pkppkqsmall/MSPM0G3507-NUEDC-H-Ball-Car/Firmware/KnowledgeBase/car_parameters.md

# 小车参数记录

> 当前运行入口是 `App/MapRun/map_run.c`。本文只记录当前连续巡线地图程序
> 仍在使用的参数，完整操作见 [`../README_MAP_RUN.md`](../README_MAP_RUN.md)。

## 硬件方向

| 项目 | 当前约定 |
| --- | --- |
| 左轮 PWM 正值 | 小车前进方向 |
| 右轮 PWM 正值 | 硬件方向相反，由底层符号统一为小车前进 |
| 速度目标正值 | 小车前进 |
| yaw 正方向 | 串级控制假设左转为正，首次测试必须手动旋转确认 |

右轮方向统一在电机驱动内部完成：

```c
#define RIGHT_WHEEL_DIRECTION_SIGN (-1.0f)
```

应用层始终使用“左右轮正 RPM 都表示小车前进”的语义。

## 当前底盘

当前使用 WHEELTEC R3X 加大版三轮差速底盘。

| 项目 | 当前值 |
| --- | ---: |
| 底板外形 | `320 x 240 x 5 mm` |
| 左右驱动轮中心距 | 模型标注约 `214.2 mm` |
| 驱动轮轴至万向轮轴距 | 模型标注约 `204.7 mm` |
| 轮胎直径 | `65 mm` |

模型尺寸只用于建立初始参数，左右轮中心距和传感器前伸距离应在装车后实测。

## 电机和编码器

| 参数 | 当前值 |
| --- | --- |
| 编码器线数 | `13 PPR` |
| 当前等效计数倍频 | `2` |
| 减速比 | `1:28` |
| 电机轴每圈计数 | `13 * 2 = 26` |
| 车轮输出轴每圈计数 | `26 * 28 = 728`，现场实测约 `728` |
| 测速采样周期 | `20 ms` |

按 `65 mm` 轮径估算：

```text
每圈周长约 204.2 mm
每厘米约 35.65 count
```

## 电机驱动和速度环

| 参数 | 当前值 | 说明 |
| --- | ---: | --- |
| 电机死区补偿 | `56%` | 电机约在该占空比开始稳定转动 |
| 固定小底座 | `1%` | 高于死区的额外补偿 |
| 起步脉冲时间 | `0 ms` | 当前不启用额外起步脉冲 |
| 低速开环范围 | `0~30 RPM` | 直接按目标 RPM 映射 PWM |
| 速度环 Kp | `0.1` | 左右轮相同 |
| 速度环 Ki | `0.2` | 左右轮相同 |
| 速度环 Kd | `0` | 当前未使用 D |

速度测试目标可通过 `TARGET` 修改，PI 可通过 `PID` 修改。

## 灰度传感器

当前使用感为 8 路灰度模块的串行输出，黑线为 `1`、白底为 `0`。

| 项目 | 当前约定 |
| --- | --- |
| `INPUT1` / bit0 | 车头最左侧，单独命中显示 `00000001` |
| `INPUT8` / bit7 | 车头最右侧，单独命中显示 `10000000` |
| 探头权重 | `{-16.0, -8.0, -4.0, -2.0, 2.0, 4.0, 8.0, 16.0}` |
| 黑线偏左 | 误差为负 |
| 黑线偏右 | 误差为正 |
| 运行中丢线 | 保持最后有效灰度修正和左右轮目标，不自动停机 |

程序保留每次读取的原始位图，直接计算所有黑色探头的平均权重。
不使用位图多数表决或灰度误差低通。中心探头只给小目标角速度，
向外逐级增强；BNO085 失效时才使用 `Kp=2.5` 的灰度 P 回退。

## 当前地图巡线参数

参数分别位于 `App/MapRun/map_run.c` 和 `map_line_controller.c`。

| 参数 | 当前值 | 作用 |
| --- | ---: | --- |
| `MAP_RUN_Q2_BASE_SPEED_RPM` | `120.0` | M1 / 第 2 问基础速度 |
| `MAP_RUN_Q2_BRAKE_HOLD_MS` | `100` | M1 横线确认后的主动刹车时间 |
| Q3 正程预测切换 | `Peak=X+0.85*clamp(V,0,80)`，预测 `>=+39 mm` | `0.60 s` 预测实测正峰值仍约 `+69 mm`，延长预测窗以覆盖摄像头采样和步进换向滞后 |
| Q3 固定折返驱动 | `+3.0° -> RawX<=+20 mm 且 V<=-100 mm/s` | `+34 mm` 制动只到 `-28 mm`，`0 mm` 制动冲到 `-84 mm`，取插值折中 |
| Q3 终点目标位置 | `-50 mm` | M2 / 第 3 问最后稳定点 |
| Q3 终点最高速度 / 位置比例 | `35 mm/s / 1.2/s` | 终点自适应阶段随剩余距离主动减速 |
| Q3 终点包络渐变区 | `6~15 mm` | 近端位置反馈与远端速度反馈线性切换 |
| Q3 速度能量制动 | `|V|+40 mm/s / 70 mm / 增益3.0 / -1.5~-3.0° / 75%单帧速度` | 左移阶段只增强负制动角，先消耗返程动能 |
| Q3 负端预捕获 | `RawX<=-35 mm / 融合|V|<=70 mm/s / +2.2° / >=100 ms` | 上轮在真实回弹后才触发，放宽动量门槛以提前约一帧补偿步进换向延迟 |
| Q3 终点自适应交接下限 | `RawX<-30 mm` | `-35 mm` 静止时直接交给终点自适应；只有停在 `-30 mm` 之前才重新固定送球 |
| Q3 捕获位置-速度 PD | `Vref=clamp(-1.5*(RawX+50), ±60 mm/s)`；`Angle=1.8+clamp(0.040*(V-Vref), ±2.4°)` | 首轮 `5.13 s` 完成但出现一次 `-15~-67 mm` 摆动；降低位置速度并提高阻尼，不使用积分 |
| Q3 终点捕获 | 即时速度与聚合速度同时 `|V|<=12 mm/s`，连续 `75 ms` | 首次回弹继续由能量制动吸收；若双速度低速时仍在 `-40 mm` 前，则恢复固定 `+3.0°` 继续送球，进入负端后才允许冻结或进入终点自适应 |
| Q3 静摩擦位置补偿 | `8 mm / 6 mm/s / 0.5 mm / ±4.5°` | 低速且连续帧几乎不动时直接下发破静摩擦目标角，不再逐帧爬坡；检测到位移后恢复滤波和 `±3.5°` 普通限位 |
| Q3 高速越界制动 | `15 mm/s / ±4.5° / 5 s` | 进入终点闭环保留当前制动角的受限部分；仅在越过目标且继续远离时绕过一次角度斜率 |
| Q3 低动确认 / 终点验稳 | `100 ms / 250 ms` | 连续低动后冻结当前实际角度；冻结窗口摆幅 `<=2 mm` 且末端球速 `<=4 mm/s` 才完成，完成后仅离开 `-60~-40 mm` 才恢复自适应 |
| Q3 终点初始平衡偏置 | 制动角限制到 `±2.0°` 后接管 | 以 `+1.8°` 为负端坡度初估，再由积分学习当前管段的不水平、弯曲和静摩擦 |
| `MAP_RUN_Q4_BASE_SPEED_RPM` | `88.0` | M3 / 第 4 问 A→B 巡航速度 |
| `MAP_RUN_Q4_START_SPEED_RPM` | `30.0` | M3 最低可用起步速度 |
| `MAP_RUN_Q4_START_HOLD_MS` | `200` | 起步前先让滚球闭环稳定 |
| `MAP_RUN_Q4_START_RAMP_MS` | `1400` | M3 从 30 通过 S 曲线升到 88 RPM |
| `MAP_RUN_Q4_START_FF_PEAK_DEG` | `-1.30°` | 起步加速度前馈；仅在 `X>=-2 mm` 后按回中速度退出，`10 mm/s` 时完全退出 |
| Q4 起步预置角 / 渐入 / 渐出 | `-0.85° / 180 ms / 600 ms` | 提前让步进到位，并覆盖底盘由 0 升到最低可用 30 RPM 后的早期扰动 |
| `MAP_RUN_Q4_BRAKE_FF_PEAK_DEG` | `+0.70°` | 更长距离减速阶段的前馈峰值 |
| `MAP_RUN_Q4_FINAL_STOP_RAMP_MS` | `900 ms` | 越过 B 点后把当前左右轮 PWM 按 S 曲线缓慢降到 0 |
| `MAP_RUN_Q4_FINAL_STOP_FF_PEAK_DEG` | `+0.45°` | 适配较缓停车斜坡的钟形制动项 |
| `MAP_RUN_Q4_STOP_FF_DEG` | `+0.80°` | PWM 归零后仅在球位于正侧且继续向正侧滚动时保留；反向回中或 `X<-8 mm` 时禁用 |
| `MAP_RUN_Q4_STOP_FF_HOLD_MS` | `300 ms` | 接球角最长保持时间 |
| `MAP_RUN_Q4_STOP_FF_FADE_MS` | `500 ms` | 接球角无反向回中时的平滑退出时间 |
| Q4 中心保护死区 | `2 mm` | 小偏差仍交给原 PID，超过后更早加强纠偏 |
| Q4 中心保护增益 / 上限 | `0.055°/mm / 0.75°` | 仅在静止、远离中心或回中偏慢时介入 |
| Q4 短窗估速 / 阻尼 | `35~140 ms / 0.018°/(mm/s) / 0.90°` | 换向时优先采用新方向，抑制低摩擦时反复穿过中心 |
| Q4 行驶回中最高速度 / 位置比例 | `15 mm/s / 0.50/s` | 以 `0 mm` 为终点，更早对回中速度制动 |
| Q4 停车保持最高速度 / 位置比例 | `15 mm/s / 0.5/s` | `±10 mm` 内柔和保持；超界且球速不高于 `6 mm/s` 时附加 `0.10°/mm`、最大 `1.0°` 回中保护 |
| Q4 中心误差缩放 | `0.5` | 仅在误差绝对值不超过 `2.1` 时生效 |
| Q4 小球目标位置 | `0 mm` | 按键起跑后自动开启中心保持 |
| Q4 起跑位置范围 | `±10 mm` | 超出范围拒绝起跑，避免一开始即失分 |
| Q4 摄像头失联阈值 | `300 ms` | 超时后停用旧位置反馈，只保留底盘加减速前馈；底盘继续循迹 |
| 短时丢球预测 | `40 ms 后启动 / 100 ms 衰减 / ±12 mm` | 用最后有效位置和衰减球速跨过少量无效帧或断帧 |
| `MAP_RUN_BALL_BASE_SPEED_RPM` | `85.0` | M4/M5 共用稳态基础速度 |
| `MAP_RUN_BALL_START_SPEED_RPM` | `30.0` | M4/M5 静止预置后的最低可用起步速度 |
| `MAP_RUN_BALL_START_HOLD_MS` | `200` | 底盘保持静止，让摆杆预置角先到位 |
| `MAP_RUN_BALL_START_RAMP_MS` | `1400` | 带球模式从 30 通过 S 曲线升到 85 RPM |
| M4/M5 起步预置 / 前馈 | `-1.05° / 180 ms / 600 ms`，峰值 `-1.55°`，起步合成限幅 `2.2°` | 避免共用 `1.5°` 限幅截断预置角与起步前馈 |
| M4/M5 短窗估速 / 阻尼 | `35~140 ms / 0.018°/(mm/s) / 0.90°` | 换向时优先采用新方向，提前撤销回拉角 |
| M4/M5 终点缓停 / 前馈 | `500 ms`，峰值 `+0.80°` | 捕获左右轮 PWM 后同比例平滑降到 0 |
| M4/M5 行驶回目标包络 | `20 mm/s / 0.75/s` | Q5 回中心，Q6 回本轮指定位置 |
| M4/M5 停车保持包络 | `15 mm/s / 0.5/s` | 通过 A 后继续保持；漂出 `±10 mm` 且近似静止时启用温和位置保护 |
| M4/M5 起跑误差 / 运行允许误差 | `10 mm / 10 mm` | 起跑超差拒绝启动，运行超差记为 OVER |
| M4/M5 视觉失联阈值 | `300 ms` | 超时不停车，摆杆回标定水平，恢复后接管 |
| M4/M5 完成时间 | `30 s` | 与最大误差共同决定 PASS/LATE/OVER |
| M4/M5 精简蓝牙周期 | `250 ms` | 自动输出 `Q5BALL/Q6BALL`，完成后延续 5 s；完整 BALLLOG 开启时暂停 |
| 带球中心误差缩放 | `0.25` | 误差绝对值不超过 `2.1` 时生效，降低直线左右摆动 |
| 带球转向比例 | `当前基础速度 / 80` | 稳态 85 RPM 时约为 `1.063` |
| 带球内轮最低目标 | `25 RPM` | M3/M4/M5 边缘探头触发时不再直接降为 0 |
| 带球外轮最高目标 | `95 RPM` | 满纠偏时比稳态基础速度最多增加 10 RPM |
| 带球单轮目标上升 | `3 RPM/10 ms` | 限制突然加速，减速不延迟 |
| 带球外侧误差增益 | `1.5` | 只放大误差绝对值超过 `2` 的部分 |
| 带球中心速度恢复 | `1 RPM/10 ms` | 降低带球模式出弯加速度 |
| 右弯保持最低角速度 | `30 deg/s` | 灰度回中后仍维持半圆所需曲率 |
| 右弯提前触发 | 右三探头连续 2 次 | 仅在靠近 B/D 的编码器区域生效 |
| 弯尾最低角速度 | `170~175°` 内由 `30` 降至 `10 deg/s` | 减少进入直道时的残余旋转 |
| 右弯正常退出 | `175° + 中线 3 次` | BNO085 跨界累计角与灰度共同判断 |
| 右弯强制释放 | `190°` | 中线漏检时避免持续右转 |
| 出弯灰度渐入 | `50 ms` 消旋 + `200 ms` 渐入 | 避免灰度控制由 0 瞬间恢复造成摆动 |
| 出弯对正阈值 | `5 deg/s，连续 3 次`，最长 `400 ms` | 稳定后提前结束，超时则恢复普通巡线 |
| `MAP_RUN_LOW_TARGET_STOP_RPM` | `30.0` | 内轮目标不高于该值时直接停驱动 |
| 灰度到目标角速度 | `-5.0 * line_error` | 黑线偏右时生成负角速度 |
| 目标角速度上限 | M1/Q2 无；其它模式 `±60 deg/s` | 第二问使用完整灰度误差 |
| yaw 角速度低通 | `alpha=0.35` | 抑制相邻 yaw 求导噪声 |
| 角速度前馈 | `0.55 RPM/(deg/s)` | 根据底盘几何估算差速 |
| 角速度 P | `0.15 RPM/(deg/s)` | 修正目标与实测角速度差 |
| 差速上限 | M1/Q2 无；其它模式 `±40 RPM` | 带球模式继续保留保护 |
| 中心速度恢复 | M1/Q2 无；M3 `2 RPM/10 ms`；M4/M5 `1 RPM/10 ms` | M1 外轮固定基础速度 |
| BNO085 回退 | `150 ms` | 数据超时后使用灰度 `Kp=2.5` |
| 地图单轮目标上限 | 无 | 最终 PWM 仍由底层限制在 `100%` |
| `MAP_RUN_CONTROL_PERIOD_MS` | `10` | 灰度外环周期 |
| `MAP_RUN_SPEED_PERIOD_MS` | `20` | 编码器测速和速度 PI 周期 |
| `MAP_RUN_TELEMETRY_PERIOD_MS` | `50` | VOFA 输出周期 |

M1 起跑后使用 `120 RPM`；M3 巡航使用 `88 RPM`；M4/M5 静止预置
`200 ms` 后从 `30 RPM` 在 `1400 ms` 内升到 `85 RPM`。M3 在中心 4/5 号探头区域把误差与
回退修正减半；M4/M5 复用相同中心整形，不再低通误差，并按当前
基础速度相对 `80 RPM` 的比例缩放转向需求。
运行中全白时，M4/M5 保持最后灰度误差并继续角速度环，其他模式保持
最后左右轮目标；重新找到黑线后继续使用实时灰度误差。
M1/Q2 转弯时外轮固定 `120 RPM`，只降低内轮，不再使用中心速度缓慢
恢复。M4/M5 将内轮最低目标保持在 `25 RPM`，
外轮按转向强度提高并限制在 `90 RPM`，单轮目标增加量限制为每周期
`3 RPM`；减速不延迟。M3 出弯中心速度每周期恢复 `2 RPM`，M4/M5
每周期恢复 `1 RPM`。M4/M5
保持 `85 RPM` 基础速度，但将绝对值超过 `2` 的误差增量放大 `1.5`
倍，让弯道转向更早建立。B/D 附近最外两路可在宽窗口内触发，右侧
第三路在更靠近弯道的位置连续确认 2 次也可提前触发。保持期间 BNO085
累计右转角；`170~175°` 逐步减小最低右转量，随后通过灰度渐入进入直道。

左右轮目标为：

```text
target_yaw_rate = clamp(-5.0 * line_error, -60, +60)
turn_rpm = clamp(0.55 * target_yaw_rate
                 + 0.15 * (target_yaw_rate - measured_yaw_rate),
                 -40, +40)
center_rpm = selected_base_rpm - abs(turn_rpm)
left_target  = center_rpm - turn_rpm
right_target = center_rpm + turn_rpm
```

串级失效时回退到灰度 P：普通模式外轮保持基础速度，M4/M5 外轮按
转向强度提高至最高 `95 RPM`；内轮仍按 P 修正降低。普通模式任一路
目标不高于 `30 RPM` 时
直接设为 `0 RPM`；M3/M4/M5 则最低保持 `25 RPM`，避免边缘触发产生
`0↔85 RPM` 跳变。

编码器不直接生成弯道差速，但 M4/M5 使用宽距离窗口限制右弯保持的
触发路段；M1/M4/M5 还用于测速、反馈故障保护和一圈终点解锁，
M3 额外用于 A→B 停车。

## 一圈停车参数

| 参数 | 当前值 | 作用 |
| --- | ---: | --- |
| `MAP_RUN_START_LINE_LEAVE_COUNTS` | `120` | 防止起点横线立即被当作终点 |
| `MAP_RUN_LAP_ARM_COUNTS` | `21300` | 达到该路程后允许 3 路黑线触发终点 |
| `MAP_RUN_BALL_FIXED_STOP_COUNTS` | `25590` | Q5/Q6 平均编码器写死停车距离，比上一实测点缩短约 0.5 m |
| `MAP_RUN_BALL_FIXED_STOP_MAX_COUNTS` | `28220` | IMU 异常时强制停车，防止 Q5/Q6 无限绕圈 |
| `MAP_RUN_BALL_FIXED_STOP_TURN_DEG` | `360` | Q5/Q6 正常同时要求的累计实际转动量；IMU 无新数据、超时或近似 0° 时由编码器终点接管 |
| `MAP_RUN_FINISH_HEADING_ARM_COUNTS` | `21000` | M1 最后一段启用起跑航向外环 |
| `MAP_RUN_FINISH_HEADING_KP_RATE_PER_DEG` | `2.0` | 航向误差到目标角速度的比例 |
| `MAP_RUN_FINISH_HEADING_RATE_LIMIT_DEG_S` | `40` | 航向修正最大角速度，单位 deg/s |
| `MAP_RUN_FINISH_LINE_ACTIVE_MIN` | `3` | 5 cm 横线至少同时命中的黑色探头数 |
| `MAP_RUN_START_LINE_LEAVE_CONFIRM` | `3` | 离开起点连续确认次数 |
| `MAP_RUN_FINISH_LINE_CONFIRM` | `3` | 终点横线连续确认次数 |

M1 的编码器距离只负责解锁终点识别，真正停车条件仍是再次检测到 A 点横线，
即 `21300 count` 后至少 3 路黑线连续 3 帧。M4/M5 不再使用横线，平均
编码器达到 `25590 count` 且 BNO085 累计实际转动达到 `360°` 后直接缓停；若 IMU 无新数据、已超时或全程转角近似 `0°`，则由该编码器终点直接触发。
M1 在相同距离后将起跑 yaw 作为目标航向，并把航向误差转换成目标角速度
叠加到灰度外环，再由 BNO085 角速度内环和轮速 PI 完成出弯对正。
M1 横线确认后让 AT8236 保持 `IN1=IN2=1` 主动刹车 `100 ms`，随后
恢复四路低电平；M4/M5 不使用该急刹策略，关闭底盘后继续运行滚球
位置跟踪并切换到较慢停车保持包络。

## 第 4 问 A→B 停车参数

| 参数 | 当前值 | 作用 |
| --- | ---: | --- |
| `MAP_RUN_Q4_SENSOR_ARM_COUNTS` | `4500` | 该距离后才允许右二探头锁存 B 点特征 |
| `MAP_RUN_Q4_RIGHT_SECOND_MASK` | `0x40` | 右边第二个探头，即 bit6 |
| `MAP_RUN_Q4_BRAKE_START_COUNTS` | `4950` | B 点前开始平滑减速 |
| `MAP_RUN_Q4_TARGET_STOP_COUNTS` | `5700` | 已锁存右二黑时，越过 B 点约 9.8 cm 后触发缓停 |
| `MAP_RUN_Q4_MAX_STOP_COUNTS` | `5950` | 传感器未锁存时的缓停兜底触发距离 |
| `MAP_RUN_Q4_APPROACH_SPEED_RPM` | `35.0` | 到正常停车距离时的中心速度 |

第四问前馈在底盘速度轨迹存在加速度时叠加到滚球控制角，普通巡航阶段为
`0°`。距离减速前半段升到 `+0.70°` 后保持，直至最终停车连续接管。
达到终点条件后，程序捕获左右轮实际占空比并在 `900 ms` 内按
S 曲线降到 0；同期从 `+0.70°` 连续接管并叠加峰值 `+0.45°` 的钟形项。
停车后只有小球仍位于正侧并继续向正侧滚动时才保留接球角；若已经越过
中心或已经反向，则不重新施加固定正角，避免停车后二次推向负侧。
`BALL?` 和 `MAP?` 的
`FF` 字段可用于确认实际方向和幅值。`MAP?` 的 `Guard/Damp` 字段显示第四问
中心保护输出；球处于 X 正侧时为正，处于 X 负侧时为负。球已经按规划
速度向中心运动时 `Guard` 会降为 0，`Damp` 则始终与小球速度同号以提供阻尼。

`5700/5950 count` 只负责触发最后缓停，完成时间还会增加最多 `0.9 s`，
预计多前进约 `2~3 cm`。纯计时不参与停车，OLED 只显示实测总用时。

## 按键

| 按键 | 引脚 | 当前作用 |
| --- | --- | --- |
| B21 / PIN_Button | `PB21` | 短按启动或立即停车；M5/Q6 短按先采集当前球位目标；停止时长按进入灰度校准 |
| SW1 / PIN_Button_SW1 | `PA29` | 停止时选择上一个题目模式 |
| SW2 / PIN_Button_SW2 | `PA30` | 停止时选择下一个题目模式 |

题目模式为 `M1=第2问`、`M2=第3问`、`M3=第4问`、`M4=第5问`、
`M5=第6问`。上电默认 M1；M1 已接入第 2 问整圈运行，M2 已接入
静止滚球 `0 -> +5 cm -> -5 cm`，M3 已接入 A→B 底盘运行，M4/M5
已接入共用的 85 RPM 带球循迹、自动滚球闭环、30 s/最大误差统计；
M4 固定中心目标，M5 使用赛前保存的任意指定目标。

## 蓝牙串口

| 项目 | 当前值 |
| --- | --- |
| UART | `UART0` |
| RX | `PA11` |
| TX | `PA10` |
| 波特率 | `115200` |

常用命令：

```text
STOP
TARGET,50
TARGET,50,48
TARGET?
PID,0.1,0.2,0
PID?
START
CAR?
LINE?
MAP?
MODE?
MAP
HELP
```

`TARGET` 会选择速度测试模式，`MAP` 会选择地图巡线模式；随后发送
`START` 启动当前所选模式。`MODE?` 查询按键选中的题目模式。M1 地图
模式使用灰度位置、yaw 角速度和轮速 PI 串级，不计算编码器路段前馈。

## 调参顺序

1. 确认左右电机与编码器方向一致。
2. 停机时用 `LINE?` 确认左右灰度符号没有反。
3. 手动向左旋转车身，使用 `MAP?` 确认实测 yaw 角速度为正。
4. 使用 `MAP?` 核对灰度误差、目标/实测角速度、串级状态和左右轮目标。
5. 左右摆动先调整灰度到角速度增益或角速度 P，不要先改速度 PI。
6. 圆弧半径不对先调整角速度前馈，再考虑统一基础速度。
7. 运行中丢线不会自动停机，实车测试时必须保留人工停机手段。
