pkppkqsmall/MSPM0G3507-NUEDC-H-Ball-Car/Firmware/KnowledgeBase/tuning_log.md

# 调参记录

## 文档用途

每次改参数后，把场地、现象、处理和实际结果写在这里。当前基准以
`App/MapRun/map_run.c` 的椭圆地图连续巡线为准。

## 记录模板

```text
日期：
场地/赛道：
电池电压：
基础速度：
巡线参数：
速度环参数：
现象：
处理：
结论：
下一步：
```

## 当前基准参数

| 分类 | 参数 | 当前值 |
| --- | --- | ---: |
| 基础速度 | 题目模式 | M1 `120`、M3 `30→88 RPM/1400 ms`；M4/M5 `200 ms` 预置后 `30→85 RPM/1400 ms` |
| 目标速度渐变 | 地图巡线 | M1 外轮固定基础速度；M3 出弯恢复 2 RPM/10 ms，M4/M5 为 1 RPM/10 ms |
| 灰度到目标角速度 | 外环 | `-5.0`；M1/Q2 不限幅，其它模式限制 `±60 deg/s` |
| yaw 角速度低通 | 内环反馈 | `alpha=0.35` |
| 角速度前馈 / P | 差速输出 | `0.55 / 0.15` |
| 差速上限 | `turn_rpm` | M1/Q2 无；其它模式 `±40 RPM` |
| 灰度 P 回退 | BNO085 超时 | `Kp=2.5`，`150 ms` 后启用 |
| 内轮低速处理 | `MAP_RUN_LOW_TARGET_STOP_RPM` | `<=30 RPM` 时停驱动 |
| 灰度外环周期 | `MAP_RUN_CONTROL_PERIOD_MS` | `10 ms` |
| 速度内环周期 | `MAP_RUN_SPEED_PERIOD_MS` | `20 ms` |
| VOFA 周期 | `MAP_RUN_TELEMETRY_PERIOD_MS` | `50 ms` |
| 速度环 Kp | 左右轮 | `0.1f` |
| 速度环 Ki | 左右轮 | `0.2f` |
| 运行中丢线 | 地图巡线 | 保持最后有效修正和左右轮目标，不自动停机 |

## 已知结论

| 主题 | 结论 |
| --- | --- |
| 巡线外环 | 灰度权重平均生成目标 yaw 角速度，不使用灰度 I/D 或路段前馈。 |
| 角速度内环 | 相邻 yaw 求导并低通，前馈加 P 反馈生成左右差速。 |
| 速度内环 | 高于 30 RPM 使用 `PI + 死区补偿`。 |
| 目标变化 | M4/M5 平滑起步，其余模式直接给基础速度；转向立即生效；出弯中心速度缓恢复；丢线保持原目标。 |
| 左右摆动 | 优先调整灰度到角速度增益或角速度 P，不先修改速度 PI。 |
| 圆弧跟随 | 先核对目标/实测角速度符号，再调整角速度前馈或基础速度。 |
| 丢线 | 保留最后灰度 P 方向、基础速度和左右轮目标，不自动停机。 |
| 编码器 | A 相双边沿、B 相判向，车轮实测约 728 count/圈。 |
| 一圈停车 | 编码器负责终点解锁，A 点横线负责最终停车确认。 |

## 2026-05-05

| 项目 | 内容 |
| --- | --- |
| 场地/赛道 | 旧小车循迹赛道 |
| 电池电压 | 未记录 |
| 默认速度 | `50 RPM` |
| 现象 | 巡线有突然加速感。 |
| 处理 | 在巡线外环加入修正变化限速，并在起停和模式切换时清零修正状态。 |
| 结论 | 已提交 Git：`45d5cb5 Smooth line-follow correction transitions`。 |
| 后续价值 | 这是旧状态机的历史方案；当前 MapRun 已暂停所有巡线目标斜率。 |

## 2026-07-10

| 项目 | 内容 |
| --- | --- |
| 场地/赛道 | 旧小车循迹赛道 |
| 电池电压 | 未记录 |
| 默认速度 | `50 RPM` |
| 现象 | 左右摇晃偏大，巡线修正和目标速度变化偏激进。 |
| 处理 | 降低旧巡线增益、最大修正量和目标变化速度，并减小中间探头权重。 |
| 结论 | 经验保留；当前 R3X 底盘需要重新实测，不能直接照搬旧参数。 |

## 2026-07-29 R3X 地图基准

| 项目 | 内容 |
| --- | --- |
| 场地/赛道 | H 题椭圆地图，R3X 320 x 240 mm 底盘 |
| 电池电压 | 待记录 |
| 基础速度 | `60 RPM`，从 `32 RPM` 平滑起步 |
| 巡线参数 | 增益 `1.80`，补偿不独立限幅，修正斜率 `0.15 RPM/ms` |
| 安全保护 | 起跑全白拒绝启动；持续约 150 ms 丢线停机；无编码器反馈停机 |
| 现象 | 新底盘直接冲出线，旧丢线逻辑会在全白后继续直行。 |
| 处理 | 改为保持最后找线方向、短时降速和持续丢线强制停车；增加 `LINE?` 静态诊断。 |
| 结论 | 源码和构建验证通过，60 RPM 的圆弧稳定性仍需实车验证。 |
| 下一步 | 记录电池电压、直线摆幅、圆弧最大误差和一圈用时。 |

## 2026-07-29 100 RPM 比赛配置

| 项目 | 内容 |
| --- | --- |
| 场地/赛道 | H 题 1.5 m 直线加半径 0.5 m 双半圆 |
| 速度规划 | 直线 `100 RPM`，右弯 `95 RPM`，终点降到 `60 RPM` |
| 前探距离 | 灰度至驱动轮轴线约 `13 cm`，对应 `463 count` |
| 弯道前馈 | 几何值 `20.3 RPM`；实车转向不足后改为 `1.5` 倍，即约 `30.5 RPM`，左/右基础目标约 `125.5/64.5 RPM` |
| 灰度控制 | 非线性权重加浮点位置低通，`Kp=5.0, Kd=0.05`，不再逐位多数表决 |
| 周期 | 灰度 `10 ms`，速度 PI `20 ms`，VOFA `50 ms` |
| 理论用时 | 约 `18.5 s`，尚未完成实车验收 |
| 风险 | 电机在 115 RPM 附近的负载跟随能力尚未验证 |

## 2026-07-30 简化为灰度 P

| 项目 | 内容 |
| --- | --- |
| 基础速度 | 全程 `100 RPM`，启动后直接给定 |
| 灰度权重 | `{-16, -8, -4, -2, 2, 4, 8, 16}`；中心轻修正、外侧强修正 |
| 灰度控制 | `line_p = 2.5 * line_error` |
| 速度内环 | 左右轮 PI：`Kp=0.1, Ki=0.2`，周期 `20 ms` |
| 已移出控制链 | 编码器 B/C/D 路段规划、弯道前馈、灰度 D、误差低通、修正斜率和基础速度渐变 |
| 出弯调整 | 中间权重减小以抑制反复过冲 |
| 内轮调整 | 外轮不再加速，全部 `2P` 差速改由内轮降速；内轮目标不高于 `30 RPM` 时停驱动 |
| 直线调整 | 单路命中从中心到外侧时，内轮目标约为 `90、80、60、0 RPM`，降低目标突变对小球的影响 |
| 丢线调整 | 运行中全白保持丢线前目标，不再降速或自动停机 |
| 保留功能 | 编码器反馈保护、人工停机和 A 点一圈停车 |

## 2026-07-30 尝试加入 yaw 角速度串级

| 项目 | 内容 |
| --- | --- |
| 回退点 | Git `13cd0df`，保留纯灰度 P 版本 |
| 控制结构 | 灰度位置 -> 目标 yaw 角速度 -> BNO085 角速度前馈/P -> 轮速 PI |
| 目标角速度 | `-5 * line_error`，限制 `±60 deg/s` |
| 角速度估计 | BNO085 `50 Hz` 新样本求导，处理 `±180°` 跨界，低通 `alpha=0.35` |
| 差速参数 | 前馈 `0.55`，P `0.15`，`turn_rpm` 限制 `±40 RPM` |
| 出弯处理 | 转向差速立即更新；普通模式中心速度每 `10 ms` 最多恢复 `2 RPM`，M4/M5 为 `1 RPM` |

## 2026-07-30 题目模式框架

| 项目 | 内容 |
| --- | --- |
| 模式映射 | `M1=第2问`，依次到 `M5=第6问` |
| 上电默认 | `M1/Q2` |
| 模式按键 | 停止时 SW1 上一个、SW2 下一个，M1~M5 循环 |
| 启停按键 | B21 保持短按启停、长按灰度校准 |
| 当前实现 | M1 一圈；M2 静止滚球；M3 A→B 自动中心保持；M4/M5 共用 85 RPM 带球循迹 |
| 安全策略 | M2/M3 检查软件零点、摄像头新帧和中心起始位置；M3 失联停底盘 |

## 2026-07-30 第 4 问 A→B 底盘模式

| 项目 | 内容 |
| --- | --- |
| 模式 | `M3/Q4` |
| 题目距离/限时 | `1.5 m / 8 s` |
| 理论 7 秒速度 | 约 `63 RPM` |
| 程序速度轨迹 | 保持 200 ms，`30→88 RPM / 1400 ms`，4950 count 后降至 35 RPM，终点触发后 `500 ms` PWM S 曲线缓停 |
| 底盘加速度前馈 | 起步前先渐入 `-0.45°`，再叠加峰值 `-1.30°` 且回中速度达到 `10 mm/s` 时退出；距离减速保持 `+1.00°`；最终缓停叠加 `+0.80°`，PWM 缓降期间和归零后均在反向回中时提前退出 |
| M3 行驶中心保护 | 第四问专用保护使用 `2 mm` 死区、`0.055°/mm`、最大 `0.75°` |
| M3 自动诊断 | 第四问每次起跑自动开启 `100 ms` `BALLLOG`，重新输出表头和首条样本 |
| M3 位置-速度回中 | 第四问行驶速度包络为 `15 mm/s / 0.50/s`，短窗速度阻尼为 `0.018°/(mm/s)`、最大 `0.90°`；停车保持为 `15 mm/s / 0.5/s` |
| M3 振荡日志复查 | 实测停车前 `X=+36 mm、V=+38.5 mm/s`，停车后位置保护仍保持 `±0.90°`，会抵消速度反馈的反向制动；静摩擦 kick 与积分在该段均未激活 |
| M3 位置速度解耦修正 | 行驶包络降为 `25 mm/s / 1.0/s`，中心保护在回中速度达到规划值后退出；停车保持改为 `15 mm/s / 0.5/s` 并关闭额外位置保护 |
| M3 二次日志复查 | 首段峰值改善到约 `-16/+24 mm`，左右停车 PWM 恢复为 `57.4/57.8%`；但视觉连续失联约 `2.1 s` 并覆盖 B 点减速区，恢复后钢球前滚到 `+35 mm` |
| M3 丢球与外移加强 | 远离中心保护调整为 `0.080°/mm`、最大 `1.00°`；持续失联时禁用旧位置反馈，但保留底盘加减速前馈，并在告警中输出帧数、接收字节数和溢出数 |
| M3 停车前冲 | 实测 `35 RPM` 直接断 PWM 时钢球沿 `+X` 冲出约 `20 mm`；改为捕获当前左右轮占空比并在 `400 ms` 内物理缓降，避免低速开环死区让“目标 RPM 缓降”失效 |
| 视觉短时丢球 | 单帧 `valid=0` 原先会立即失联；现兼容无效帧和超过 `40 ms` 的断帧，最多做 `100 ms` 速度衰减外推，预测位移限制 `±12 mm`，恢复帧低通接回 |
| M3 视觉长期失联策略 | 比赛中停车无分，因此超过 `150 ms` 后只让摆杆回软件水平，底盘继续完成 A→B；视觉恢复后自动接管并输出一次恢复提示 |
| M3 最新实测复查 | 摄像头接收排空后全程未进入失联，但起步仍到 `-33 mm`，随后多次穿过中心，最终 `7.82 s / 32 mm OVER`；起步前馈改为 `-0.90°`，行驶包络降为 `20 mm/s / 0.75/s`，并从 `4950 count` 以 `+0.65°` 前馈提前减速。 |
| M3 第二轮复查 | 起步负峰改善为约 `-22 mm`、首次正峰约 `+10 mm`，但摄像头曾连续约 `1.7 s` 无完整数据；停车捕获 PWM 为 `59.5/0.0%`，证明 Q4 内轮低速被错误截成 0。Q4 起步前馈提高到 `-1.10°`，断帧阈值放宽到 `300 ms`，内轮非零目标最低保持 `25 RPM`。 |
| M3 第三轮复查 | 起步最低约 `-7 mm`、巡航大多在 `-7~+8 mm`，停车双轮 PWM 为 `59.1/57.0%`，但最终停车仍从约 `+7 mm` 冲到 `+22 mm`。距离减速前馈提高到 `+1.00°`，最终 PWM 缓降延长到 `500 ms`，按本轮 `7.74 s` 估算总时间约 `7.84 s`。 |
| M3 第四轮复查 | 新配置完成时间 `7.70 s`、双轮停车 PWM `59.9/57.0%`，起步最低约 `-10 mm`；但距离减速前馈在最终停车前回到 0，小球已从约 `-1.7 mm` 加速到 `+11 mm`，停车后峰值约 `+20 mm`。改为减速峰值保持，并从 `+1.00°` 连续接入最终制动。 |
| M3 第五轮复查 | 连续前馈交接后完成时间 `7.23 s`、停车 PWM `59.8/57.0%`；停车阶段小球保持约 `+4~5 mm`，随后回到约 `+1 mm`，证明停车前冲已解决。本轮 `MaxBallErr=16 mm` 全部来自起步负峰 `-16 mm`，后续若继续优化应只处理起步阶段。 |
| M3 低摩擦复测 | 最新日志 `7.34 s`、无持续失联，球在巡航中达到 `-15~+23 mm`，控制角在约 `-2.3~+2.6°` 间反复换向，步进最大滞后约 `281 pulse`；停车完成后又前滚到约 `+21 mm`。因此收慢回中包络、加入 Q4 专用速度阻尼，并让起步/停车前馈按实测回中速度提前退出。 |
| M3 第六轮复查 | 最新日志完成 `8.20 s`，巡航振幅由约 `-14/+6 mm` 逐步放大到 `-16/+21 mm`；三帧球速在换向后约一拍仍保留旧符号，位置保护与阻尼短时继续加能量。新增 `35~140 ms` Q4 短窗估速与反号立即接管，将保护降为 `0.055°/mm、0.75°`、阻尼改为 `0.018°/(mm/s)、0.90°`；停车正前馈在 PWM 缓降期间也按回中速度退出。巡航提至 `88 RPM` 以回收约 `0.20 s`，等待实车验证。 |
| 右二探头 | `bit6 / 0x40`，4500 count 后允许锁存 |
| 正常缓停触发 | 已锁存右二黑且达到 `5350 count` |
| 兜底缓停触发 | 达到 `5600 count` |
| 理论时间 | 原触发时间基础上增加最多 `0.5 s`，仍小于 8 秒 |
| 滚球目标 | `0 mm`，保留赛前 PID/trim，起跑时清空旧积分并自动开启步进跟踪 |
| 起跑检查 | 软件零点有效、摄像头帧新鲜、`abs(X)<=10 mm` |
| 误差记录 | 使用原始摄像头位置记录全程最大绝对误差，`MAP?` 输出 `Max/Limit` |
| 到 B 后 | 只停底盘，滚球中心闭环继续保持 |
| 球控失效 | 摄像头超过 `150 ms` 未更新或闭环被关闭时，立即停止底盘和步进 |
| 失效处理 | 连续 `150 ms` 无有效角速度时回退到原灰度 P |
| 源码验证 | CCS 21 全量编译和链接通过，实车方向与增益待验证 |

## 2026-07-30 第 5、6 问基础循迹

| 项目 | 内容 |
| --- | --- |
| 模式 | `M4/Q5`、`M5/Q6` |
| 题目距离/限时 | 一圈约 `6.142 m / 30 s` |
| 基础速度 | `200 ms` 预置后 `30→85 RPM / 1400 ms` |
| 理论一圈时间 | 以实车测试为准 |
| 完成判断 | 21000 count 后解锁，至少 3 路黑线连续 3 帧 |
| M4/M5 起步 | `200 ms` 静止预置，随后 `30→85 RPM / 1400 ms` S 曲线 |
| M4/M5 灰度处理 | 复用 M3 中心误差乘 `0.5`，取消额外低通 |
| M4/M5 速度比例 | 转向误差乘当前基础速度/80；85 RPM 时约 `1.063` |
| M4/M5 边缘缓冲 | 内轮最低 `25 RPM`、外轮最高 `95 RPM`；单轮目标每 10 ms 最多增加 `3 RPM` |
| M4/M5 提前转向 | 误差绝对值超过 2 后，将超出部分放大 `1.5` 倍 |
| M4/M5 短暂丢线 | 保留最后灰度误差并继续更新 BNO085 角速度内环 |
| M4/M5 出弯恢复 | `1 RPM / 10 ms` |
| M4/M5 半圆保持 | 最外两路宽窗口触发，或右三探头在靠近 B/D 后连续 2 次提前触发；最低 `30 deg/s` 右转 |
| M4/M5 出弯对正 | `170~175°` 将最低右转降至 `10 deg/s`；退出后 `50 ms` 消旋并用 `200 ms` 渐入灰度，最长 `400 ms` |
| 异常释放 | 累计右转 `190°` 后取消最低右转约束，避免中线漏检导致绕圈 |
| M4 球控基线 | 按键起跑自动锁定 `0 mm`，复用 Q4 的 `20 mm/s、0.75/s` 行驶包络和位置保护 |
| M5 球控基线 | B21 短按时采集最新摄像头位置并锁定为本轮目标，不依赖蓝牙 |

## 2026-07-30 第 2 问终点主动刹车

| 项目 | 内容 |
| --- | --- |
| 原问题 | 实测整圈约 `19.9 s`，不能使用长距离预减速；横线后直接断 PWM 又会滑行 |
| 处理 | M1 基础速度升到 `115 RPM`，横线确认后主动刹车 `100 ms` |
| 最终停车 | 仍由至少 3 路黑线连续 3 帧确认，不改为纯编码器停车 |
| 刹车模式 | AT8236 两输入同时置高，低侧慢衰减；结束后恢复四路低电平 |
| 适用范围 | 仅 M1/Q2；M4/M5 有小球，不使用该急刹策略 |

## 2026-07-31 滚球位置 PID 初始实机基准

| 项目 | 内容 |
| --- | --- |
| 实机参数 | `Kp=0.0075`、`Ki=0.005`、`Kd=0.03` |
| 使用命令 | `BALL,PID,0.0075,0.005,0.03` |
| 当时结论 | 静止滚球测试表现较好，后续日志发现积分和执行速度仍不足 |
| 安全限制 | 摆杆目标角限制 `±4°`，积分输出限制 `±1.5°` |
| 后续验证 | 第 4~6 问带车运动时仍需重新检查滚球误差和振荡 |

## 2026-07-31 第 3 问静止滚球时序

| 项目 | 内容 |
| --- | --- |
| 模式 | `M2/Q3`，底盘电机全程关闭 |
| 题目路径 | `0 cm -> +5 cm -> -5 cm并稳定` |
| 时间要求 | `<=5 s` |
| 起动检查 | 步进已置零、摄像头新鲜、起始位置 `abs(X)<=15 mm` |
| +5 cm 判定 | 新摄像头帧中原始位置 `RawX>=+40 mm`，先短制动再折返 |
| -5 cm 判定 | `X=-60~-40 mm` 且 `250 ms` 内位移 `<=2 mm`；`RawX<=-40 mm` 只启动终点软制动 |
| 完成行为 | 停稳后冻结总时间并继续保持 `-50 mm`，显示 `PASS/LATE` |
| 实机 PID | 初版为 `0.0075,0.005,0.03`，后续积分调整见下一节 |

## 2026-07-31 摄像头延迟与超限回中补偿

| 项目 | 内容 |
| --- | --- |
| 已知延迟 | MaixCAM 图像与传输约 `100 ms` |
| 初始预测 | 默认外推 `60 ms`，可用 `BALL,DELAY,0~200` 调整 |
| 预测保护 | `speed × delay` 限制在 `±20 mm` |
| 近目标 | `abs(error)<=20 mm` 保留已验证 PID |
| 渐变区 | `20~60 mm` 在 PID 与速度包络之间线性混合 |
| 远端期望速度 | 最高 `80 mm/s`，并受 `1×距离` 与制动曲线限制 |
| 制动参数 | 按 `120 mm/s²` 保守减速度提前降低目标速度 |
| 积分策略 | 仅 `abs(error)<=20 mm` 且 `abs(speed)<=80 mm/s` 时积分 |

## 2026-07-31 滚球第二轮日志：执行器滞后与静差

| 项目 | 内容 |
| --- | --- |
| 日志长度 | `20.61 s`、207 个诊断样本 |
| 振荡表现 | 穿越中点 8 次，最大位置 `71.4 mm`、最大速度 `177.4 mm/s` |
| 执行器滞后 | 最大 `609 pulse`，2 kHz 下正负限位反向时间过长 |
| 最终静差 | 最后 30 帧均值 `-13.92 mm`，积分仍在负向增加 |
| STEP 调整 | `2000 Hz -> 4000 Hz`，高电平保持约 `10 us` |
| 角度限制 | `±4° -> ±3°`，减少过强加速并缩短两端反向距离 |
| 积分调整 | `Ki 0.005 -> 0.015`，加快克服静摩擦和固定零偏 |
| 当前状态 | 代码和 SysConfig 已编译通过，等待下一轮实机日志验证 |

## 2026-07-31 滚球第三轮日志：中心稳定

| 项目 | 内容 |
| --- | --- |
| 当前实机参数 | `Kp=0.0075`、`Ki=0.015`、`Kd=0.03` |
| 使用命令 | `BALL,PID,0.0075,0.015,0.03` |
| 执行器设置 | STEP `4000 Hz`，摆杆目标角限制 `±3°` |
| 稳定结果 | 小球稳定在 `X=+1.0 mm`，估算速度约 `0 mm/s` |
| 稳态补偿 | 积分输出约 `+0.47°`，用于克服机构静摩擦和水平零偏 |
| 跟踪结果 | 步进 `Pos=Tgt=81 pulse`，执行器滞后为 `0` |
| 当前结论 | 回中控制已经稳定，可以进入第 3 问 `0 -> +5 cm -> -5 cm` 往返测试 |

## 2026-07-31 摄像头升级为 40 FPS 直连

| 项目 | 内容 |
| --- | --- |
| 新链路 | 摄像头位置数据约 `40 FPS`，实测无明显传输延迟 |
| 默认预测 | `60 ms -> 0 ms`，避免第三题折返点提前反向 |
| 测速时间窗 | 仍保留至少 `30 ms` 聚合，抑制毫米坐标量化对 D 项的放大 |
| 调试接口 | `BALL,DELAY,0~200` 继续保留，后续发现固定延迟时可重新启用 |

## 2026-07-31 管道固定坡度补偿

| 项目 | 内容 |
| --- | --- |
| 测试条件 | 目标 `0 mm`，软件零点采用当前近似水平姿态 |
| 稳定现象 | 小球从 `+53 mm` 到 `+46 mm` 后静止，球速趋近 `0` |
| 执行器状态 | 步进无滞后，稳定命令角约 `+1.02°` |
| 判断 | 相对软件零点，管道重力水平角约为 `+1.0°` |
| 处理 | 新增独立 `level trim`，默认 `+1.0°`，动态 PID 和速度包络在其上叠加 |
| 调试命令 | `BALL,TRIM,-2~2`，仅允许在滚球闭环关闭时修改 |

## 2026-07-31 滚球静摩擦脱困补偿

| 项目 | 内容 |
| --- | --- |
| 双侧静止现象 | 小球曾分别停在 `+33 mm` 和 `-19 mm`，球速为 `0`，步进 `lag=0` |
| 判断 | 不属于步进滞后或 `±3°` 饱和，而是导轨静摩擦形成双向死区 |
| 进入条件 | `abs(error)>8 mm`、`abs(speed)<3 mm/s` 连续 `200 ms` |
| 补偿输出 | `0.35°` 起步，持续静止时按 `0.5°/s` 增加，最高 `0.90°`，仍受最终 `±3°` 限制 |
| 退出条件 | `abs(error)<=5 mm`、`abs(speed)>=10 mm/s` 或误差方向改变 |
| 诊断字段 | `BALL?` 显示 `Kick/Active/Wait`；`BALLLOG` 增加 `kick/kickms/kicka` |
| 负向复测 | `X=-53 mm` 时固定 `kick=-0.35°` 仍无法启动，因此改为有上限的自适应递增，避免同时放大已经正常的正向动作 |
| 最大补偿复测 | `kick=-0.90°`、最终角度约 `-1.28°` 时仍停在 `-52~-53 mm` |
| 抖振复测 | `±0.30°、8 Hz` 周期抖振只让机构持续振动，小球位置没有变化 |
| 当前处理 | 删除周期抖振，保留有方向的渐增脱困补偿；下一步先标定静态起滚角和检查机构卡滞 |
| 静态起滚复测 | 固定 `-2.00°` 时小球由约 `-53 mm` 滚到 `+85 mm`，步进 `Pos=Tgt`，证明执行器和导轨可以运动 |
| 定向补偿调整 | 正方向上限保持 `0.90°`，负方向先提高到 `1.20°`；起滚后由速度阈值立即撤销，避免直接采用危险的固定 `-2°` |
| `0 -> +50 mm` 复测 | 小球停在 `X=+6 mm`，负向补偿达到 `-1.20°`、最终角度 `-1.12°`，且步进 `Pos=Tgt`，说明该位置仍未达到起滚坡度 |
| 二次定向调整 | 保持 `0.5°/s` 增长速度，负方向仅在 `1.20°` 仍静止时继续到 `1.50°`；原本能起滚的过程不会用到新增余量 |
| 接近目标复测 | 小球停在 `X=+17 mm`，`kick=-1.50°` 已到顶，但速度包络随误差缩小后最终角度只有约 `-0.99°`，证明继续增加相加式 Kick 不能稳定保证坡度 |
| 起滚角下限 | 负方向静止达到 `400 ms` 后，保证相对水平至少倾斜 `2.6°`；球开始运动后立即释放 |
| 重新归零复测 | 机械水平后执行 `BALL,ZERO`、`trim=0`，目标 `+50 mm` 时稳定在约 `+52 mm`，速度衰减到 `0`，无持续振荡 |
| 一致性修正 | 当前默认 `trim` 改为 `0°`；静止进入速度门限由 `3` 放宽到 `6 mm/s`，避免摄像头毫米量化速度反复清空脱困计时 |

## 2026-07-31 第三问快速起滚与动态角度上限

| 项目 | 内容 |
| --- | --- |
| 目标 | `0 -> +50 mm -> -50 mm` 全流程不超过 `5 s`，减少等待静摩擦补偿的时间 |
| 起滚等待 | `200 ms -> 50 ms`，约等待两帧 40 FPS 有效数据后开始补偿 |
| 初始补偿 | 固定 `0.35°` 改为按误差直接给 `0.7~1.5°` |
| 增长速度 | `0.5°/s -> 2.0°/s`，仍静止时更快跨过起滚阈值 |
| 补偿上限 | 正向 `2.5°`、负向 `2.8°`，球速达到 `10 mm/s` 后立即释放 |
| 角度限制 | 固定 `±3°` 改为动态 `1.5~5°`，误差或球速越大允许角度越大 |
| 安全边界 | 最终硬限位 `±5°`；摄像头超过 `150 ms` 无有效帧仍立即退出闭环并回软件水平 |
| 诊断 | `BALL?` 新增 `Limit`；`BALLLOG` 在 `angle` 后新增 `limit` 字段 |
| 构建结果 | CCS 21 全量编译和链接通过，等待实机第三问计时验证 |
| 远端卡滞复测 | 强制最小驱动角会覆盖速度环的反向制动，造成往返晃动后仍可能卡住，因此已撤销 |
| 串级重构 | `15 mm` 外完全使用位置-速度串级，`6~15 mm` 平滑切回位置 PID；接近目标时由速度误差自然产生反向制动角 |
| 测速抗量化 | 测速窗口 `30 -> 75 ms`，加入 `1 mm` 静止带，速度低通 `0.30 -> 0.45`，断帧重置窗口 `200 -> 250 ms` |
| 串级首轮过冲 | 最大速度 `80 -> 60 mm/s`、位置速度比例 `1.5 -> 1.2`、硬角度 `5 -> 4°`；Kick 等待增至 `100 ms`，幅度和增长速度同步下调 |
| 中途停滞与二次过冲 | Kick 在球相对测速基准移动 `1.5 mm` 后立即撤销，球速退出阈值恢复为 `10 mm/s`；若仍未到目标又停住，则重新等待并再次起滚 |
| 第三问超时优化 | 比赛移动阶段独立使用 `75 mm/s、1.8/s` 快速包络；到 `-45 mm` 立即冻结计时并锁定捕获点，恢复保守包络，由 D 项一次反向制动后靠静摩擦停住，不使用持续震动 |
| 双端捕获与回程驱动力 | 改用 `+65/-65 mm` 虚拟驱动目标；到 `+45 mm` 锁定并制动 `60~160 ms` 后回程，到 `-45 mm` 最终捕获，避免回程在 `-2~-3 cm` 因目标速度下降而提前停住 |
| 左右不对称复测 | 正向仍过冲而负向仍到不了 `-4 cm`，说明不能共用一套强度；正程改为 `+60 mm / 60 mm/s / 1.4/s` 并在 `+40 mm` 提前制动，回程改为 `-100 mm / 85 mm/s / 2.2/s`，在 `-40 mm` 捕获 |
| 终点捕获复测 | 保持 `-40 mm` 会回到 `-3~-1 cm`，回水平滑停又会到正侧约 `+3 cm`；直接 `-50 mm` 捕获仍因 D 与测速延迟反弹到 `-1.6 cm`。现改为 `D=0.015、Set=-60 mm` 软制动，近零速后恢复原 PID 保持 `-50 mm`；反弹越过 `-40 mm` 自动强回拉，完成判定改为 `250 ms` 位移窗口。 |
| 过零测速制动重构 | 上述终点软制动仍开始过晚，现改为 `RawX>=+40 mm` 后固定 `+3.5°` 向左送球，在 O 点用本段峰值左向速度和 `v^2=2as` 计算 `-1.0~-4.0°` 制动角，从 O 点提前制动；到 `-40 mm`、近零速或 `700 ms` 后恢复原 PID 保持 `-50 mm`。 |
| 诊断与安全 | `MAP?` 增加峰值速度、手动倾角和计算制动角；固定倾角阶段摄像头超时 `150 ms` 会回到水平补偿角。CCS 21 全量编译和链接通过，等待实机验证制动模型增益。 |
| 实测日志结论 | O 点才下发制动时球速已约 `-132 mm/s`，步进换向滞后约 `220 ms`；程序又在 `RawX<=-40 mm`、球速约 `-153 mm/s` 时交给原 PID，导致角度正反饱和、最远冲到约 `-96 mm` 并反弹。 |
| 提前制动与软捕获 | 制动触发提前到 `+20 mm`，按峰值速度加 `40 mm/s` 余量、`70 mm` 制动距离计算 `-1.5~-3.0°`；取消 `-40 mm` 无条件接管，待左向速度降至 `30 mm/s` 以下后使用 `0.0075/0/0.010` 柔和 PID 捕获。M2/Q3 自动开启 `100 ms` BALLLOG。 |
| 提前制动实测 | 左端最远位置由约 `-96 mm` 降到 `-63 mm`，证明提前制动有效；但 `Kd=0.010` 在球以 `+29 mm/s` 穿过 `-50 mm` 时仅给约 `+0.29°`，球继续反弹到 `+35 mm`。捕获阶段保持 `Ki=0`，将 `Kd` 提高到 `0.030`，利用速度项在目标附近及时反拉。 |
| 捕获 D 增强实测 | `Kd=0.030` 把右向反弹峰值从约 `+35 mm` 压到 `0 mm`，但仍在 `X=-57.9 mm、V=-20.6 mm/s` 时接管，之后因反向动量过大而长期振荡在 `-1~-3 cm`。接管速度阈值由 `30 mm/s` 收紧到 `8 mm/s`，先由固定制动把球降至近零速，再让 PID 完成最后定位。 |
| 近零速接管复测 | 新门槛成功在 `X=-62.5 mm、V=-0.8 mm/s` 接管，但球仍因执行器换向滞后反弹到约 `+2 mm`，最终卡在 `-12 mm`；当时正向脱困已到 `1.6°`、总角约 `2.28°` 仍未起滚。制动触发由 `+20 mm` 提前到 `+30 mm`，正向脱困上限提高到 `2.4°`、爬升提高到 `1.8°/s`，移动 `1.5 mm` 立即撤销的保护保持不变。 |
| 5 秒全程复测 | 约 `1.08 s` 到 `+4 cm`，约 `2.79 s` 已在 `-5.6 cm` 附近反向，但速度低通滞后导致约 `2.99 s` 才启用 PID；PID 随后把球拉回正侧并持续振荡，错过 5 秒。正常终点改为两次原始位置反向：第一次在允许区回弹 `1 mm` 即固定 `+3.0°` 反拉，第二次在允许区回退 `1 mm` 即回水平，稳定 `250 ms` 冻结成绩；PID 仅作滑出允许区的兜底。 |
| 双制动首轮实测 | 程序在 `4.10 s`、`X=-47.4 mm` 报 PASS，但软件 `0°` 下球从短暂停顿继续向右滚到约 `+25 mm`；由零位阶段约 `+60 mm/s^2` 的右向加速度估算固定坡度约 `0.5°`。取消“区内静止 150 ms”替代第二次反向，完成后保持 `+0.55°` 抗右漂；验稳改为 `350 ms` 内全窗口摆幅 `<=2 mm` 且 `|V|<=8 mm/s`。 |
| 固定保持角复测 | `+0.55°` 只能让球短暂停在约 `-5.8 cm`，随后仍沿局部坡度向右滚；5 秒后切回通用 PID 又持续振荡在约 `-1~-3 cm`。说明整根管道的安装坡度、局部弯曲和静摩擦不能由一个固定角覆盖。 |
| 终点局部平衡自适应 | 删除固定 `+0.55°` 与通用 PID 兜底；第二次反向后改用终点专用 `P=0.060、I=0.030、D=0.050`。I 项只在 `|E|<=15 mm、|V|<=10 mm/s` 时学习当地平衡偏置，偏置限 `±1.2°`、总角限 `±2.5°`；完成后继续保持。BALLLOG 新增 `q3angle/q3bias`。 |
| 自适应首轮实测 | 第二次反向约在 `X=-25 mm、3.8 s` 已发生，但旧条件等到 `X=-40 mm、V=-43.5 mm/s` 才接管，导致 `q3angle` 长时间在 `±2.5°` 饱和并大幅振荡；最终停在约 `-33 mm` 时误差 `17 mm` 又超出 `15 mm` 积分门控，`q3bias` 卡在 `+0.29°`。改为第二次反向确认后立即接管，并将 I 调为 `0.050`、门控扩至 `25 mm`。 |
| 自适应二轮实测 | 最终可在约 `8.20 s`、`X=-41 mm` 稳定，说明局部平衡自适应有效；但最终制动从 `-1.5°` 切到 `+3.0°` 时积压 `780` 个 STEP 脉冲，`4000 Hz` 下约需 `195 ms`，球由 `-58 mm` 反弹到 `-18 mm`。STEP 提高到 `8000 Hz`，高电平仍保持约 `10 us`，先将两次换向执行延迟减半，再复测 5 秒全程。 |
| 8000 Hz 首轮复测 | 反向制动更早生效，最左位置只到 `-36 mm`；旧状态转换仍要求最左到过 `-40 mm` 且回弹时位于 `-60~-40 mm`，因此状态永久停在 `-1.5°`，球被推回到 `+101 mm`。制动触发由 `+30 mm` 延后到 `+15 mm`；首次反向改为最左到过 `-35 mm` 且回弹 `1 mm` 即进入终点反拉，删除会卡死的当前区间限制。 |
| 8000 Hz 二轮复测 | 三个阶段均正常切换，约 `3.50 s` 已在 `X=-41.5 mm` 进入终点保持；但偏置从 `0°` 学起，小球从约 `-47 mm` 重新滚到 `-26 mm`，随后 `q3angle=+2.5°`、`q3bias=+1.2°` 均到顶仍卡在 `-28 mm`。终点偏置改为从实测 `+1.0°` 起步，偏置上限提高到 `±2.0°`，总角上限提高到 `±3.5°`，用于提前保持和自动克服局部静摩擦。 |
| 8000 Hz 三轮复测 | 双制动和末端保持均成功，最终在 `6.70 s`、`X=-45 mm`、`V=-0.7 mm/s` 稳定，局部偏置收敛到 `+1.54°`。超时主要来自 `+3.0°` 终点反拉让球从约 `-95 mm` 滑到 `-38 mm` 才第二次反向，约 `4.18 s` 才进入保持。终点反拉提高到 `+3.5°`，保持初值改为实测 `+1.5°`；不缩短 `350 ms` 验稳窗口。 |
| 8000 Hz 四轮复测 | 约 `3.58 s` 已进入终点保持，说明双制动速度满足 5 秒要求；但 `D=0.050` 时小球在 `-35~-57 mm` 间连续往返，直到 `7.20 s` 才在 `X=-46.4 mm` 停稳。保持环 `D` 提高到 `0.080`，用于更早反刹双向速度；送球、两次固定制动和 `350 ms` 验稳条件保持不变。 |
| 8000 Hz 五轮复测 | `D=0.080` 使延迟速度反馈过强，终点角持续在 `±3.5°` 饱和，小球长期往返而不能停稳，因此否决该改动并恢复 `D=0.050`。新增低速锁定：首次在 `-60~-40 mm` 且 `|V|<=8 mm/s` 时冻结已学习偏置、停止 P/D，再开始 `350 ms` 验稳；失稳时自动解锁继续学习。BALLLOG 新增 `q3lock`。 |
| 8000 Hz 六轮复测 | 低速锁定最终成功，小球在 `8.20 s`、`X=-51.0 mm`、`V=0.5 mm/s` 停稳，局部偏置为 `+1.51°`；但第一段制动后 RawX 最远约 `-84 mm`，实车明显越过 `-7 cm`，随后经历多次往返才满足验稳。说明锁定保持方向正确，下一步应把重点移到提前制动和减少终点往返，而不是继续增大保持环 D。 |
| 六轮后优化配置 | 第一段制动触发由 `+15 mm` 提前到 `+25 mm`；终点 D 从 `0.050` 降到 `0.030`。新增速度方向滞后保护，并要求单帧位移 `<=1 mm` 才允许锁定，避免日志中三次“速度接近零但位置仍快速移动”的误锁。BALLLOG 新增 `q3dx`。 |
| 8000 Hz 七轮复测 | 提前制动有效，RawX 最左由约 `-84 mm` 收到 `-60 mm`，最终在 `7.60 s`、`X=-47.0 mm`、`V=0.5 mm/s` 停稳，偏置为 `+1.45°`。但约 `3.51 s` 切入终点保持后仍先到 `-67 mm`、再回到 `-36 mm`，经历一次完整往返才锁定；下一步可基于重复出现的 `+1.45°` 平衡角测试后段固定时序。 |
| 七轮后固定后段试验 | 最终 `+3.5°` 反拉至少 `300 ms` 后，若 RawX 在 `-45~-38 mm` 连续两帧变化 `<=1 mm`，立即固定 `+1.45°` 并验稳 `350 ms`；若单帧移动 `>1 mm`、滑出 `-60~-40 mm`，或没有捕获平台而先出现第二次反向，则回退原终点自适应控制。该配置等待实机验证。 |
| 固定后段首轮复测 | `RawX=-40 mm` 时聚合球速仍约 `+45 mm/s`，两帧小位移是 1 mm 坐标量化造成的假平台；固定分支立即失稳回退，并产生一次无效的角度往返。删除假平台判定，终点反拉由 `+3.5°` 提高到 `+4.0°`；仅在最右点后真实回退 `1 mm` 且已到 `-60~-38 mm` 时固定 `+1.60°`，500 ms 未稳则自适应兜底。自适应锁定的单帧门槛由 `1 mm` 收紧到 `0.5 mm`，避免日志中的三次误锁。 |
| 固定后段二轮复测 | 第二次反向约在 `3.39 s、X=-38.4 mm` 发生，球仍有明显动量，`+1.60°` 固定角下一帧即失稳，说明动态制动不能由静态平衡角代替。自适应最终在约 `X=-53 mm、bias=+1.39°` 附近停住，但 `0.5 mm/帧` 门槛小于摄像头 1 mm 量化后的滤波跳变，导致锁定反复开关。删除固定保持分支；明显移动时按 40 FPS 单帧速度以 75% 权重提前制动，停稳改为 `100 ms` 低动预确认加 `250 ms` 偏置验稳。BALLLOG 新增 `q3pre`。 |
| 自适应三阶段首轮复测 | 新逻辑最终在 `6.14 s、X=-49 mm、V=-0.2 mm/s` 完成，随后稳定保持在约 `-48 mm`，局部偏置为 `+1.66°`，说明终点保持已经可靠；超时来自 `3.39 s` 接管后仍由 `-43 mm` 冲到 `-65 mm` 的一次往返，以及一次 `Age=183 ms` 触发的误失联复位。终点 D 由 `0.030` 提高到 `0.045`；普通模式仍保留 `150 ms` 保护，第三问单独放宽到 `250 ms`。放弃高频震动保持。 |
| D=0.045 与 250 ms 复测 | 全程没有再误触发 `Stale`，证明第三问 `250 ms` 阈值有效；但约 `3.41 s` 进入自适应后仍发生两次往返，约 `7.3 s` 才锁定。日志还在 `q3dx=+0.81 mm/帧`、实际约 `32 mm/s` 时因聚合速度接近零而假锁定，并漂移约 `0.7 s`。终点 D 恢复为 `0.030`；第二次反向后新增一次 `-1.5°、220 ms` 换向制动；停稳候选改用融合即时速度，BALLLOG 新增 `q3vfb`。高频震动继续停用。 |
| 单次换向制动首轮复测 | 假锁定已消除，总时间由约 `7.3 s` 降到 `5.40 s`，最终稳定在 `X=-55 mm、Bias=+1.53°`；但 `-1.5°、220 ms` 使球从约 `-45 mm` 继续到 `-59 mm`，随后仍需一次温和回程。保留必要的 `+4°` 终点反拉，删除额外负角，改为 `+1.5°、220 ms` 局部平衡滑停，再由自适应收尾。 |
| 局部平衡滑停首轮复测 | 本轮左向计划速度升至 `124 mm/s`，提前制动仍被最小角夹在 `-1.5°`，最左达到约 `-83 mm`；末段目标角多次大幅换向，最终 `7.80 s、X=-57 mm` 才停稳。将速度平方制动模型增益由 `1.15` 校准到 `3.0`，使高速时角度可提高到约 `-2.7°`；末端改为 `+1.0°、120 ms`，自适应目标角增加 `0.5` 低通和 `0.45°/帧` 变化限制，等待实机复测。 |
| 高速制动与角度平滑复测 | 总时间降到 `6.10 s`，最左约 `-55 mm`、最终 `X=-48 mm`，证明速度平方制动有效；但等真实回弹后才下发 `+4°`，步进换向期间球又回到约 `-32 mm`，形成一次额外往返。改为 `RawX<=-50 mm` 且聚合左向速度衰减到 `80 mm/s` 以下时提前反拉，并将单帧速度启用阈值由 `0.75 mm` 降到 `0.5 mm`，等待实机复测。 |
| 位置与速度双门槛复测 | 本轮 `6.73 s` 完成；球到 `RawX=-60 mm` 时聚合速度仍为 `-113 mm/s`，直到 `RawX=-69 mm、V=-72.8 mm/s` 才满足双门槛并切换 `+4°`，因此出现“已经到 6 cm 仍保持负角”。删除终点速度门槛，改为当前 `RawX<=-50 mm` 立即反拉；球速只用于日志和后续自适应控制。 |
| 纯位置提前反拉复测 | 新门槛在 `RawX=-51 mm、V=-99.3 mm/s` 时立即切换 `+4°`，但此时球尚未完成第一次反向；`FINAL_BRAKE` 又把后续继续向左移动误当成第二次反向，过早进入 `+1°` 和自适应阶段。最左达到 `-78 mm`，最终 `7.01 s` 才稳定。删除纯位置提前切换，恢复两次真实反向的阶段顺序；负角制动改为按运行中的最新左向峰值动态增强到最多 `-3.0°`，第一次反向要求最左到过 `-40 mm` 且 RawX 回升 `1 mm`。 |
| 动态负角制动首轮复测 | 制动角按峰值成功增强到 `-3.0°`，第一次反向落在约 `-50 mm`，阶段顺序恢复正确；但终点自适应在约 `4.1 s、X=-56 mm` 首次进入低动区后，仍因 `100 ms` 预确认继续运行 P/D，被重新拉到约 `-48 mm`。约 `4.89 s` 锁定后又因 `250 ms` 窗口重置拖到 `5.83 s`。改为首次低动合格立即冻结 P/D，只保持学习偏置并单阶段验稳 `200 ms`。 |
| 直接锁定首轮复测 | P/D 冻结生效且最终能稳定，但锁定时仍有约 `12~16 mm/s` 向右残余速度；只保持 `+1.60°` 平衡偏置时，小球从约 `-56 mm` 缓慢滑到 `-42 mm`，物理停稳仍到 `5.45 s`。新增方向制动：首次低动后按末帧方向在偏置上叠加 `0.8°、160 ms`，随后回到偏置并验稳 `150 ms`，目标是在约 `4.7 s` 内真实停稳，而不是仅提前 PASS 输出。 |
| M1 第二问基础速度微调 | 从第三问完成版 `aac0754` 恢复后，仅将 M1/Q2 基础速度由 `115 RPM` 提高到 `120 RPM`；第三问滚球、巡线增益、弯道逻辑和停车条件不变，等待实车计时。 |
| M1 第二问取消转向限幅 | M1/Q2 不再限制 `±60 deg/s` 目标角速度和 `±40 RPM` 差速；其它模式仍保留原限幅，底层 PWM、低目标停轮和编码器保护不变。 |
| M1 第二问保持外轮速度 | 强纠偏后 `turn_rpm` 下降过快，而中心速度只能每周期恢复 `2 RPM`，会让右弯外轮左轮从 `120 RPM` 突然降到七八十。M1 改为外轮始终保持 `120 RPM`、只降低内轮，M3/M4/M5 保持原分配。 |
| M1 终点两路判定否决 | `21400 count + 2 路` 在最后半圆仍可能把普通巡线误判成横线并提前停车，因此删除宽松分支，恢复 `21000 count` 后至少 3 路黑线连续 3 帧。 |
| M1 终点 IMU 航向串级 | 为改善最后半圆出弯后无法正对 A 点横线，记录起跑 yaw；`21000 count` 后按 `2.0 (deg/s)/deg` 生成最大 `±40 deg/s` 航向修正，叠加灰度目标角速度，再由 BNO085 角速度环和轮速 PI 执行。短暂全白时仅末段允许航向环继续对正。 |
| Q4 包络应用到 Q3 终点 | 仅在第三问进入末端自适应后启用 `20 mm/s、0.75/s` 的位置-速度包络；误差 `6~15 mm` 线性切换，保留原来的局部偏置积分、单帧速度融合、角度低通和停稳锁定。正程、固定送球及两次制动不变，避免牺牲 5 秒任务的前段速度。BALLLOG 新增 `q3vref/q3blend`。 |
| Q3 包络首轮日志修复 | 两份附件内容相同；小球在 `RawX=-36 mm` 已反向，但 `-40 mm` 门槛未满足，状态永久卡在 `-3.0°`，随后滚到右端并失去视觉，因此新包络完全没有执行。门槛恢复为 `-35 mm`；另加从最左点回升 `8 mm` 的位置逃生条件，确保提前反向时也会释放负角。最终完成仍必须在 `-60~-40 mm` 验稳。 |
| Q3 终点速度包络首轮成功 | 本轮正常完成两次真实反向并进入终点自适应；`q3vref` 从 `-20.0` 逐步降到约 `-6.8 mm/s`，`q3blend` 从 `1.00` 降到 `0.34`，融合速度下降后触发方向制动和验稳。最终 `4.71 s` PASS，`X=-40.1 mm、V=-0.7 mm/s、Bias=+1.64°`，随后至少约 `1.4 s` 稳定在 `-40.0 mm`。当前参数保持不变；时间余量约 `0.29 s`，仍需多轮确认重复性。 |
| Q3 三轮重复性复查 | 第一轮最左仅约 `-24 mm`，旧逻辑等待回升 `8 mm` 才释放负制动，切换时已回到约 `-10 mm`，后段又在 `X=+14 mm、V=0` 处以约 `+2.2°` 卡住；第二轮能稳定在约 `-53 mm`，但 `5.01 s` 才完成；第三轮摆杆命令已到约 `-3.5°` 而球始终停在 `1~4 mm`，判为机构/局部静摩擦异常。软件将提前反向恢复改为到过 `-20 mm` 后回升 `1 mm` 即释放，终点速度包络在远端低速卡住时临时补回受限位置项，验稳由 `150 ms` 缩短到 `120 ms`；BALLLOG 新增 `q3push`。 |
| Q3 终点回收提速 | 本轮约 `3.7 s` 已进入终点闭环，但从 `X≈-7 mm` 到首次低动用了约 `2.2 s`，最终 `6.24 s` 才稳定在 `-48.1 mm`；主要瓶颈是远端包络仅 `20 mm/s`，且 `+1.6°` 初始偏置低于本轮最终学到的 `+2.0°`，小球在 `-34 mm` 附近提前反向并重新起滚。Q3 专用终点包络提高到 `35 mm/s / 1.2/s`，初始偏置折中为 `+1.8°`；近端 P/D、`±3.5°` 限位、方向制动和验稳条件不变。 |
| Q3 静摩擦角度脱困 | 新三轮中两轮正程分别停在约 `+30 mm`、`+21 mm`，另一轮终点停在约 `-25 mm`；速度均接近零，普通动态角或 Q3 终点角已饱和，说明瓶颈是管道不同位置的起滚角而非 `35 mm/s` 包络。通用控制仅在 `breakaway_active` 时把动态限位临时抬到既有 `4.0°` 硬上限；Q3 终点仅在 `q3push` 非零时允许 `4.5°`，检测到位移后立即恢复 `3.5°`。正常滑行、折返和停稳参数不变。 |
| Q3 脱困三轮复测 | 一轮在 `4.95 s、X=-49.1 mm、V=0.2 mm/s` PASS，证明折返、终点包络和停稳锁定可用；一轮完整折返后停在 `X≈-61 mm`，因旧 `15 mm` 门槛没有终点静摩擦补偿；另一轮从中心卡住，`limit=4.0°` 但实际 `angle≈-3.6°`，说明限位已放开而负向 kick 幅值仍不足。Q3 终点静摩擦门槛降至 `8 mm`，通用负向 kick 上限由 `1.8°` 提到 `2.4°`，使确认静止时能够真正用满 `-4.0°`；运动阶段参数不变。 |
| Q3 正程三轮卡滞复查 | 两轮在约 `+15~+20 mm` 前反复起滚又停住，未到 `+40 mm`；另一轮从首条日志到 `+40 mm` 约用 `9.4 s`，并累计出现 `28` 个 `100 ms` 的 `angle<=-3.9°、|V|<=6 mm/s` 样本。日志同时显示起滚后速度包络角会降到约 `-0.7~-1.3°`，不足以跨过局部摩擦。Q3 正程临时把速度包络 `Kd` 从用户值提高到 `0.050`；若闭环已到 `-3.9°` 且球速 `<=6 mm/s`，短暂固定 `-4.5°`，确认向右移动 `3 mm` 后恢复闭环。通用控制、Q4 和用户保存 PID 不变。 |
| Q3 正程脱困后三轮复测 | 三轮均可靠到达 `+40 mm`，证明正程临时 `Kd` 与 `-4.5°/3 mm` 辅助有效；但折返开始时仍有约 `57~100 mm/s` 左向速度，`+25 mm` 才制动使最左达到约 `-74~-100 mm`，仅一轮在 `5.23 s` 稳定。另发现远端速度包络仍叠加 `+1.8°` 局部平衡偏置，球越过 `-50 mm` 后可能压过右向回收命令。制动提前到 `+35 mm`；远端包络取消固定偏置，只在误差进入 `15 mm` 内随混合系数逐步恢复局部平衡偏置。 |
| Q3 提前制动后三轮复测 | 一轮在 `4.45 s、X=-51.9 mm、V=-1.8 mm/s` PASS，证明 `+35 mm` 制动和远端取消偏置可以完成任务；另两轮正程辅助分别重复 `2`、`5` 次，到 `+40 mm` 已约 `9.1 s`、`10.9 s`。每次旧辅助在速度仅约 `5~12 mm/s` 时移动 `3 mm` 就撤坡，随后再次卡住。释放条件增加右向速度 `>=18 mm/s`。失败轮进入终点闭环时还出现球在目标左侧继续左移、命令角却从旧 `+1°` 缓慢换向并冲到约 `-105 mm`；新增仅首帧生效的远离目标快速制动种子，后续仍使用原低通和 `0.45°/帧` 限制。 |
| Q3 动量释放与折返点复测 | 两轮正程辅助均只触发一次，分别在移动 `5.5 mm、V=19.2 mm/s` 和 `8.9 mm、V=31.8 mm/s` 后释放，约 `0.8~1.0 s` 到达 `+40 mm`，证明正程卡滞已解决。旧固定 `+35 mm` 制动实际到 `X=31/28 mm` 才换向，第一次左冲仍到约 `-65/-95 mm`。现改为固定 `+3.5°` 至少 `120 ms`，记录右端峰值并在 RawX 真实回落 `2 mm` 时立即制动；`+35 mm` 仅作异常兜底。 |
| Q3 峰值折返后终点复测 | 新峰值触发准确落在 `Peak-X=2~3 mm`，但进入终点闭环时两轮融合速度仍约 `-62 mm/s`，其中一轮 RawX 最左达到约 `-108 mm`。另一轮在 `X≈-52.6 mm` 因单帧量化短暂误判低动，旧逻辑把手动角从约 `+2.11°` 突然切到 `+0.71°` 并执行 `160 ms` 捕获，随后小球继续向左。现将一次性强制动提前到距目标 `15 mm` 且接近速度 `>=30 mm/s`；停稳改为连续低动 `60 ms` 后冻结当前实际角度，删除固定方向推力，再验稳 `120 ms`。 |
| Q3 冻结后再滑与正程回滚复测 | 一轮在 `X=-44.2 mm、V=-3.4 mm/s` 经过仅 `120 ms` 验稳后报 LATE，冻结的 `+2.00°` 随后使球继续向负端滚到约 `-113 mm`；这是速度经过零点形成的短暂停顿，不是真正静止。冻结验稳恢复为 `350 ms`，期间球速重新超过 `8 mm/s`、单帧位移超过 `1 mm` 或窗口摆幅超过 `2 mm` 均立即解锁，最终还要求 `|V|<=4 mm/s`。另一轮正程到约 `+32 mm` 后已经回滚，却退回中心才重新触发脱困；现增加未到 `+40 mm` 且速度 `<=-2 mm/s` 时立即启用现有 `-4.5°` 辅助。 |
| Q3 远端卡滞与正端动量复测 | 两轮均未再误判冻结，但终点分别停在约 `-10 mm` 和 `0 mm`；`q3push=+2.40°`、总角约 `+3.45°`、步进 `lag=0`，说明执行器已到位但破静摩擦角不足。终点卡滞改为按目标方向短暂请求完整 `±4.5°`，一旦出现位移立即恢复 `±3.5°`。正程辅助释放时速度已达 `20.3/38.8 mm/s`，右端峰值扩大到 `+77/+106 mm`；释放门槛改为 `1 mm、4 mm/s`，只负责起滚，若再次停住或回滚再重新介入。终点一次性高速制动待命窗口由 `600 ms` 延长到 `5 s`，覆盖远端卡滞后的迟发起滚。 |
| Q5/Q6 自动滚球基线 | M4 起跑强制 `0 mm`，M5 由 B21 采集当前球位；两者起跑前检查目标 `±10 mm`，自动开启步进跟踪，采用 `20 mm/s、0.75/s` 行驶包络和速度耦合位置保护。持续丢帧 `300 ms` 不停底盘，只回标定水平；A 点后以 `15 mm/s、0.5/s` 继续保持。完成时记录 `30 s` 和最大误差 `10 mm`，输出 `PASS/LATE/OVER`。长 CSV 默认关闭，避免 115200 串口阻塞巡线。 |
| Q5/Q6 入弯与出弯过渡 | 针对“入弯触发偏晚、出弯硬切后摇晃”，增加右三探头近弯连续 2 帧提前触发；`170~175°` 渐减最低右转量，退出后按 `50 ms + 200 ms` 平滑恢复灰度，最长 `400 ms`。`MAP?` 新增 `Mix`，本版本待实车复测。 |
| Q5/Q6 精简蓝牙回传 | 保持完整 `BALLLOG` 默认关闭，新增每 `250 ms` 一条 `Q5BALL/Q6BALL`，回传时间、位置、目标、误差、球速、摆杆角、最大误差和摄像头状态。手动开启完整日志时自动暂停精简回传，减少串口对 10 ms 巡线的影响。 |
| Q3 题意复核与假反向修正 | 本轮正端峰值 `+54 mm`、终点 `-53 mm` 均满足 `±10 mm`，但负角制动让球只到 `-3 mm` 就反向，旧 `8 mm` 逃生条件随后误进终点反拉，导致球回到 `+25 mm`，最终 `6.51 s` 才停稳。峰值回落门槛由 `2 mm` 延后到 `12 mm`；只有最左到过 `-35 mm` 且回升 `1 mm` 才进入终点反拉，提前反向回升 `3 mm` 时改为重新向左送球。 |
| Q3 单制动直接捕获 | 最新日志在右端峰值 `+56 mm` 后回落 `12 mm` 开始制动，第一次只到 `-26 mm`；补送又在 `-3 mm` 提前制动，`4.92 s` 才进入终点闭环，记录结束时约 `12.6 s` 仍在 `-26 mm`。首轮制动改为峰值回落 `30 mm`、`+25 mm` 兜底；最左到过 `-40 mm` 并回升 `1 mm` 后直接进入带速度反刹的终点自适应，删除主路径中的第二次固定反拉。提前反向补送必须到 `-20 mm` 且左向速度达到 `15 mm/s` 后才重新制动。CCS 21 全量编译通过，等待实车复测。 |
| Q3 终点收敛提速 | 本轮约 `0.9 s` 到 `+40 mm`、约 `2.5 s` 已越过 `-50 mm`，但终点首次反刹仍受 `3.5°` 上限，随后在 `-34 mm` 静摩擦区按 `0.45°/帧` 爬到 `4.3°` 才起滚，最终 `10.11 s` 完成。高速远离目标时改用 `4.5°` 动态反刹；`q3push` 激活时直接下发破静摩擦目标角，机械速度仍由 STEP 频率限制。`350 ms` 验稳条件不变，等待实机复测。 |
| Q3 终点误制动修正 | 本轮进入终点闭环时球从约 `-74 mm` 向 `-50 mm` 回升，旧逻辑在尚未越过目标时按滞后负速度直接种入 `-4.5°`，该角在球反向后仍继续把球推到约 `+119 mm`。现进入闭环先撤销上一阶段固定角，并删除“高速接近目标”强制种子；仅在已经越过目标且仍以至少 `15 mm/s` 远离时直接反刹，前段往返和停稳门槛不变。 |
| Q4 起停前馈撤销门槛修正 | 最新日志 `7.64 s` 通过 B 点但全程最大误差约 `21 mm`。起步时小球仍在 `X≈-6 mm`，短窗速度尖峰已超过 `10 mm/s`，旧逻辑提前撤掉负前馈，随后再次后滑到约 `-21 mm`；现要求先回到 `X>=-2 mm` 才允许按速度退出。终点触发时球约在 `-5 mm`，旧 `-2 mm` 位置门槛直接清零停车正前馈，停车后冲到约 `+22 mm`；现仅在 `X<-8 mm` 时直接禁用，Q4 的 `88 RPM`、`1400 ms` 起步和 PID 参数保持不变。 |
| Q3 新日志终点迟刹与假停稳修正 | 本轮约 `0.9 s` 到 `+40 mm`、约 `2.4 s` 已到负端，但从 `-61 mm` 以约 `+59 mm/s` 回到目标时仍受 `0.45°/帧` 斜率限制，穿过 `-50 mm` 后才给 `+4.5°`，随后连续大摆并到 `8.93 s` 才报 LATE。恢复距目标 `15 mm`、接近速度 `30 mm/s` 的提前反刹，但新增单帧位移和融合速度同向校验，避免旧速度误反坡。日志还显示冻结 `+1.65°` 后报完成，球又从 `-43.5 mm` 滑到至少 `-66 mm`；验稳延长到 `600 ms`，完成后再滑会自动解除冻结并恢复自适应保持。 |
| Q3 38 秒终点振荡修正 | 新日志约 `2.8 s` 已进入终点控制，但小球仍在 `-36→-35→-34→-32 mm` 连续移动时，单帧量化恰好出现零位移，旧 `q3push` 将其误判为静摩擦并再次给满 `4.5°`，随后振幅扩大到约 `-84~+1 mm`，最终约 `38 s` 才停。破静摩擦改为累计静止 `150 ms` 且总位移不超过 `1 mm` 后才触发，强角最多 `100 ms`，动作后冷却 `250 ms`；终点高速接近制动窗口由 `15 mm` 提前到 `25 mm`，低动预确认延长到 `100 ms` 并同时检查融合速度与聚合速度。前段往返和 `600 ms` 最终验稳不变，等待实机复测。 |
| Q4 起步与停车二次过冲修正 | 最新日志 `7.63 s` 到达 B 点，但起步最低约 `-23.4 mm`；停车完成时约 `-3.5 mm`，程序重新施加 `+0.8°` 接球角后又从 `+5.3 mm` 冲到约 `-20.9 mm`。起步预置角改为 `-0.85° / 180 ms / 600 ms`，让步进在底盘起动前更早到位；停车后仅在球仍位于正侧且继续正向滚动时保留接球角。停车保持新增超出 `±10 mm` 且球速不高于 `6 mm/s` 才启用的温和回中保护，增益 `0.10°/mm`、最大 `1.0°`。Q4 的 `88 RPM`、停车距离和 PID 不变，等待实车复测。 |
| Q5/Q6 按键目标与启停补偿 | Q5/Q6 复用 Q4 的起步预置思路：底盘静止 `200 ms`，以 `180 ms` 建立 `-0.85°`，再从 `30 RPM` 用 `1400 ms` S 曲线升至 `75 RPM`，起步前馈峰值 `-1.30°`。A 点横线确认后捕获左右轮 PWM，以 `500 ms` S 曲线降到 0，并叠加峰值 `+0.80°` 的钟形制动前馈。M5/Q6 短按 B21 时自动把最新摄像头位置锁为目标并立即起跑，比赛不依赖蓝牙；`Q6,TARGET` 仅保留调试。CCS 21 全量编译通过，等待实车复测。 |
| Q5 首圈超时与越界修正 | 实测 `32.47 s` 完成，最大误差 `16 mm`；起步约 `1.26 s` 时最低 `-15 mm`，中后段还出现 `-13.6/-12.8 mm`，摄像头仅一次约 `232 ms` 短失联并自动恢复。Q5/Q6 稳态基础速度提高到 `85 RPM`，外轮上限配套为 `95 RPM`；起步预置/峰值前馈加强到 `-1.05°/-1.55°`。同时将 Q4 的 `35~140 ms` 短窗估速和换向速度阻尼复用于 Q5/Q6，提前收力以减小回中越界；转向参考改为 `80 RPM`，避免提速后灰度修正同比放大。 |
| Q3 10.83 秒复测修正 | 本轮约 `0.8 s` 到达正端，但最高到 `+65 mm`；第一次负向制动在右端峰值 `+65 mm` 回落到约 `+34 mm` 时启动，随后于 `-36 mm` 提前反向，触发补送后最低又到 `-68 mm`，多余往返使总时间达到 `10.83 s`。正端切换后的固定反拉由 `+3.5°` 提高到 `+4.5°`；首轮制动改为峰值回落 `40 mm` 或 RawX 到 `+15 mm` 才触发，目标是正端不超过 `+60 mm` 且第一次直接落入 `-60~-40 mm`。`600 ms` 最终验稳保持不变。 |
| Q5 29.33 秒起步越界与完成后漂移 | 本轮圈速 `29.33 s`，但起步 `1.50 s` 已到 `-29.6 mm`，说明 `-1.05°` 预置与 `-1.55°` 起步前馈被共用的 `1.5°` 合成限幅截断；运行末报文为 `X=-2.9 mm`，随后实车漂到约 `-20 mm`，说明 Q5 完成后没有启用停车位置保护。现仅在 Q5/Q6 起步阶段将合成前馈限幅放宽到 `2.2°`，巡航保持 `1.5°`；完成后复用 `±10 mm` 停车保护，并延续 `5 s` 精简遥测，等待实机复测。 |
| Q3 15.85 秒负端捕获失效修正 | 本轮约 `0.8 s` 到正端、`2.5 s` 已到 `-81 mm`，但旧逻辑等 RawX 回升后才从 `-3°` 换到 `+4.5°`，步进换向完成时球已回到约 `-55 mm` 并最终冲至 `-20 mm`；此后静摩擦 Kick 和速度包络反复拉扯，直到 `15.85 s` 才在 `-41 mm` 锁定。现于 `X<=-60 mm` 且左向速度降到 `130 mm/s` 以下时提前请求 `+4°`，明确区分第一次回升和第二次折返；终点自适应直接从实测 `+1.8°` 偏置接管，不再先降到 0°。 |
| Q5 直线摆动与提前停车修正 | 用户反馈 Q5 直线左右摆动且会提前停车；本次附件实际为 Q3 日志，未包含 Q5BALL，因此仅修正代码中可确认的两处风险。M4/M5 中心误差缩放由 `0.5` 降到 `0.25`，外侧与弯道增益不变；终点解锁由 `21000` 延后到 `21300 count`，并要求第二个半圆已经退出后才接受至少 3 路黑线，避免 D-A 弯道宽线被误判为 A 点横线。 |
| Q3 7.64 秒假回弹交接修正 | 新日志约 `2.18 s` 在 `X=-60 mm、V=-119.5 mm/s` 启用 `+4°` 捕获，负端首次冲程已收在约 `-66 mm`；但 RawX 的 `-66→-65→-64→-65 mm` 量化抖动被旧 `1 mm` 双折返条件误判，球速仍为 `-11.4 mm/s` 时便降到 `+1°`，随后又滑到约 `-80 mm` 并形成一次完整往返。现取消该位置单条件交接；允许区低速可直接接管，否则必须从真实最左点回升 `2 mm` 且球速已为右向 `>=+5 mm/s`，再直接进入 `+1.8°` 起步的终点自适应。 |
| Q5/Q6 编码器与 IMU 写死停车 | 最新 Q5 精简日志持续到 `36.38 s` 仍没有终点事件，确认横线停车未触发。按实车要求，Q5/Q6 改为平均编码器达到 `27370 count`（理论一圈 `21895` 的约 `1.25` 倍）且 BNO085 累计净顺时针转角达到 `360°` 后触发现有 `500 ms` S 曲线缓停；M1/Q2 的 3 路横线停车保持不变。精简遥测新增 `d_count/turn_deg`。 |
| Q3 高速冲出视野修正 | 本轮约 `0.9 s` 到 `+40 mm`，但固定 `+4.5°` 一直保持到右端峰值从 `+50 mm` 回落到 `+10 mm`；制动换向完成前左向速度超过 `140 mm/s`。程序又在 `X=-89 mm、V≈-121 mm/s` 时切到 `+4°`，小球继续冲至 `-115 mm` 并丢失视觉。制动改为峰值回落 `20 mm` 或 `RawX<=+30 mm` 即下发；删除仍高速向左时的 `+4°` 捕获，负制动保持到真实反向。Q3 制动阶段短时失联不再清零制动角。 |
| Q5 两圈不停车修正 | 实测编码器在约 `35.8 s` 已超过 `27370 count`，但精简日志中的累计转角始终为 `0.0°`，证明停车被 IMU 符号假设卡住。Q5/Q6 和右弯保持现改为累计相邻 yaw 样本的绝对转角，正常仍要求 `27370 count + 360°`；另加 `30000 count` 强制停车兜底，避免 IMU 失效时无限绕圈。 |
| Q4 越过 B 点后慢停 | 第四题只考核 A-B 段，正常缓停由 `5350` 后移到 `5550 count`，即越过 B 点约 `5.6 cm` 后触发；兜底由 `5600` 后移到 `5800 count`。最终 PWM S 曲线由 `500 ms` 拉长到 `900 ms`，距离减速/最终制动前馈峰值由 `+1.00/+0.80°` 降为 `+0.70/+0.45°`，减小停车冲击。 |
| Q3 5.04 秒与负端过冲修正 | 本轮正端峰值 `+49 mm` 合格，但固定反拉到右端峰值回落 `22 mm`、`X=+27 mm` 才发出负制动命令，步进尚有约 `600 pulse` 换向滞后，最终冲到 `-75 mm`；小球随后在 `-57 mm` 已稳定，却因 `600 ms` 验稳到 `5.04 s` 才完成。现将制动提前为峰值回落 `12 mm` 或 `X<=+35 mm`，最大制动角仍为 `-3°`；冻结验稳缩短到 `450 ms`，预计减少过冲并把完成时间压回 5 秒内。 |
| Q4 停车距离二次后移 | 实车反馈上一版仍走得略少；保持 `900 ms` 缓停和现有滚球前馈不变，仅把正常/兜底触发由 `5550/5800` 后移到 `5700/5950 count`，即比上一版再增加约 `4.2 cm`，正常在越过 B 点约 `9.8 cm` 后开始最终缓停。 |
| Q5/Q6 停车距离缩短 0.5 m | 最新 Q5 在 `D=27372` 触发缓停，最终停在 `D=27585`，实车反馈行驶距离偏长。按轮径 `65 mm`、编码器 `728 count/圈` 计算，`0.5 m≈1783 count`；正常停车阈值由 `27370` 改为 `25590`，IMU 异常兜底由 `30000` 同步改为 `28220`。累计转角 `360°` 与 `500 ms` S 曲线缓停保持不变。 |
| Q3 5.51 秒终点回摆修正 | 本轮约 `0.8 s` 到正端、约 `2.3 s` 已进入负端自适应，但小球从 `-43 mm` 回摆到 `-19 mm` 后才再次返回，最终 `5.51 s` 在 `-42.4 mm` 完成。检查发现终点高速逃离反刹逻辑存在但接管标志始终初始化为 `0`，因此从未触发；现进入终点自适应时将一次性反刹置为待命，并把冻结验稳由 `450 ms` 缩短为 `250 ms`，目标是在保持 `±10 mm` 合格区的同时压回 5 秒内。 |
| Q5/Q6 IMU 无数据阻塞新终点修正 | 新日志中 Q5/Q6 的 `turn_deg` 全程为 `0.0°`，两次均未在 `25590 count` 正常停车，而是在 `D=28222/28251` 触发强制兜底，导致缩短 0.5 m 的目标未真正生效。保留 IMU 正常时的 `360°` 交叉确认；若姿态数据无效、不新鲜或跑到终点累计转角仍低于 `30°`，则允许 `25590 count` 单独触发，`28220` 仍作为最终安全兜底。 |
| Q3 强逃离反刹回退与阻尼修正 | 新日志确认 `Terminal escape brake seeded` 直接下发接近 `+4.5°` 后，小球从 `-50 mm` 形成约 `-36~-90 mm` 的持续大振荡，运行超过 10 秒仍无法完成。撤销终点接管时的一次性强反刹，恢复从 `+1.8°` 偏置平滑接管；按位置环 `Kp=0.060` 和摆杆角到小球加速度近似关系估算，原 `Kd=0.030` 偏欠阻尼，现提高到 `0.040`，加强随速度反向制动。`250 ms` 冻结验稳保留。 |
| Q3 正程固定角与折返超前制动 | 最新失败日志中正程在约 `+29 mm` 自行反向并重复触发静摩擦辅助，到达 `+40 mm` 已耗时约 `2.4 s`；右端峰值约 `+45 mm`，回落 `12 mm` 才制动时步进目标与实际位置仍差约 `546 pulse`，随后左向速度达到约 `196 mm/s` 并冲到约 `-111 mm`。正程改为固定 `-4.5°` 直至 `RawX>=+40 mm`；折返仍固定 `+4.5°`，但峰值回落门槛提前到 `3 mm`，`+35 mm` 兜底和 `-1.5~-3.0°` 动态制动保持不变。 |
| 2026-08-01 Q3 写死往返与速度能量制动 | 按最新要求删除主路径中的峰值回落、时间兜底和失败补送：固定 `-4.5°` 到 `+40 mm`，固定 `+2.5°` 到 `-40 mm`。到负端后按相邻帧融合速度、固定 `15 mm` 制动距离和速度平方计算 `±4.5°` 能量吸收角；角度围绕 `+1.8°` 局部坡度初值随速度方向切换。连续低速 `100 ms` 或真实回弹后，从当前制动角的 `±2°` 范围交给终点积分学习，兼容管道不水平、局部弯曲、静摩擦差异和中心奇异点。CCS 21 全量编译、链接通过，等待实机日志验证。 |
| 2026-08-01 Q3 步进换坡提前量 | 首轮写死测试在 `+40 mm` 下发返程后仍冲到 `+111 mm`；在 `-41 mm、V=-236 mm/s` 下发 `-4.5°` 制动时，步进目标与当前位置相差 `1211 pulse`，约需 `150 ms`，到位前球已到 `-85~-111 mm` 并丢失视觉。确认瓶颈是执行器换坡延迟而非终点 PID。正端改为 `RawX>=+10 mm` 提前下发 `+2.5°`，负端改为 `RawX<=-5 mm` 提前下发速度能量制动；目标分别是在实际 `+40~+60 mm` 达到返程效果、在 `-40 mm` 附近达到完整反刹。 |
| 2026-08-01 Q3 二次换坡提前量复测 | `+10 mm` 返程后实际正峰值约 `+66 mm`；`-8 mm、V=-169 mm/s` 才下发负制动时仍冲到约 `-77 mm`，随后终点闭环往返，`6.55 s` 才在 `-42 mm` 判稳。正端改为确认向右起滚后于 `+1 mm` 下发返程；负制动改为返程速度达到 `-70 mm/s` 且位置回到 `+40 mm` 内即下发，使约 `150 ms` 换坡过程在正侧完成。完成后的冻结角不再因单帧速度尖峰解锁，仅在位置离开 `-60~-40 mm` 合格区时恢复自适应。 |
| 2026-08-01 Q3 第三轮提前量复测 | `+1 mm` 触发后实际正峰值仅约 `+18 mm`，未到 `+5±1 cm`；负制动在 `X=+14 mm、V=-74 mm/s` 触发后，第一次负端最低收至约 `-61 mm`，说明正侧速度制动有效。主要超时来自球已在 `-60 mm` 附近低速时仍进入静摩擦补偿，被 `-4.5°` 再次推出后形成往返。正端恢复到 `+10 mm` 触发但返程坡度加强为 `+3.0°`；低速捕获放宽为 `12 mm/s、75 ms`，若已在 `-60~-40 mm` 直接冻结制动角验稳，跳过终点 Kick。 |
| 2026-08-01 Q3 负端假回弹门槛 | 本轮正端峰值约 `+54 mm`，已经满足 `+5±1 cm`。负端在 `X=+38 mm、V=-191.8 mm/s` 进入能量制动，但 RawX 仅到约 `-19 mm` 时，一帧 `-19→-18 mm` 被即时速度误判为回弹，动态制动角提前翻到正角，随后在约 `-18 mm` 低速进入终点控制并形成长时间振荡。现规定 `RawX>-40 mm` 时能量制动角最多回到 `0°`，不得翻成正角；若此前连续低速或出现回弹，则恢复固定 `+3.0°` 向负端送球并重新捕获。只有进入 `-60~-40 mm` 后才允许终点自适应或直接冻结。 |
| 2026-08-01 Q3 首次回弹提前交接修正 | 新版补送正常触发，第二次能量制动把球送到约 `-51 mm`；但此时聚合球速仍约 `-33 mm/s`，单帧 RawX 从 `-51` 回到 `-50 mm` 就触发终点自适应。终点环随后在 `-77~-17 mm` 间持续大摆，超过 `5 s` 仍未停稳。现删除“回升 1 mm 即交接”分支：首次回弹继续由速度能量制动吸收，只有即时速度和聚合速度同时 `|V|<=12 mm/s` 并持续 `75 ms` 才允许进入终点状态；若低速点仍在 `-40 mm` 前则继续固定 `+3.0°` 补送。 |
| 2026-08-01 Q3 动态制动下令点 | 双速度门槛已生效，但第一轮仍在 `X≈+35 mm、V≈-195 mm/s` 制动，只到 `-20 mm` 就回弹；补送后又在 `+27/+14 mm` 过早制动并重复，约 `9 s` 后才越过负端。固定 `+40 mm` 门槛改为 `Xcmd=-50+15+|V|*0.15 mm`，并限制在 `-25~0 mm`，同时补偿约 `150 ms` 换坡距离和 `15 mm` 模型制动距离。RawX 未到 `-40 mm` 时，只有即时与聚合速度都达到 `+5 mm/s` 才允许正角吸收真实回弹，单帧假回弹仍保持非正角。 |
| 2026-08-01 Q3 历史柔和制动恢复 | 动态门槛实测在 `X=-15 mm、V=-169 mm/s` 才触发，步进仍有约 `820 pulse` 换向量，小球继续冲到约 `-88 mm`，随后在 `-85~-14 mm` 间大摆并超过 `5 s`。选择性恢复历史上曾于 `4.45 s、X=-51.9 mm` 完成的制动段：`RawX<=+35 mm、V<=-20 mm/s` 提前触发，按 `|V|+40 mm/s` 和 `70 mm` 距离计算 `-1.5~-3.0°`；左移时只允许增强负角，保留当前双速度真实回弹确认和终点保持。 |
| 2026-08-01 Q3 负端提前预捕获 | 新日志中负角已把球送到 `RawX=-44 mm` 合格区，但程序等即时与聚合速度都转正后才切正角；此时目标脉冲从约 `-519` 跳到 `+448`，机械换向约需 `100 ms`，小球已回弹到 `-30 mm` 并继续接近中心。现于 `RawX<=-40 mm` 且即时速度进入 `-90~0 mm/s` 时提前预置 `+1.8°` 局部平衡角；预捕获后禁止因负速度帧切回负角，真实回弹只允许继续增强正向制动。 |
| 2026-08-01 Q3 正区反复补送修正 | 本轮启动位置已为 `+15 mm`，几乎立即触发返程；第一次仅在 `X=+20 mm、V=-21.2 mm/s` 就进入负制动，球最远只到约 `-9 mm`，随后反复出现 `Catch short of -40`，因此新加的负端预捕获从未触发。后续多轮 `-22~-72 mm/s` 的过早制动同样停在正区。负制动最低左移速度由 `-20` 收紧到 `-100 mm/s`，固定 `+3°` 先建立足够返程动量，再进入柔和制动和 `-40 mm` 预捕获。 |
| 2026-08-01 Q3 预捕获速度滞后修正 | 最新一轮第一次负制动已到 `RawX=-36 mm`，但因未越过 `-40 mm` 又完整回到正区；第二次越过门槛后，瞬时速度条件直到 `RawX=-62 mm` 才成立，步进换向后仍冲到约 `-93 mm`。负端预捕获提前为 `RawX<=-35 mm` 且仍向左即下发 `+1.8°`，删除 `-90 mm/s` 速度门槛，使第一趟即可覆盖约 `100 ms` 换坡延迟。 |
| 2026-08-01 Q3 纯位置预捕获否决 | 纯位置版本在 `RawX=-41 mm` 已预置 `+1.8°`，但当时即时速度约 `-180 mm/s`、融合速度约 `-122 mm/s`，局部平衡角无法消耗高速动量，小球持续左移并冲到约 `-119 mm`，随后终点环大幅往返。保留 `RawX<=-35 mm` 前置条件，但增加融合 `|V|<=45 mm/s` 动量门槛；高速阶段继续保持 `-3°` 反刹，避免受单帧测速跳变影响。 |
| 2026-08-01 Q3 上抬波回零 | 新动量门槛在 `RawX=-40 mm、融合 V=-41.4 mm/s` 正确触发，原 `-3°` 已把负向运动压住；但程序确认回弹后把正角持续增强并保持在约 `+2.85°`，小球短暂停在约 `-28 mm` 后又被推到 `-116 mm`。改为只保留一次正向上抬波：确认回弹后再次左移到 `RawX<=-42 mm` 即回 `0°`，若随后在 `-60~-40 mm` 低速则直接冻结零度。 |
| 2026-08-01 Q3 短上抬波与首趟制动 | 最新日志第一次在 `X=+34 mm` 下发反刹后只到 `-28 mm`，完整补送使运行必然超过 `5 s`；第二趟预捕获后又等到 `X=-47 mm、即时速度=-158 mm/s` 才回零，撤坡后冲到 `-101 mm`。返程反刹位置由 `+35 mm` 延后到中心 `0 mm`；负端 `+1.8°` 上抬波改为原始帧速度刚转为 `>=+5 mm/s` 就立即回 `0°`，不再等待第二次左移。 |
| 2026-08-01 Q3 脉冲落地与局部保持 | 最新日志正端峰值达到 `+78 mm`，中心反刹又把负端送到 `-84 mm`；预捕获发生时即时速度已经为正，同一轮代码立即回零，步进没有真正执行 `+1.8°` 脉冲。机械零度随后让小球在 `-85~+107 mm` 间自由往返。正端切换提前到 `+5 mm`，反刹位置按两次实测插值取 `+20 mm`；预捕获改为 `+2.2°` 且至少保持 `100 ms`，结束后回到 `+1.8°` 局部平衡角而非机械零度。 |
| 2026-08-01 Q3 捕获位置-速度 PD | 固定 `+1.8°` 只能补偿局部坡度，无法根据动量抑制 `-85~+107 mm` 的自由往返。保留 `+2.2°、100 ms` 换向脉冲，随后由位置误差生成 `Vref=clamp(-2*(RawX+50), ±70 mm/s)`，再以 `0.025*(V-Vref)` 在局部偏置上修正最多 `±2°`。捕获段无积分；低速交接必须等 PD 已接管，防止脉冲期间误判停稳。CCS 21 全量编译和链接通过，等待实机复测。 |
| 2026-08-01 Q3 串级 PD 首轮复测 | 正端峰值只有 `+22 mm`，负端捕获从 `X=-37 mm、V=+71.4 mm/s` 接管，角度达到 `+3.8°` 后在 `-15~-67 mm` 间完成一次受控摆动，最终稳定在 `-56 mm`，总时间 `5.13 s`。正端触发从 `+5` 后移到 `+20 mm`；捕获速度比例 `2.0->1.5/s`、上限 `70->60 mm/s`，速度阻尼 `0.025->0.040`、修正范围 `±2.0->±2.4°`，目标是满足正端位置并在第一次经过负端时制动。 |
| 2026-08-01 Q3 固定切换失效与负端卡死 | 固定 `+20 mm` 切换在本轮较高起滚速度下使正端冲到 `+111 mm`；负端 PD 最终停在 `-35 mm`，旧逻辑因未进 `-60~-40 mm` 合格区而恢复 `+3°`，但静摩擦使球不动，且重新制动要求 `V<=-100 mm/s`，形成永久卡死。正端改为 `X+0.6*clamp(V,0,80)>=40 mm` 的速度预测切换；预捕获门槛 `45->70 mm/s` 以提前换坡；低速位置越过 `-30 mm` 后直接交给终点自适应，不再重新冲刺。 |
| 2026-08-01 Q3 预测切换量化裕量 | 对照同一日志，`X=14 mm、V=43 mm/s` 时预测峰值为 `39.8 mm`，因比 `40 mm` 门槛低 `0.2 mm` 而漏掉本帧，直到下一帧 `X=32 mm` 才换坡。目标峰值仍为 `40 mm`，仅增加 `1 mm` 摄像头量化裕量，使预测达到 `39 mm` 即换坡；负端捕获参数保持不变，便于单独验证这一帧提前量。 |
| 2026-08-01 Q3 正端预测窗延长 | 加入量化裕量后，正端在 `X=21 mm、V=51.6 mm/s` 换坡，实际峰值约 `+69 mm`，比合格上限多约 `9 mm`；上一有效帧为 `X=15 mm、V=28.3 mm/s`。预测窗由 `0.60 s` 延长到 `0.85 s`，使上一帧预测值达到约 `39.1 mm` 并提前换坡。负端本轮在 `4.80 s、X=-57 mm` 正常完成，相关参数保持不变。 |

## 后续记录

```text
日期：
场地/赛道：
电池电压：
基础速度：
巡线参数：
速度环参数：
现象：
处理：
结论：
下一步：
```
