pkppkqsmall/MSPM0G3507-NUEDC-H-Ball-Car/(list of files, drawings)

Other design files:
Hardware/ProDoc_PCB6_2026-08-05.epro
