pkppkqsmall/MSPM0G3507-NUEDC-H-Ball-Car/Firmware/Drivers/OLED_Hardware_I2C/oled_hardware_i2c.c

#include "oled_hardware_i2c.h"
#include "oledfont.h"
#include "clock.h"

#define I2C_TIMEOUT_MS  (10)

static int oled_i2c_has_timed_out(unsigned long start)
{
    unsigned long now;

    mspm0_get_clock_ms(&now);
    return ((now - start) >= I2C_TIMEOUT_MS) ? 1 : 0;
}

//OLED的显存
//存放格式如下.
//[0]0 1 2 3 ... 127	
//[1]0 1 2 3 ... 127	
//[2]0 1 2 3 ... 127	
//[3]0 1 2 3 ... 127	
//[4]0 1 2 3 ... 127	
//[5]0 1 2 3 ... 127	
//[6]0 1 2 3 ... 127	
//[7]0 1 2 3 ... 127

void delay_ms(uint32_t ms)
{
    mspm0_delay_ms(ms);
}

static int mspm0_i2c_disable(void)
{
    DL_I2C_reset(I2C_OLED_INST);
    DL_GPIO_initDigitalOutput(GPIO_I2C_OLED_IOMUX_SCL);
    DL_GPIO_initDigitalInputFeatures(GPIO_I2C_OLED_IOMUX_SDA,
		 DL_GPIO_INVERSION_DISABLE, DL_GPIO_RESISTOR_NONE,
		 DL_GPIO_HYSTERESIS_DISABLE, DL_GPIO_WAKEUP_DISABLE);
    DL_GPIO_clearPins(GPIO_I2C_OLED_SCL_PORT, GPIO_I2C_OLED_SCL_PIN);
    DL_GPIO_enableOutput(GPIO_I2C_OLED_SCL_PORT, GPIO_I2C_OLED_SCL_PIN);
    return 0;
}

static int mspm0_i2c_enable(void)
{
    DL_I2C_reset(I2C_OLED_INST);
    DL_GPIO_initPeripheralInputFunctionFeatures(GPIO_I2C_OLED_IOMUX_SDA,
        GPIO_I2C_OLED_IOMUX_SDA_FUNC, DL_GPIO_INVERSION_DISABLE,
        DL_GPIO_RESISTOR_NONE, DL_GPIO_HYSTERESIS_DISABLE,
        DL_GPIO_WAKEUP_DISABLE);
    DL_GPIO_initPeripheralInputFunctionFeatures(GPIO_I2C_OLED_IOMUX_SCL,
        GPIO_I2C_OLED_IOMUX_SCL_FUNC, DL_GPIO_INVERSION_DISABLE,
        DL_GPIO_RESISTOR_NONE, DL_GPIO_HYSTERESIS_DISABLE,
        DL_GPIO_WAKEUP_DISABLE);
    DL_GPIO_enableHiZ(GPIO_I2C_OLED_IOMUX_SDA);
    DL_GPIO_enableHiZ(GPIO_I2C_OLED_IOMUX_SCL);
    DL_I2C_enablePower(I2C_OLED_INST);
    SYSCFG_DL_I2C_OLED_init();
    return 0;
}

static int oled_i2c_wait_controller_idle(void)
{
    unsigned long start;

    mspm0_get_clock_ms(&start);
    while (!(DL_I2C_getControllerStatus(I2C_OLED_INST) & DL_I2C_CONTROLLER_STATUS_IDLE)) {
        if (oled_i2c_has_timed_out(start) != 0) {
            oled_i2c_sda_unlock();
            return -1;
        }
    }

    return 0;
}

void oled_i2c_sda_unlock(void)
{
    uint8_t cycleCnt = 0;
    mspm0_i2c_disable();
    do
    {
        DL_GPIO_clearPins(GPIO_I2C_OLED_SCL_PORT, GPIO_I2C_OLED_SCL_PIN);
        mspm0_delay_ms(1);
        DL_GPIO_setPins(GPIO_I2C_OLED_SCL_PORT, GPIO_I2C_OLED_SCL_PIN);
        mspm0_delay_ms(1);

        if(DL_GPIO_readPins(GPIO_I2C_OLED_SDA_PORT, GPIO_I2C_OLED_SDA_PIN))
            break;
    }while(++cycleCnt < 100);
    mspm0_i2c_enable();
}

//反显函数
void OLED_ColorTurn(uint8_t i)
{
    if(i==0)
    {
        OLED_WR_Byte(0xA6,OLED_CMD);//正常显示
    }
    if(i==1)
    {
        OLED_WR_Byte(0xA7,OLED_CMD);//反色显示
    }
}

//屏幕旋转180度
void OLED_DisplayTurn(uint8_t i)
{
if(i==0)
    {
        OLED_WR_Byte(0xC8,OLED_CMD);//正常显示
        OLED_WR_Byte(0xA1,OLED_CMD);
    }
    if(i==1)
    {
        OLED_WR_Byte(0xC0,OLED_CMD);//反转显示
        OLED_WR_Byte(0xA0,OLED_CMD);
    }
}

//发送一个字节
//向SSD1306写入一个字节。
//mode:数据/命令标志 0,表示命令;1,表示数据;
void OLED_WR_Byte(uint8_t dat,uint8_t mode)
{
    unsigned char ptr[2];
    unsigned long start;

    if(mode)
    {
        ptr[0] = 0x40;
        ptr[1] = dat;
    }
    else
    {
        ptr[0] = 0x00;
        ptr[1] = dat;
    }

    DL_I2C_fillControllerTXFIFO(I2C_OLED_INST, ptr, 2);
    DL_I2C_clearInterruptStatus(I2C_OLED_INST, DL_I2C_INTERRUPT_CONTROLLER_TX_DONE);
    if (oled_i2c_wait_controller_idle() != 0) {
        return;
    }

    DL_I2C_startControllerTransfer(I2C_OLED_INST, 0x3C, DL_I2C_CONTROLLER_DIRECTION_TX, 2);
    mspm0_get_clock_ms(&start);

    while (!DL_I2C_getRawInterruptStatus(I2C_OLED_INST, DL_I2C_INTERRUPT_CONTROLLER_TX_DONE))
    {
        if(oled_i2c_has_timed_out(start) != 0)
        {
            oled_i2c_sda_unlock();
            break;
        }
    }
}

//坐标设置
void OLED_Set_Pos(uint8_t x, uint8_t y) 
{ 
    OLED_WR_Byte(0xb0+y,OLED_CMD);
    OLED_WR_Byte(((x&0xf0)>>4)|0x10,OLED_CMD);
    OLED_WR_Byte((x&0x0f),OLED_CMD);
}

//开启OLED显示    
void OLED_Display_On(void)
{
    OLED_WR_Byte(0X8D,OLED_CMD);  //SET DCDC命令
    OLED_WR_Byte(0X14,OLED_CMD);  //DCDC ON
    OLED_WR_Byte(0XAF,OLED_CMD);  //DISPLAY ON
}

//关闭OLED显示     
void OLED_Display_Off(void)
{
    OLED_WR_Byte(0X8D,OLED_CMD);  //SET DCDC命令
    OLED_WR_Byte(0X10,OLED_CMD);  //DCDC OFF
    OLED_WR_Byte(0XAE,OLED_CMD);  //DISPLAY OFF
}
	 
//清屏函数,清完屏,整个屏幕是黑色的!和没点亮一样!!!	  
void OLED_Clear(void)  
{  
    uint8_t i,n;		    
    for(i=0;i<8;i++)  
    {  
        OLED_WR_Byte (0xb0+i,OLED_CMD);    //设置页地址（0~7）
        OLED_WR_Byte (0x00,OLED_CMD);      //设置显示位置—列低地址
        OLED_WR_Byte (0x10,OLED_CMD);      //设置显示位置—列高地址   
        for(n=0;n<128;n++)OLED_WR_Byte(0,OLED_DATA); 
    } //更新显示
}

//在指定位置显示一个字符,包括部分字符
//x:0~127
//y:0~63				 
//sizey:选择字体 6x8  8x16
void OLED_ShowChar(uint8_t x,uint8_t y,uint8_t chr,uint8_t sizey)
{      	
    uint8_t c=0,sizex=sizey/2;
    uint16_t i=0,size1;
    if(sizey==8)size1=6;
    else size1=(sizey/8+((sizey%8)?1:0))*(sizey/2);
    c=chr-' ';//得到偏移后的值
    OLED_Set_Pos(x,y);
    for(i=0;i<size1;i++)
    {
        if(i%sizex==0&&sizey!=8) OLED_Set_Pos(x,y++);
        if(sizey==8) OLED_WR_Byte(asc2_0806[c][i],OLED_DATA);//6X8字号
        else if(sizey==16) OLED_WR_Byte(asc2_1608[c][i],OLED_DATA);//8x16字号
        //		else if(sizey==xx) OLED_WR_Byte(asc2_xxxx[c][i],OLED_DATA);//用户添加字号
        else return;
    }
}

//m^n函数
uint32_t oled_pow(uint8_t m,uint8_t n)
{
    uint32_t result=1;	 
    while(n--)result*=m;    
    return result;
}

//显示数字
//x,y :起点坐标
//num:要显示的数字
//len :数字的位数
//sizey:字体大小		  
void OLED_ShowNum(uint8_t x,uint8_t y,uint32_t num,uint8_t len,uint8_t sizey)
{         	
    uint8_t t,temp,m=0;
    uint8_t enshow=0;
    if(sizey==8)m=2;
    for(t=0;t<len;t++)
    {
        temp=(num/oled_pow(10,len-t-1))%10;
        if(enshow==0&&t<(len-1))
        {
            if(temp==0)
            {
                OLED_ShowChar(x+(sizey/2+m)*t,y,' ',sizey);
                continue;
            }else enshow=1;
        }
        OLED_ShowChar(x+(sizey/2+m)*t,y,temp+'0',sizey);
    }
}

//显示一个字符号串
void OLED_ShowString(uint8_t x,uint8_t y,uint8_t *chr,uint8_t sizey)
{
    uint8_t j=0;
    while (chr[j]!='\0')
    {		
        OLED_ShowChar(x,y,chr[j++],sizey);
        if(sizey==8)x+=6;
        else x+=sizey/2;
    }
}

//显示汉字
void OLED_ShowChinese(uint8_t x,uint8_t y,uint8_t no,uint8_t sizey)
{
    uint16_t i,size1=(sizey/8+((sizey%8)?1:0))*sizey;
    for(i=0;i<size1;i++)
    {
        if(i%sizey==0) OLED_Set_Pos(x,y++);
        if(sizey==16) OLED_WR_Byte(Hzk[no][i],OLED_DATA);//16x16字号
        //		else if(sizey==xx) OLED_WR_Byte(xxx[c][i],OLED_DATA);//用户添加字号
        else return;
    }				
}

//显示图片
//x,y显示坐标
//sizex,sizey,图片长宽
//BMP：要显示的图片
void OLED_DrawBMP(uint8_t x,uint8_t y,uint8_t sizex, uint8_t sizey,uint8_t BMP[])
{ 	
    uint16_t j=0;
    uint8_t i,m;
    sizey=sizey/8+((sizey%8)?1:0);
    for(i=0;i<sizey;i++)
    {
        OLED_Set_Pos(x,i+y);
        for(m=0;m<sizex;m++)
        {      
            OLED_WR_Byte(BMP[j++],OLED_DATA);	    	
        }
    }
}

//初始化SSD1306					    
void OLED_Init(void)
{
    if(DL_I2C_getSDAStatus(I2C_OLED_INST) == DL_I2C_CONTROLLER_SDA_LOW)
        oled_i2c_sda_unlock();

    delay_ms(200);

    OLED_WR_Byte(0xAE,OLED_CMD);//--turn off oled panel
    OLED_WR_Byte(0x00,OLED_CMD);//---set low column address
    OLED_WR_Byte(0x10,OLED_CMD);//---set high column address
    OLED_WR_Byte(0x40,OLED_CMD);//--set start line address  Set Mapping RAM Display Start Line (0x00~0x3F)
    OLED_WR_Byte(0x81,OLED_CMD);//--set contrast control register
    OLED_WR_Byte(0xCF,OLED_CMD); // Set SEG Output Current Brightness
    OLED_WR_Byte(0xA1,OLED_CMD);//--Set SEG/Column Mapping     0xa0左右反置 0xa1正常
    OLED_WR_Byte(0xC8,OLED_CMD);//Set COM/Row Scan Direction   0xc0上下反置 0xc8正常
    OLED_WR_Byte(0xA6,OLED_CMD);//--set normal display
    OLED_WR_Byte(0xA8,OLED_CMD);//--set multiplex ratio(1 to 64)
    OLED_WR_Byte(0x3f,OLED_CMD);//--1/64 duty
    OLED_WR_Byte(0xD3,OLED_CMD);//-set display offset	Shift Mapping RAM Counter (0x00~0x3F)
    OLED_WR_Byte(0x00,OLED_CMD);//-not offset
    OLED_WR_Byte(0xd5,OLED_CMD);//--set display clock divide ratio/oscillator frequency
    OLED_WR_Byte(0x80,OLED_CMD);//--set divide ratio, Set Clock as 100 Frames/Sec
    OLED_WR_Byte(0xD9,OLED_CMD);//--set pre-charge period
    OLED_WR_Byte(0xF1,OLED_CMD);//Set Pre-Charge as 15 Clocks & Discharge as 1 Clock
    OLED_WR_Byte(0xDA,OLED_CMD);//--set com pins hardware configuration
    OLED_WR_Byte(0x12,OLED_CMD);
    OLED_WR_Byte(0xDB,OLED_CMD);//--set vcomh
    OLED_WR_Byte(0x40,OLED_CMD);//Set VCOM Deselect Level
    OLED_WR_Byte(0x20,OLED_CMD);//-Set Page Addressing Mode (0x00/0x01/0x02)
    OLED_WR_Byte(0x02,OLED_CMD);//
    OLED_WR_Byte(0x8D,OLED_CMD);//--set Charge Pump enable/disable
    OLED_WR_Byte(0x14,OLED_CMD);//--set(0x10) disable
    OLED_WR_Byte(0xA4,OLED_CMD);// Disable Entire Display On (0xa4/0xa5)
    OLED_WR_Byte(0xA6,OLED_CMD);// Disable Inverse Display On (0xa6/a7) 
    OLED_Clear();
    OLED_WR_Byte(0xAF,OLED_CMD); /*display ON*/ 
}  
