pkppkqsmall/MSPM0G3507-NUEDC-H-Ball-Car/Firmware/App/MapRun/map_run.c

#include "map_run.h"

#include <stdint.h>
#include <stdio.h>
#include <stdlib.h>
#include <string.h>

#include "ball_beam_controller.h"
#include "bno085.h"
#include "camera_link.h"
#include "clock.h"
#include "interrupt.h"
#include "map_curve_hold.h"
#include "map_line_controller.h"
#include "map_yaw_rate_controller.h"
#include "motor_pwm.h"
#include "oled_hardware_i2c.h"
#include "Sensor.h"
#include "stepper_motor.h"
#include "ti_msp_dl_config.h"

/*
 * 题目地图运行参数：灰度位置外环、BNO085 角速度内环，
 * 最内层仍由左右轮速度 PI 跟随目标 RPM。
 */
#define MAP_RUN_Q2_BASE_SPEED_RPM                (120.0f)
#define MAP_RUN_Q2_BRAKE_HOLD_MS                 (100UL)
#define MAP_RUN_Q3_START_CENTER_LIMIT_MM            (15.0f)
#define MAP_RUN_Q3_POSITIVE_TARGET_MIN_MM               (40.0f)
#define MAP_RUN_Q3_POSITIVE_SWITCH_MARGIN_MM              (1.0f)
#define MAP_RUN_Q3_POSITIVE_PREDICTION_S                 (0.85f)
#define MAP_RUN_Q3_POSITIVE_PREDICTION_MAX_SPEED_MM_S   (80.0f)
#define MAP_RUN_Q3_POSITIVE_RETURN_MIN_SPEED_MM_S      (5.0f)
#define MAP_RUN_Q3_NEGATIVE_HOLD_MM                 (-50.0f)
#define MAP_RUN_Q3_POSITIVE_DRIVE_ANGLE_DEG             (-4.50f)
#define MAP_RUN_Q3_LEFT_DRIVE_ANGLE_DEG                (3.0f)
#define MAP_RUN_Q3_NEGATIVE_BRAKE_TRIGGER_MM            (20.0f)
#define MAP_RUN_Q3_NEGATIVE_BRAKE_MIN_SPEED_MM_S      (-100.0f)
#define MAP_RUN_Q3_CATCH_BALANCE_BIAS_DEG               (1.8f)
#define MAP_RUN_Q3_CATCH_FRAME_SPEED_BLEND              (0.75f)
#define MAP_RUN_Q3_CATCH_FRAME_DELTA_MIN_MM              (0.5f)
#define MAP_RUN_Q3_CATCH_MAX_SPEED_MM_S                (250.0f)
#define MAP_RUN_Q3_CATCH_LOW_SPEED_MM_S                 (12.0f)
#define MAP_RUN_Q3_CATCH_REBOUND_CONFIRM_MM_S             (5.0f)
#define MAP_RUN_Q3_CATCH_LOW_SPEED_CONFIRM_MS           (75UL)
#define MAP_RUN_Q3_PRE_CATCH_TRIGGER_MM                  (-35.0f)
#define MAP_RUN_Q3_PRE_CATCH_MAX_SPEED_MM_S               (70.0f)
#define MAP_RUN_Q3_PRE_CATCH_ANGLE_DEG                     (2.2f)
#define MAP_RUN_Q3_CATCH_PULSE_MIN_MS                       (100UL)
#define MAP_RUN_Q3_CAPTURE_MAX_EXPECTED_SPEED_MM_S           (60.0f)
#define MAP_RUN_Q3_CAPTURE_POSITION_RATE_PER_S                (1.5f)
#define MAP_RUN_Q3_CAPTURE_SPEED_KD_DEG_PER_MM_S              (0.040f)
#define MAP_RUN_Q3_CAPTURE_MAX_CORRECTION_DEG                  (2.4f)
#define MAP_RUN_Q3_TERMINAL_HANDOFF_MIN_MM                  (-30.0f)
#define MAP_RUN_Q3_BRAKE_DISTANCE_MM                   (70.0f)
#define MAP_RUN_Q3_BRAKE_SPEED_MARGIN_MM_S             (40.0f)
#define MAP_RUN_Q3_ROLL_ACCEL_M_S2_PER_RAD              (7.007f)
#define MAP_RUN_Q3_RAD_TO_DEG                          (57.29578f)
#define MAP_RUN_Q3_BRAKE_MODEL_GAIN                     (3.00f)
#define MAP_RUN_Q3_BRAKE_MIN_ANGLE_DEG                  (1.5f)
#define MAP_RUN_Q3_BRAKE_MAX_ANGLE_DEG                  (3.0f)
#define MAP_RUN_Q3_HOLD_KP_DEG_PER_MM                     (0.060f)
#define MAP_RUN_Q3_HOLD_KI_DEG_PER_MM_S                   (0.050f)
#define MAP_RUN_Q3_HOLD_KD_DEG_PER_MM_S                   (0.040f)
#define MAP_RUN_Q3_HOLD_PROFILE_MAX_SPEED_MM_S             (35.0f)
#define MAP_RUN_Q3_HOLD_PROFILE_POSITION_RATE_PER_S         (1.20f)
#define MAP_RUN_Q3_HOLD_PROFILE_BLEND_START_MM               (6.0f)
#define MAP_RUN_Q3_HOLD_PROFILE_BLEND_FULL_MM               (15.0f)
#define MAP_RUN_Q3_HOLD_STICTION_ERROR_MIN_MM                (8.0f)
#define MAP_RUN_Q3_HOLD_STICTION_SPEED_MAX_MM_S               (6.0f)
#define MAP_RUN_Q3_HOLD_STICTION_FRAME_DELTA_MAX_MM            (0.5f)
#define MAP_RUN_Q3_HOLD_STICTION_BREAKAWAY_ANGLE_DEG            (4.5f)
#define MAP_RUN_Q3_HOLD_STICTION_CONFIRM_MS                  (150UL)
#define MAP_RUN_Q3_HOLD_STICTION_CONFIRM_TRAVEL_MM             (1.0f)
#define MAP_RUN_Q3_HOLD_STICTION_KICK_MS                     (100UL)
#define MAP_RUN_Q3_HOLD_STICTION_REARM_MS                    (250UL)
#define MAP_RUN_Q3_HOLD_STICTION_RELEASE_SPEED_MM_S             (8.0f)
#define MAP_RUN_Q3_HOLD_INITIAL_BIAS_DEG                  (1.8f)
#define MAP_RUN_Q3_HOLD_MAX_BIAS_DEG                      (2.0f)
#define MAP_RUN_Q3_HOLD_MAX_ANGLE_DEG                     (3.5f)
#define MAP_RUN_Q3_HOLD_STICTION_MAX_ANGLE_DEG            (4.5f)
#define MAP_RUN_Q3_HOLD_I_MAX_ERROR_MM                   (25.0f)
#define MAP_RUN_Q3_HOLD_I_MAX_SPEED_MM_S                 (10.0f)
#define MAP_RUN_Q3_HOLD_POSITION_DEADBAND_MM              (1.0f)
#define MAP_RUN_Q3_HOLD_SPEED_DEADBAND_MM_S               (2.0f)
#define MAP_RUN_Q3_HOLD_DIRECTION_DELTA_MM                 (0.25f)
#define MAP_RUN_Q3_HOLD_FRAME_SPEED_DELTA_MM               (0.50f)
#define MAP_RUN_Q3_HOLD_FRAME_SPEED_BLEND                  (0.75f)
#define MAP_RUN_Q3_HOLD_FRAME_PERIOD_MS                   (25.0f)
#define MAP_RUN_Q3_HOLD_MAX_FRAME_SPEED_MM_S              (80.0f)
#define MAP_RUN_Q3_HOLD_MAX_FRAME_MS                    (100UL)
#define MAP_RUN_Q3_HOLD_ANGLE_FILTER_ALPHA                 (0.50f)
#define MAP_RUN_Q3_HOLD_MAX_ANGLE_STEP_DEG                  (0.45f)
#define MAP_RUN_Q3_HOLD_ENTRY_ESCAPE_SPEED_MM_S            (15.0f)
#define MAP_RUN_Q3_HOLD_ENTRY_APPROACH_SPEED_MM_S          (30.0f)
#define MAP_RUN_Q3_HOLD_ENTRY_BRAKE_DISTANCE_MM            (25.0f)
#define MAP_RUN_Q3_HOLD_ENTRY_BRAKE_WINDOW_MS             (5000UL)
#define MAP_RUN_Q3_HOLD_ENTRY_BRAKE_ANGLE_DEG                (4.5f)
#define MAP_RUN_Q3_HOLD_STALE_BIAS_DEG                    (0.8f)
#define MAP_RUN_Q3_SETTLE_MIN_POSITION_MM             (-60.0f)
#define MAP_RUN_Q3_SETTLE_MAX_POSITION_MM             (-40.0f)
#define MAP_RUN_Q3_SETTLE_CONFIRM_MS                   (100UL)
#define MAP_RUN_Q3_SETTLE_CONFIRM_MAX_DELTA_MM           (1.0f)
#define MAP_RUN_Q3_SETTLE_VERIFY_MS                    (250UL)
#define MAP_RUN_Q3_SETTLE_VERIFY_MAX_DELTA_MM           (2.0f)
#define MAP_RUN_Q3_SETTLE_MAX_SPEED_MM_S                (8.0f)
#define MAP_RUN_Q3_SETTLE_FINISH_MAX_SPEED_MM_S         (4.0f)
#define MAP_RUN_Q3_SETTLE_MAX_FRAME_DELTA_MM             (1.0f)
#define MAP_RUN_Q3_STALE_TIMEOUT_MS                    (250UL)
#define MAP_RUN_Q4_STALE_TIMEOUT_MS                    (300UL)
#define MAP_RUN_BALL_SAFE_MAX_SPEED_MM_S              (60.0f)
#define MAP_RUN_BALL_SAFE_POSITION_RATE_PER_S          (1.2f)
#define MAP_RUN_Q3_TIME_LIMIT_MS                    (5000UL)
#define MAP_RUN_Q4_BASE_SPEED_RPM                 (88.0f)
#define MAP_RUN_Q4_START_SPEED_RPM                (30.0f)
#define MAP_RUN_Q4_START_HOLD_MS                  (200UL)
#define MAP_RUN_Q4_START_RAMP_MS                 (1400UL)
#define MAP_RUN_Q4_START_FF_PEAK_DEG              (1.30f)
#define MAP_RUN_Q4_START_PRELOAD_DEG               (0.85f)
#define MAP_RUN_Q4_START_PRELOAD_RAMP_MS          (180UL)
#define MAP_RUN_Q4_START_PRELOAD_FADE_MS          (600UL)
#define MAP_RUN_Q4_START_FF_RELEASE_SPEED_MM_S    (10.0f)
#define MAP_RUN_Q4_START_FF_RELEASE_MIN_X_MM        (-2.0f)
#define MAP_RUN_Q4_BRAKE_FF_PEAK_DEG              (0.70f)
#define MAP_RUN_Q4_FINAL_STOP_RAMP_MS             (900UL)
#define MAP_RUN_Q4_FINAL_STOP_FF_PEAK_DEG           (0.45f)
#define MAP_RUN_Q4_STOP_FF_DEG                      (0.80f)
#define MAP_RUN_Q4_STOP_FF_HOLD_MS                (300UL)
#define MAP_RUN_Q4_STOP_FF_FADE_MS                (500UL)
#define MAP_RUN_Q4_STOP_FF_RELEASE_SPEED_MM_S      (12.0f)
#define MAP_RUN_Q4_STOP_FF_DISABLE_X_MM             (-8.0f)
#define MAP_RUN_Q4_POSITION_GUARD_DEADBAND_MM       (2.0f)
#define MAP_RUN_Q4_POSITION_GUARD_GAIN_DEG_PER_MM   (0.055f)
#define MAP_RUN_Q4_POSITION_GUARD_MAX_DEG           (0.75f)
#define MAP_RUN_Q4_PARK_GUARD_DEADBAND_MM           (10.0f)
#define MAP_RUN_Q4_PARK_GUARD_GAIN_DEG_PER_MM        (0.10f)
#define MAP_RUN_Q4_PARK_GUARD_MAX_DEG                (1.00f)
#define MAP_RUN_Q4_PARK_GUARD_MAX_SPEED_MM_S         (6.0f)
#define MAP_RUN_Q4_VELOCITY_WINDOW_MIN_MS           (35UL)
#define MAP_RUN_Q4_VELOCITY_WINDOW_MAX_MS          (140UL)
#define MAP_RUN_Q4_VELOCITY_DELTA_DEADBAND_MM        (0.35f)
#define MAP_RUN_Q4_VELOCITY_FILTER_ALPHA             (0.65f)
#define MAP_RUN_Q4_VELOCITY_FAST_BLEND               (0.80f)
#define MAP_RUN_Q4_VELOCITY_REVERSAL_MIN_MM_S         (5.0f)
#define MAP_RUN_Q4_VELOCITY_MAX_MM_S                (120.0f)
#define MAP_RUN_Q4_VELOCITY_DAMPING_GAIN             (0.018f)
#define MAP_RUN_Q4_VELOCITY_DAMPING_MAX_DEG          (0.90f)
#define MAP_RUN_Q4_EXTERNAL_FF_MAX_DEG              (1.50f)
#define MAP_RUN_Q4_RECOVERY_MAX_SPEED_MM_S          (15.0f)
#define MAP_RUN_Q4_RECOVERY_POSITION_RATE_PER_S      (0.50f)
#define MAP_RUN_Q4_PARK_MAX_SPEED_MM_S              (15.0f)
#define MAP_RUN_Q4_PARK_POSITION_RATE_PER_S           (0.5f)
#define MAP_RUN_BALL_BASE_SPEED_RPM               (85.0f)
#define MAP_RUN_BALL_START_SPEED_RPM              (30.0f)
#define MAP_RUN_BALL_START_HOLD_MS                (200UL)
#define MAP_RUN_BALL_START_RAMP_MS               (1400UL)
#define MAP_RUN_BALL_START_FF_PEAK_DEG              (1.55f)
#define MAP_RUN_BALL_START_PRELOAD_DEG               (1.05f)
#define MAP_RUN_BALL_START_PRELOAD_RAMP_MS          (180UL)
#define MAP_RUN_BALL_START_PRELOAD_FADE_MS          (600UL)
#define MAP_RUN_BALL_START_EXTERNAL_FF_MAX_DEG        (2.20f)
#define MAP_RUN_BALL_START_FF_RELEASE_SPEED_MM_S     (10.0f)
#define MAP_RUN_BALL_START_FF_RELEASE_MIN_ERROR_MM    (-2.0f)
#define MAP_RUN_BALL_FINAL_STOP_RAMP_MS              (500UL)
#define MAP_RUN_BALL_FINAL_STOP_FF_PEAK_DEG            (0.80f)
#define MAP_RUN_BALL_TARGET_POSITION_MM_Q5           (0.0f)
#define MAP_RUN_BALL_START_TARGET_LIMIT_MM           (10.0f)
#define MAP_RUN_BALL_ALLOWED_ERROR_MM                 (10.0f)
#define MAP_RUN_BALL_TIME_LIMIT_MS                 (30000UL)
#define MAP_RUN_BALL_STALE_TIMEOUT_MS                (300UL)
#define MAP_RUN_BALL_RECOVERY_MAX_SPEED_MM_S          (20.0f)
#define MAP_RUN_BALL_RECOVERY_POSITION_RATE_PER_S       (0.75f)
#define MAP_RUN_BALL_PARK_MAX_SPEED_MM_S              (15.0f)
#define MAP_RUN_BALL_PARK_POSITION_RATE_PER_S           (0.50f)
#define MAP_RUN_BALL_LINE_REFERENCE_RPM           (80.0f)
#define MAP_RUN_BALL_CENTER_RECOVERY_RPM_PER_STEP  (1.0f)
#define MAP_RUN_BALL_MIN_TARGET_RPM                (25.0f)
#define MAP_RUN_BALL_MAX_OUTER_TARGET_RPM          (95.0f)
#define MAP_RUN_BALL_TARGET_RISE_RPM_PER_STEP       (3.0f)
#define MAP_RUN_BALL_OUTER_ERROR_START              (2.0f)
#define MAP_RUN_BALL_OUTER_ERROR_GAIN               (1.5f)
#define MAP_RUN_SPEED_TEST_DEFAULT_RPM           (50.0f)
#define MAP_RUN_LOW_TARGET_STOP_RPM               (30.0f)
#define MAP_RUN_CENTER_RECOVERY_RPM_PER_STEP       (2.0f)
#define MAP_RUN_STABLE_CENTER_ERROR_LIMIT          (2.1f)
#define MAP_RUN_STABLE_CENTER_ERROR_SCALE          (0.5f)
#define MAP_RUN_BALL_CENTER_ERROR_SCALE            (0.25f)

#define MAP_RUN_CONTROL_PERIOD_MS                (10UL)
#define MAP_RUN_SPEED_PERIOD_MS                  (20UL)
#define MAP_RUN_TELEMETRY_PERIOD_MS              (50UL)
#define MAP_RUN_BALL_LOG_PERIOD_MS               (100UL)
#define MAP_RUN_BALL_LAP_TELEMETRY_PERIOD_MS     (250UL)
#define MAP_RUN_BALL_POST_FINISH_TELEMETRY_MS   (5000UL)
#define MAP_RUN_DISPLAY_PERIOD_MS                (100UL)

/*
 * 调试蓝牙自动刷屏开关。关闭只影响主动推送，不影响摄像头解析、
 * 滚球控制以及 BALL?/CAM?/CAR? 等查询命令。
 */
#define MAP_RUN_AUTO_SPEED_TELEMETRY_ENABLED      (0U)
#define MAP_RUN_AUTO_CAMERA_FORWARD_ENABLED       (0U)

#define MAP_RUN_BUTTON_DEBOUNCE_MS               (30UL)
#define MAP_RUN_BUTTON_LONG_PRESS_MS             (1500UL)
#define MAP_RUN_TELEMETRY_TX_WAIT_LIMIT           (100000UL)
#define MAP_RUN_UART_RX_BUFFER_SIZE               (128U)
#define MAP_RUN_UART_LINE_BUFFER_SIZE             (64U)
#define MAP_RUN_SPEED_TEST_MAX_ABS_RPM             (150.0f)
#define MAP_RUN_ENCODER_FEEDBACK_TIMEOUT_MS        (400UL)

/*
 * 728 count/圈、65 mm 车轮时约为 35.65 count/cm。
 * 题图一圈约 21895 count；21300 count 后才允许 5 cm 启停线触发，
 * 防止普通赛道上的 2~3 路黑线在前半圈造成误停车。
 */
#define MAP_RUN_START_LINE_LEAVE_COUNTS          (120UL)
#define MAP_RUN_LAP_ARM_COUNTS                   (21300UL)
#define MAP_RUN_FINISH_LINE_ACTIVE_MIN           (3U)
#define MAP_RUN_NORMAL_LINE_ACTIVE_MAX           (3U)
#define MAP_RUN_START_LINE_LEAVE_CONFIRM         (3U)
#define MAP_RUN_FINISH_LINE_CONFIRM              (3U)

/*
 * Q5/Q6 不再依赖横线：按实测停车点减去 0.5 m，且累计转动满 360 度后缓停。
 * 若 IMU 未更新或安装方向配置错误，最大距离兜底可避免车辆无限绕圈。
 */
#define MAP_RUN_BALL_FIXED_STOP_COUNTS            (25590UL)
#define MAP_RUN_BALL_FIXED_STOP_MAX_COUNTS        (28220UL)
#define MAP_RUN_BALL_FIXED_STOP_TURN_DEG            (360.0f)
#define MAP_RUN_BALL_IMU_MIN_PLAUSIBLE_TURN_DEG      (30.0f)
#define MAP_RUN_BALL_YAW_MAX_SAMPLE_DELTA_DEG        (45.0f)

/* 最后一段用起跑航向约束出弯姿态，再由原角速度内环消除残余转动。 */
#define MAP_RUN_FINISH_HEADING_ARM_COUNTS        (21000UL)
#define MAP_RUN_FINISH_HEADING_KP_RATE_PER_DEG      (2.0f)
#define MAP_RUN_FINISH_HEADING_RATE_LIMIT_DEG_S    (40.0f)

/*
 * 第 4 问 A->B：65 mm 车轮、728 count/圈时，1.5 m 约为 5348 count。
 * 灰度探头在轮轴前方，先在接近 B 点时锁存右二探头，再等车轴通过 B。
 * 正常越过 B 点约 9.8 cm 后开始最终缓停；若右二探头没有可靠触发，
 * 则 5950 count 作为距离兜底停车条件。
 */
#define MAP_RUN_Q4_RIGHT_SECOND_MASK             (0x40U)
#define MAP_RUN_Q4_SENSOR_ARM_COUNTS             (4500UL)
#define MAP_RUN_Q4_BRAKE_START_COUNTS            (4950UL)
#define MAP_RUN_Q4_TARGET_STOP_COUNTS            (5700UL)
#define MAP_RUN_Q4_MAX_STOP_COUNTS               (5950UL)
#define MAP_RUN_Q4_APPROACH_SPEED_RPM              (35.0f)
#define MAP_RUN_Q4_TARGET_POSITION_MM                (0.0f)
#define MAP_RUN_Q4_START_CENTER_LIMIT_MM             (10.0f)
#define MAP_RUN_Q4_ALLOWED_ERROR_MM                  (10.0f)

#define SENSOR_CALIBRATION_ENTER_HOLD_MS         (4200UL)
#define SENSOR_CALIBRATION_SHORT_HOLD_MS         (150UL)
#define SENSOR_CALIBRATION_SETTLE_MS             (800UL)
#define SENSOR_CALIBRATION_DONE_HOLD_MS          (1200UL)

typedef enum {
    MAP_RUN_STATE_READY = 0,
    MAP_RUN_STATE_RUNNING,
    MAP_RUN_STATE_FINISHED
} MapRunState;

typedef enum {
    MAP_CONTROL_LINE_FOLLOW = 0,
    MAP_CONTROL_SPEED_TEST
} MapControlMode;

typedef enum {
    MAP_QUESTION_MODE_1_Q2 = 1,
    MAP_QUESTION_MODE_2_Q3,
    MAP_QUESTION_MODE_3_Q4,
    MAP_QUESTION_MODE_4_Q5,
    MAP_QUESTION_MODE_5_Q6
} MapQuestionMode;

typedef enum {
    MAP_FINISH_NONE = 0,
    MAP_FINISH_ONE_LAP,
    MAP_FINISH_Q3_COMPLETE,
    MAP_FINISH_Q4_B_PASSED,
    MAP_FINISH_MANUAL,
    MAP_FINISH_ENCODER_FAULT,
    MAP_FINISH_NO_START_LINE
} MapFinishReason;

typedef enum {
    MAP_Q3_STATE_IDLE = 0,
    MAP_Q3_STATE_TO_POSITIVE,
    MAP_Q3_STATE_DRIVE_NEGATIVE,
    MAP_Q3_STATE_BRAKE_NEGATIVE,
    MAP_Q3_STATE_LEVEL_SETTLE,
    MAP_Q3_STATE_HOLD_NEGATIVE
} MapQ3State;

typedef enum {
    SENSOR_CALIBRATION_IDLE = 0,
    SENSOR_CALIBRATION_WAIT_STEPPER,
    SENSOR_CALIBRATION_ENTER_HOLD,
    SENSOR_CALIBRATION_ENTER_SETTLE,
    SENSOR_CALIBRATION_WAIT_BLACK,
    SENSOR_CALIBRATION_BLACK_HOLD,
    SENSOR_CALIBRATION_BLACK_SETTLE,
    SENSOR_CALIBRATION_WAIT_WHITE,
    SENSOR_CALIBRATION_WHITE_HOLD,
    SENSOR_CALIBRATION_DONE
} SensorCalibrationState;

typedef struct {
    unsigned long change_ms;
    unsigned long press_start_ms;
    uint8_t raw_pressed;
    uint8_t stable_pressed;
    uint8_t pressed_event;
    uint8_t short_release_event;
    uint8_t long_release_event;
    uint8_t suppress_release;
} MapRunButton;

static MapRunState g_map_state;
static MapControlMode g_control_mode;
static MapQuestionMode g_question_mode;
static MapFinishReason g_finish_reason;
static MapQ3State g_q3_state;
static SensorCalibrationState g_calibration_state;
static MapRunButton g_b21_button;
static MapRunButton g_sw1_button;
static MapRunButton g_sw2_button;

static unsigned long g_run_start_ms;
static unsigned long g_run_elapsed_ms;
static unsigned long g_last_control_ms;
static unsigned long g_last_speed_ms;
static unsigned long g_last_telemetry_ms;
static unsigned long g_last_ball_log_ms;
static unsigned long g_last_ball_lap_telemetry_ms;
static unsigned long g_last_display_ms;
static unsigned long g_calibration_state_start_ms;
static unsigned long g_motor_brake_start_ms;
static unsigned long g_q4_feedforward_update_ms;
static unsigned long g_q4_stop_feedforward_start_ms;
static unsigned long g_q4_final_stop_start_ms;
static unsigned long g_ball_lap_final_stop_start_ms;

static int32_t g_left_start_count;
static int32_t g_right_start_count;
static int32_t g_watchdog_left_encoder_count;
static int32_t g_watchdog_right_encoder_count;
static unsigned long g_watchdog_left_feedback_ms;
static unsigned long g_watchdog_right_feedback_ms;
static uint32_t g_run_distance_counts;
static uint8_t g_sensor_value;
static uint8_t g_sensor_active_count;
static uint8_t g_start_line_left;
static uint8_t g_lap_finish_armed;
static uint8_t g_start_line_leave_count;
static uint8_t g_finish_line_count;
static uint8_t g_q4_right_second_seen;
static uint8_t g_q4_ball_limit_exceeded;
static uint8_t g_q4_stop_feedforward_active;
static uint8_t g_q4_final_stop_active;
static uint8_t g_q4_park_hold_active;
static uint8_t g_q4_camera_fallback_active;
static uint8_t g_ball_lap_camera_fallback_active;
static uint8_t g_ball_lap_limit_exceeded;
static uint8_t g_ball_lap_completed_within_time;
static uint8_t g_ball_lap_final_stop_active;
static uint8_t g_motor_brake_active;
static uint8_t g_q3_completed_within_time;
static uint8_t g_q3_time_warning_sent;
static uint8_t g_q3_saved_pid_valid;
static uint8_t g_q3_manual_beam_active;
static uint8_t g_q3_hold_entry_seed_pending;
static uint8_t g_q3_hold_stiction_candidate_active;
static uint8_t g_q3_hold_stiction_kick_active;
static uint8_t g_q3_settle_lock_active;
static uint8_t g_q3_settle_capture_active;
static uint8_t g_q3_capture_pd_active;
static uint8_t g_q3_brake_low_speed_active;
static uint32_t g_q3_last_camera_frame_id;
static uint32_t g_q3_phase_start_ms;
static uint32_t g_q3_motion_last_ms;
static uint32_t g_q3_brake_low_speed_start_ms;
static uint32_t g_q3_catch_pulse_start_ms;
static uint32_t g_q3_window_start_ms;
static uint32_t g_q3_hold_last_update_ms;
static uint32_t g_q3_hold_last_camera_frame_id;
static uint32_t g_q3_hold_stiction_candidate_start_ms;
static uint32_t g_q3_hold_stiction_kick_start_ms;
static uint32_t g_q3_hold_stiction_rearm_start_ms;
static float g_q3_window_start_x_mm;
static float g_q3_window_min_x_mm;
static float g_q3_window_max_x_mm;
static float g_q3_hold_bias_deg;
static float g_q3_hold_last_filtered_x_mm;
static float g_q3_hold_frame_delta_mm;
static float g_q3_hold_feedback_speed_mm_s;
static float g_q3_hold_profile_target_speed_mm_s;
static float g_q3_hold_profile_blend;
static float g_q3_hold_stiction_position_deg;
static float g_q3_hold_stiction_candidate_x_mm;
static float g_q3_hold_stiction_kick_deg;
static float g_q3_manual_beam_angle_deg;
static float g_q3_settle_lock_angle_deg;
static float g_q3_brake_planned_speed_mm_s;
static float g_q3_brake_angle_deg;
static float g_q3_motion_last_x_mm;
static float g_q3_fresh_speed_mm_s;
static float g_q3_saved_kp;
static float g_q3_saved_ki;
static float g_q3_saved_kd;
static float g_q4_max_ball_error_mm;
static float g_q4_acceleration_feedforward_deg;
static float g_q4_position_guard_deg;
static float g_q4_velocity_damping_deg;
static float g_q4_fast_ball_speed_mm_s;
static float g_q4_velocity_feedback_mm_s;
static float g_q4_velocity_reference_x_mm;
static uint32_t g_q4_velocity_reference_frame_id;
static uint32_t g_q4_velocity_reference_receive_ms;
static uint8_t g_q4_velocity_observer_valid;
static float g_q4_final_stop_start_rpm;
static float g_q4_final_stop_left_duty_percent;
static float g_q4_final_stop_right_duty_percent;
static float g_ball_lap_final_stop_start_rpm;
static float g_ball_lap_final_stop_left_duty_percent;
static float g_ball_lap_final_stop_right_duty_percent;
static float g_q6_target_position_mm;
static float g_ball_lap_active_target_mm;
static float g_ball_lap_max_error_mm;
static float g_line_error;
static float g_base_speed_rpm;
static float g_correction_rpm;
static MapLineController g_line_controller;
static MapLineResult g_line_result;
static MapYawRateController g_yaw_rate_controller;
static MapCurveHold g_curve_hold;
static BallBeamController g_ball_beam_controller;
static float g_center_speed_rpm;
static float g_target_yaw_rate_deg_s;
static float g_measured_yaw_rate_deg_s;
static float g_yaw_turn_rpm;
static uint8_t g_yaw_cascade_active;
static float g_finish_heading_reference_yaw_deg;
static float g_finish_heading_error_deg;
static float g_finish_heading_rate_offset_deg_s;
static uint8_t g_finish_heading_reference_valid;
static uint8_t g_finish_heading_active;
static float g_ball_lap_previous_yaw_deg;
static float g_ball_lap_right_turn_deg;
static uint8_t g_ball_lap_yaw_valid;
static float g_speed_test_left_target_rpm;
static float g_speed_test_right_target_rpm;
static uint8_t g_display_buffer[32];
static volatile uint8_t g_uart_rx_buffer[MAP_RUN_UART_RX_BUFFER_SIZE];
static volatile uint16_t g_uart_rx_write_index;
static volatile uint16_t g_uart_rx_read_index;
static volatile uint8_t g_uart_rx_overflow;
static char g_uart_line_buffer[MAP_RUN_UART_LINE_BUFFER_SIZE];
static uint16_t g_uart_line_length;
static uint32_t g_camera_forwarded_frame_count;
static uint32_t g_camera_control_frame_count;
static uint8_t g_ball_stepper_zeroed;
static uint8_t g_ball_log_enabled;

static void MapRun_StopMotors(MapFinishReason reason);
static void MapRun_BeginQ4FinalStop(void);
static void MapRun_UpdateQ4FinalStop(void);
static void MapRun_BeginBallLapFinalStop(void);
static void MapRun_UpdateBallLapFinalStop(void);
static void MapRun_StartSpeedTest(void);
static void MapRun_DisableBallBeam(void);
static void MapRun_SendBallLogHeader(void);
static void MapRun_SendBallLogSample(void);
static void MapRun_EnableAutomaticBallLog(const char *question_text);
static void MapRun_ResetQ3StictionAssist(void);
static float MapRun_AbsFloat(float value);
static void MapRun_ResetBallLapTurnTracking(uint8_t seed_current_yaw);

static uint8_t MapRun_IsQ3Mode(void)
{
    return (g_question_mode == MAP_QUESTION_MODE_2_Q3) ? 1U : 0U;
}

static uint8_t MapRun_IsQ4Mode(void)
{
    return (g_question_mode == MAP_QUESTION_MODE_3_Q4) ? 1U : 0U;
}

/* 这里只选择第五、六问专用的带球底盘参数，第四问球控单独接入。 */
static uint8_t MapRun_IsBallMode(void)
{
    return ((g_question_mode == MAP_QUESTION_MODE_4_Q5) ||
            (g_question_mode == MAP_QUESTION_MODE_5_Q6)) ? 1U : 0U;
}

static float MapRun_GetBallBaseSpeedRpm(void)
{
    unsigned long elapsed_ms;
    unsigned long ramp_elapsed_ms;
    float ramp_progress;
    float smooth_progress;

    if (g_map_state != MAP_RUN_STATE_RUNNING) {
        return MAP_RUN_BALL_BASE_SPEED_RPM;
    }

    elapsed_ms = tick_ms - g_run_start_ms;
    if (elapsed_ms < MAP_RUN_BALL_START_HOLD_MS) {
        return 0.0f;
    }

    ramp_elapsed_ms = elapsed_ms - MAP_RUN_BALL_START_HOLD_MS;
    if (ramp_elapsed_ms >= MAP_RUN_BALL_START_RAMP_MS) {
        return MAP_RUN_BALL_BASE_SPEED_RPM;
    }

    ramp_progress =
        (float) ramp_elapsed_ms / (float) MAP_RUN_BALL_START_RAMP_MS;
    smooth_progress =
        ramp_progress * ramp_progress *
        (3.0f - (2.0f * ramp_progress));
    return MAP_RUN_BALL_START_SPEED_RPM +
           (smooth_progress *
            (MAP_RUN_BALL_BASE_SPEED_RPM -
             MAP_RUN_BALL_START_SPEED_RPM));
}

/*
 * 第四问只规划底盘中心速度，不改变灰度和角速度串级的转向输出。
 * 先让滚球闭环稳定，再以当前底盘最低可用速度起步。三次平滑曲线
 * 在起点和终点的斜率均为 0，可减小轮速目标突变对钢球的冲击；
 * B 点前再提前降速，避免从巡航速度直接停车。
 */
static float MapRun_GetQ4BaseSpeedRpm(void)
{
    unsigned long elapsed_ms;
    unsigned long ramp_elapsed_ms;
    float planned_speed_rpm = MAP_RUN_Q4_BASE_SPEED_RPM;
    float ramp_progress;
    float smooth_progress;
    float brake_progress;
    float brake_speed_rpm;

    if (g_q4_final_stop_active != 0U) {
        elapsed_ms = tick_ms - g_q4_final_stop_start_ms;
        if (elapsed_ms >= MAP_RUN_Q4_FINAL_STOP_RAMP_MS) {
            return 0.0f;
        }

        ramp_progress =
            (float) elapsed_ms /
            (float) MAP_RUN_Q4_FINAL_STOP_RAMP_MS;
        smooth_progress =
            ramp_progress * ramp_progress *
            (3.0f - (2.0f * ramp_progress));
        return g_q4_final_stop_start_rpm *
               (1.0f - smooth_progress);
    }

    if (g_map_state != MAP_RUN_STATE_RUNNING) {
        return MAP_RUN_Q4_BASE_SPEED_RPM;
    }

    elapsed_ms = tick_ms - g_run_start_ms;
    if (elapsed_ms < MAP_RUN_Q4_START_HOLD_MS) {
        planned_speed_rpm = 0.0f;
    } else if (elapsed_ms <
               (MAP_RUN_Q4_START_HOLD_MS +
                MAP_RUN_Q4_START_RAMP_MS)) {
        ramp_elapsed_ms = elapsed_ms - MAP_RUN_Q4_START_HOLD_MS;
        ramp_progress =
            (float) ramp_elapsed_ms /
            (float) MAP_RUN_Q4_START_RAMP_MS;
        smooth_progress =
            ramp_progress * ramp_progress *
            (3.0f - (2.0f * ramp_progress));
        planned_speed_rpm =
            MAP_RUN_Q4_START_SPEED_RPM +
            (smooth_progress *
             (MAP_RUN_Q4_BASE_SPEED_RPM -
              MAP_RUN_Q4_START_SPEED_RPM));
    }

    if (g_run_distance_counts >= MAP_RUN_Q4_BRAKE_START_COUNTS) {
        if (g_run_distance_counts >= MAP_RUN_Q4_TARGET_STOP_COUNTS) {
            brake_speed_rpm = MAP_RUN_Q4_APPROACH_SPEED_RPM;
        } else {
            brake_progress =
                (float) (g_run_distance_counts -
                         MAP_RUN_Q4_BRAKE_START_COUNTS) /
                (float) (MAP_RUN_Q4_TARGET_STOP_COUNTS -
                         MAP_RUN_Q4_BRAKE_START_COUNTS);
            smooth_progress =
                brake_progress * brake_progress *
                (3.0f - (2.0f * brake_progress));
            brake_speed_rpm =
                MAP_RUN_Q4_BASE_SPEED_RPM -
                (smooth_progress *
                 (MAP_RUN_Q4_BASE_SPEED_RPM -
                  MAP_RUN_Q4_APPROACH_SPEED_RPM));
        }

        if (brake_speed_rpm < planned_speed_rpm) {
            planned_speed_rpm = brake_speed_rpm;
        }
    }

    return planned_speed_rpm;
}

static void MapRun_ResetQ4VelocityObserver(void)
{
    g_q4_fast_ball_speed_mm_s = 0.0f;
    g_q4_velocity_feedback_mm_s = 0.0f;
    g_q4_velocity_reference_x_mm = 0.0f;
    g_q4_velocity_reference_frame_id = 0UL;
    g_q4_velocity_reference_receive_ms = 0UL;
    g_q4_velocity_observer_valid = 0U;
}

/*
 * 通用滚球速度为抑制毫米量化噪声使用约三帧窗口，换向时会慢约一拍。
 * Q4 至 Q6 另外用 35 ms 短窗估速：忽略串口成组到达的过短间隔，但在
 * 检测到速度反号时立即采用新方向，避免阻尼继续沿旧方向给振荡补充能量。
 */
static void MapRun_UpdateQ4VelocityObserver(void)
{
    uint32_t frame_id;
    uint32_t receive_ms;
    uint32_t period_ms;
    float position_delta_mm;
    float raw_speed_mm_s;
    float slow_speed_mm_s;

    if (((MapRun_IsQ4Mode() == 0U) &&
         (MapRun_IsBallMode() == 0U)) ||
        (BallBeamController_IsEnabled(
             &g_ball_beam_controller) == 0U) ||
        (BallBeamController_IsControlReady(
             &g_ball_beam_controller) == 0U) ||
        (g_ball_beam_controller.dropout_active != 0U)) {
        MapRun_ResetQ4VelocityObserver();
        return;
    }

    frame_id = g_ball_beam_controller.camera_frame_id;
    receive_ms = g_ball_beam_controller.last_valid_receive_ms;
    slow_speed_mm_s = g_ball_beam_controller.ball_speed_mm_s;

    if (g_q4_velocity_observer_valid == 0U) {
        g_q4_velocity_reference_frame_id = frame_id;
        g_q4_velocity_reference_receive_ms = receive_ms;
        g_q4_velocity_reference_x_mm =
            g_ball_beam_controller.filtered_x_mm;
        g_q4_fast_ball_speed_mm_s = slow_speed_mm_s;
        g_q4_velocity_feedback_mm_s = slow_speed_mm_s;
        g_q4_velocity_observer_valid = 1U;
        return;
    }

    if (frame_id != g_q4_velocity_reference_frame_id) {
        period_ms = receive_ms - g_q4_velocity_reference_receive_ms;
        if (period_ms > MAP_RUN_Q4_VELOCITY_WINDOW_MAX_MS) {
            g_q4_velocity_reference_frame_id = frame_id;
            g_q4_velocity_reference_receive_ms = receive_ms;
            g_q4_velocity_reference_x_mm =
                g_ball_beam_controller.filtered_x_mm;
            g_q4_fast_ball_speed_mm_s = slow_speed_mm_s;
        } else if (period_ms >= MAP_RUN_Q4_VELOCITY_WINDOW_MIN_MS) {
            position_delta_mm =
                g_ball_beam_controller.filtered_x_mm -
                g_q4_velocity_reference_x_mm;
            if (MapRun_AbsFloat(position_delta_mm) <=
                MAP_RUN_Q4_VELOCITY_DELTA_DEADBAND_MM) {
                raw_speed_mm_s = 0.0f;
            } else {
                raw_speed_mm_s =
                    position_delta_mm *
                    (1000.0f / (float) period_ms);
            }

            if (raw_speed_mm_s > MAP_RUN_Q4_VELOCITY_MAX_MM_S) {
                raw_speed_mm_s = MAP_RUN_Q4_VELOCITY_MAX_MM_S;
            } else if (raw_speed_mm_s <
                       -MAP_RUN_Q4_VELOCITY_MAX_MM_S) {
                raw_speed_mm_s = -MAP_RUN_Q4_VELOCITY_MAX_MM_S;
            }

            if (((raw_speed_mm_s * g_q4_fast_ball_speed_mm_s) < 0.0f) &&
                (MapRun_AbsFloat(raw_speed_mm_s) >=
                 MAP_RUN_Q4_VELOCITY_REVERSAL_MIN_MM_S)) {
                g_q4_fast_ball_speed_mm_s = raw_speed_mm_s;
            } else {
                g_q4_fast_ball_speed_mm_s +=
                    MAP_RUN_Q4_VELOCITY_FILTER_ALPHA *
                    (raw_speed_mm_s - g_q4_fast_ball_speed_mm_s);
            }

            g_q4_velocity_reference_frame_id = frame_id;
            g_q4_velocity_reference_receive_ms = receive_ms;
            g_q4_velocity_reference_x_mm =
                g_ball_beam_controller.filtered_x_mm;
        }
    }

    if (((g_q4_fast_ball_speed_mm_s * slow_speed_mm_s) < 0.0f) &&
        (MapRun_AbsFloat(g_q4_fast_ball_speed_mm_s) >=
         MAP_RUN_Q4_VELOCITY_REVERSAL_MIN_MM_S)) {
        g_q4_velocity_feedback_mm_s = g_q4_fast_ball_speed_mm_s;
    } else {
        g_q4_velocity_feedback_mm_s =
            MAP_RUN_Q4_VELOCITY_FAST_BLEND *
                g_q4_fast_ball_speed_mm_s +
            (1.0f - MAP_RUN_Q4_VELOCITY_FAST_BLEND) *
                slow_speed_mm_s;
    }
}

/* 球已反向回中后及时撤掉正向停车前馈，负侧过深时也禁止继续向左推。 */
static float MapRun_ApplyQ4StopFeedforwardRelease(float feedforward_deg)
{
    float release_scale;

    if (BallBeamController_IsControlReady(
            &g_ball_beam_controller) == 0U) {
        return feedforward_deg;
    }
    if (g_ball_beam_controller.filtered_x_mm <
        MAP_RUN_Q4_STOP_FF_DISABLE_X_MM) {
        return 0.0f;
    }
    if (g_q4_velocity_feedback_mm_s >= 0.0f) {
        return feedforward_deg;
    }

    release_scale =
        1.0f +
        g_q4_velocity_feedback_mm_s /
            MAP_RUN_Q4_STOP_FF_RELEASE_SPEED_MM_S;
    if (release_scale <= 0.0f) {
        return 0.0f;
    }
    return feedforward_deg * release_scale;
}

/*
 * 实测小车向前加速时钢球向车后移动，并对应 X<0。摆杆负角会给钢球
 * 向 X 正方向的分力，因此起步使用负前馈；减速时方向相反。通过 B
 * 最后 35 RPM 到 0 使用独立 PWM 缓降，并叠加钟形正角；停车后短时保留
 * 接球正角，并在检测到小球反向回中后提前退出。所有前馈均不进入 PID 积分。
 */
static float MapRun_GetQ4AccelerationFeedforwardDeg(void)
{
    unsigned long elapsed_ms;
    unsigned long ramp_elapsed_ms;
    float progress;
    float normalized_acceleration;
    float terminal_preload;
    float feedforward_deg;
    float preload_scale;
    float release_scale;

    if (MapRun_IsQ4Mode() == 0U) {
        return 0.0f;
    }

    if (g_q4_stop_feedforward_active != 0U) {
        elapsed_ms = tick_ms - g_q4_stop_feedforward_start_ms;
        if (elapsed_ms < MAP_RUN_Q4_STOP_FF_HOLD_MS) {
            feedforward_deg = MAP_RUN_Q4_STOP_FF_DEG;
        } else if ((elapsed_ms - MAP_RUN_Q4_STOP_FF_HOLD_MS) <
                   MAP_RUN_Q4_STOP_FF_FADE_MS) {
            elapsed_ms -= MAP_RUN_Q4_STOP_FF_HOLD_MS;
            progress =
                (float) elapsed_ms /
                (float) MAP_RUN_Q4_STOP_FF_FADE_MS;
            normalized_acceleration =
                progress * progress * (3.0f - (2.0f * progress));
            feedforward_deg =
                MAP_RUN_Q4_STOP_FF_DEG *
                (1.0f - normalized_acceleration);
        } else {
            g_q4_stop_feedforward_active = 0U;
            return 0.0f;
        }

        return MapRun_ApplyQ4StopFeedforwardRelease(feedforward_deg);
    }

    /*
     * 停车保持阶段不再重新套用距离减速前馈。该前馈只用于抵消底盘
     * 减速度，车已停稳后继续保持正角会把钢球再次推向负侧。
     */
    if (g_q4_park_hold_active != 0U) {
        return 0.0f;
    }

    if (g_q4_final_stop_active != 0U) {
        elapsed_ms = tick_ms - g_q4_final_stop_start_ms;
        if (elapsed_ms >= MAP_RUN_Q4_FINAL_STOP_RAMP_MS) {
            return MapRun_ApplyQ4StopFeedforwardRelease(
                MAP_RUN_Q4_STOP_FF_DEG);
        }

        progress =
            (float) elapsed_ms /
            (float) MAP_RUN_Q4_FINAL_STOP_RAMP_MS;
        normalized_acceleration =
            4.0f * progress * (1.0f - progress);
        terminal_preload =
            progress * progress * (3.0f - (2.0f * progress));

        /*
         * 从距离减速阶段的 +0.70 度连续接管，再叠加钟形制动项，最终
         * 平滑落到停车保持角，避免终点触发瞬间出现前馈空档。
         */
        feedforward_deg =
            MAP_RUN_Q4_BRAKE_FF_PEAK_DEG *
                (1.0f - terminal_preload) +
            MAP_RUN_Q4_FINAL_STOP_FF_PEAK_DEG *
                normalized_acceleration +
            MAP_RUN_Q4_STOP_FF_DEG * terminal_preload;
        return MapRun_ApplyQ4StopFeedforwardRelease(feedforward_deg);
    }

    if (g_map_state != MAP_RUN_STATE_RUNNING) {
        return 0.0f;
    }

    elapsed_ms = tick_ms - g_run_start_ms;
    if (elapsed_ms < MAP_RUN_Q4_START_HOLD_MS) {
        if (elapsed_ms <=
            (MAP_RUN_Q4_START_HOLD_MS -
             MAP_RUN_Q4_START_PRELOAD_RAMP_MS)) {
            return 0.0f;
        }

        progress =
            (float) (elapsed_ms -
                     (MAP_RUN_Q4_START_HOLD_MS -
                      MAP_RUN_Q4_START_PRELOAD_RAMP_MS)) /
            (float) MAP_RUN_Q4_START_PRELOAD_RAMP_MS;
        normalized_acceleration =
            progress * progress * (3.0f - (2.0f * progress));
        return -MAP_RUN_Q4_START_PRELOAD_DEG *
               normalized_acceleration;
    }

    if ((elapsed_ms >= MAP_RUN_Q4_START_HOLD_MS) &&
        (elapsed_ms <
         (MAP_RUN_Q4_START_HOLD_MS + MAP_RUN_Q4_START_RAMP_MS))) {
        ramp_elapsed_ms = elapsed_ms - MAP_RUN_Q4_START_HOLD_MS;
        progress =
            (float) ramp_elapsed_ms /
            (float) MAP_RUN_Q4_START_RAMP_MS;
        normalized_acceleration =
            4.0f * progress * (1.0f - progress);
        feedforward_deg =
            -MAP_RUN_Q4_START_FF_PEAK_DEG *
            normalized_acceleration;

        preload_scale = 0.0f;
        if (ramp_elapsed_ms < MAP_RUN_Q4_START_PRELOAD_FADE_MS) {
            progress =
                (float) ramp_elapsed_ms /
                (float) MAP_RUN_Q4_START_PRELOAD_FADE_MS;
            normalized_acceleration =
                progress * progress * (3.0f - (2.0f * progress));
            preload_scale = 1.0f - normalized_acceleration;
        }
        feedforward_deg -=
            MAP_RUN_Q4_START_PRELOAD_DEG * preload_scale;

        /*
         * 球已回到中心附近并继续向 +X 运动时，保持负前馈会把它推过
         * 中心。先满足位置门槛，再按回中速度退出，避免仅由一帧速度
         * 尖峰在球仍位于负侧时过早撤掉起步补偿。
         */
        if ((BallBeamController_IsControlReady(
                  &g_ball_beam_controller) != 0U) &&
            (g_ball_beam_controller.filtered_x_mm >=
             MAP_RUN_Q4_START_FF_RELEASE_MIN_X_MM) &&
            (g_q4_velocity_feedback_mm_s > 0.0f)) {
            release_scale =
                1.0f -
                g_q4_velocity_feedback_mm_s /
                    MAP_RUN_Q4_START_FF_RELEASE_SPEED_MM_S;
            if (release_scale <= 0.0f) {
                return 0.0f;
            }
            if (release_scale < 1.0f) {
                feedforward_deg *= release_scale;
            }
        }
        return feedforward_deg;
    }

    if (g_run_distance_counts >= MAP_RUN_Q4_BRAKE_START_COUNTS) {
        if (g_run_distance_counts >= MAP_RUN_Q4_TARGET_STOP_COUNTS) {
            return MAP_RUN_Q4_BRAKE_FF_PEAK_DEG;
        }

        progress =
            (float) (g_run_distance_counts -
                     MAP_RUN_Q4_BRAKE_START_COUNTS) /
            (float) (MAP_RUN_Q4_TARGET_STOP_COUNTS -
                     MAP_RUN_Q4_BRAKE_START_COUNTS);
        normalized_acceleration =
            4.0f * progress * (1.0f - progress);

        /* 前半段沿原钟形曲线上升，达到峰值后保持到最终停车接管。 */
        if (progress >= 0.5f) {
            normalized_acceleration = 1.0f;
        }
        return MAP_RUN_Q4_BRAKE_FF_PEAK_DEG *
               normalized_acceleration;
    }

    return 0.0f;
}

/*
 * 第五、六问复用第四问已验证的启停补偿思路：起步前先建立负角预置，
 * S 曲线加速时叠加负向钟形前馈；终点 PWM 缓降时改用正向钟形前馈。
 * 这里仅补偿底盘纵向加减速，弯道差速仍由灰度和角速度串级负责。
 */
static float MapRun_GetBallLapAccelerationFeedforwardDeg(void)
{
    unsigned long elapsed_ms;
    unsigned long ramp_elapsed_ms;
    float progress;
    float normalized_acceleration;
    float preload_scale;
    float feedforward_deg;
    float release_scale;
    float relative_x_mm;

    if ((MapRun_IsBallMode() == 0U) ||
        (g_map_state != MAP_RUN_STATE_RUNNING)) {
        return 0.0f;
    }

    if (g_ball_lap_final_stop_active != 0U) {
        elapsed_ms = tick_ms - g_ball_lap_final_stop_start_ms;
        if (elapsed_ms >= MAP_RUN_BALL_FINAL_STOP_RAMP_MS) {
            return 0.0f;
        }

        progress =
            (float) elapsed_ms /
            (float) MAP_RUN_BALL_FINAL_STOP_RAMP_MS;
        normalized_acceleration =
            4.0f * progress * (1.0f - progress);
        return MAP_RUN_BALL_FINAL_STOP_FF_PEAK_DEG *
               normalized_acceleration;
    }

    elapsed_ms = tick_ms - g_run_start_ms;
    if (elapsed_ms < MAP_RUN_BALL_START_HOLD_MS) {
        if (elapsed_ms <=
            (MAP_RUN_BALL_START_HOLD_MS -
             MAP_RUN_BALL_START_PRELOAD_RAMP_MS)) {
            return 0.0f;
        }

        progress =
            (float) (elapsed_ms -
                     (MAP_RUN_BALL_START_HOLD_MS -
                      MAP_RUN_BALL_START_PRELOAD_RAMP_MS)) /
            (float) MAP_RUN_BALL_START_PRELOAD_RAMP_MS;
        normalized_acceleration =
            progress * progress * (3.0f - (2.0f * progress));
        return -MAP_RUN_BALL_START_PRELOAD_DEG *
               normalized_acceleration;
    }

    ramp_elapsed_ms = elapsed_ms - MAP_RUN_BALL_START_HOLD_MS;
    if (ramp_elapsed_ms >= MAP_RUN_BALL_START_RAMP_MS) {
        return 0.0f;
    }

    progress =
        (float) ramp_elapsed_ms /
        (float) MAP_RUN_BALL_START_RAMP_MS;
    normalized_acceleration =
        4.0f * progress * (1.0f - progress);
    feedforward_deg =
        -MAP_RUN_BALL_START_FF_PEAK_DEG *
        normalized_acceleration;

    preload_scale = 0.0f;
    if (ramp_elapsed_ms < MAP_RUN_BALL_START_PRELOAD_FADE_MS) {
        progress =
            (float) ramp_elapsed_ms /
            (float) MAP_RUN_BALL_START_PRELOAD_FADE_MS;
        normalized_acceleration =
            progress * progress * (3.0f - (2.0f * progress));
        preload_scale = 1.0f - normalized_acceleration;
    }
    feedforward_deg -=
        MAP_RUN_BALL_START_PRELOAD_DEG * preload_scale;

    /*
     * Q6 的目标可能不是 0，因此退出门槛必须使用相对目标误差。
     * 球已经回到目标附近并向 +X 运动时按速度撤掉负前馈，避免过冲。
     */
    relative_x_mm =
        g_ball_beam_controller.filtered_x_mm -
        g_ball_beam_controller.target_x_mm;
    if ((BallBeamController_IsControlReady(
              &g_ball_beam_controller) != 0U) &&
        (relative_x_mm >=
         MAP_RUN_BALL_START_FF_RELEASE_MIN_ERROR_MM) &&
        (g_ball_beam_controller.ball_speed_mm_s > 0.0f)) {
        release_scale =
            1.0f -
            g_ball_beam_controller.ball_speed_mm_s /
                MAP_RUN_BALL_START_FF_RELEASE_SPEED_MM_S;
        if (release_scale <= 0.0f) {
            return 0.0f;
        }
        if (release_scale < 1.0f) {
            feedforward_deg *= release_scale;
        }
    }

    return feedforward_deg;
}

/*
 * 第四至第六问的位置保护只在球静止、远离目标或回目标速度低于规划
 * 速度时介入；球已经快速回目标时逐步退出，让速度反馈提前反向制动，
 * 避免位置保护与制动项对打形成等幅振荡。
 */
static float MapRun_GetMovingBallPositionGuardDeg(void)
{
    float error_mm;
    float error_abs_mm;
    float ball_speed_mm_s;
    float toward_center_speed_mm_s;
    float planned_toward_speed_mm_s;
    float guard_scale = 1.0f;
    float guard_deg;

    if (((MapRun_IsQ4Mode() == 0U) &&
         (MapRun_IsBallMode() == 0U)) ||
        ((g_map_state != MAP_RUN_STATE_RUNNING) &&
         (g_q4_park_hold_active == 0U)) ||
        (BallBeamController_IsEnabled(
             &g_ball_beam_controller) == 0U) ||
        (BallBeamController_IsControlReady(
             &g_ball_beam_controller) == 0U)) {
        return 0.0f;
    }

    error_mm =
        g_ball_beam_controller.filtered_x_mm -
        g_ball_beam_controller.target_x_mm;
    error_abs_mm = MapRun_AbsFloat(error_mm);
    ball_speed_mm_s = g_q4_velocity_feedback_mm_s;
    if (error_abs_mm <= MAP_RUN_Q4_POSITION_GUARD_DEADBAND_MM) {
        return 0.0f;
    }

    /*
     * 停车后只在球已经超出题目允许的 +/-10 mm、且近似静止时补一段
     * 温和回中角。球一旦重新滚动便退出，避免位置项持续加速造成穿越
     * 中心后的二次过冲。
     */
    if (g_q4_park_hold_active != 0U) {
        if ((error_abs_mm <= MAP_RUN_Q4_PARK_GUARD_DEADBAND_MM) ||
            (MapRun_AbsFloat(ball_speed_mm_s) >
             MAP_RUN_Q4_PARK_GUARD_MAX_SPEED_MM_S)) {
            return 0.0f;
        }

        guard_deg =
            (error_abs_mm - MAP_RUN_Q4_PARK_GUARD_DEADBAND_MM) *
            MAP_RUN_Q4_PARK_GUARD_GAIN_DEG_PER_MM;
        if (guard_deg > MAP_RUN_Q4_PARK_GUARD_MAX_DEG) {
            guard_deg = MAP_RUN_Q4_PARK_GUARD_MAX_DEG;
        }
        return (error_mm < 0.0f) ? -guard_deg : guard_deg;
    }

    toward_center_speed_mm_s =
        (error_mm > 0.0f) ?
            -ball_speed_mm_s : ball_speed_mm_s;
    planned_toward_speed_mm_s = MapRun_AbsFloat(
        g_ball_beam_controller.profile_target_speed_mm_s);

    if (toward_center_speed_mm_s > 0.0f) {
        if ((planned_toward_speed_mm_s < 0.1f) ||
            (toward_center_speed_mm_s >= planned_toward_speed_mm_s)) {
            return 0.0f;
        }

        guard_scale =
            1.0f -
            toward_center_speed_mm_s / planned_toward_speed_mm_s;
    }

    guard_deg =
        (error_abs_mm - MAP_RUN_Q4_POSITION_GUARD_DEADBAND_MM) *
        MAP_RUN_Q4_POSITION_GUARD_GAIN_DEG_PER_MM *
        guard_scale;
    if (guard_deg > MAP_RUN_Q4_POSITION_GUARD_MAX_DEG) {
        guard_deg = MAP_RUN_Q4_POSITION_GUARD_MAX_DEG;
    }

    return (error_mm < 0.0f) ? -guard_deg : guard_deg;
}

/* Q4 至 Q6 使用短窗反馈增加速度阻尼，方向始终与小球速度相反。 */
static float MapRun_GetQ4VelocityDampingDeg(void)
{
    float damping_deg;

    if (((MapRun_IsQ4Mode() == 0U) &&
         (MapRun_IsBallMode() == 0U)) ||
        (BallBeamController_IsEnabled(
             &g_ball_beam_controller) == 0U) ||
        (BallBeamController_IsControlReady(
             &g_ball_beam_controller) == 0U)) {
        return 0.0f;
    }

    damping_deg =
        g_q4_velocity_feedback_mm_s *
        MAP_RUN_Q4_VELOCITY_DAMPING_GAIN;
    if (damping_deg > MAP_RUN_Q4_VELOCITY_DAMPING_MAX_DEG) {
        return MAP_RUN_Q4_VELOCITY_DAMPING_MAX_DEG;
    }
    if (damping_deg < -MAP_RUN_Q4_VELOCITY_DAMPING_MAX_DEG) {
        return -MAP_RUN_Q4_VELOCITY_DAMPING_MAX_DEG;
    }
    return damping_deg;
}

static void MapRun_UpdateMovingBallFeedforward(void)
{
    float external_feedforward_deg;
    float external_feedforward_limit_deg =
        MAP_RUN_Q4_EXTERNAL_FF_MAX_DEG;

    if ((tick_ms - g_q4_feedforward_update_ms) <
        MAP_RUN_CONTROL_PERIOD_MS) {
        return;
    }

    g_q4_feedforward_update_ms = tick_ms;
    MapRun_UpdateQ4VelocityObserver();
    if (MapRun_IsQ4Mode() != 0U) {
        g_q4_acceleration_feedforward_deg =
            MapRun_GetQ4AccelerationFeedforwardDeg();
    } else if (MapRun_IsBallMode() != 0U) {
        g_q4_acceleration_feedforward_deg =
            MapRun_GetBallLapAccelerationFeedforwardDeg();
    } else {
        g_q4_acceleration_feedforward_deg = 0.0f;
    }
    g_q4_position_guard_deg =
        MapRun_GetMovingBallPositionGuardDeg();
    g_q4_velocity_damping_deg =
        MapRun_GetQ4VelocityDampingDeg();
    external_feedforward_deg =
        g_q4_acceleration_feedforward_deg +
        g_q4_position_guard_deg +
        g_q4_velocity_damping_deg;
    /*
     * Q5/Q6 的 85 RPM 起步加速度高于 Q4，原共用的 1.5 度限幅会把
     * 预置角与钟形前馈同时截断。仅在起步阶段放宽限幅，巡航和停车
     * 继续使用 1.5 度，避免位置保护在正常行驶时过强。
     */
    if ((MapRun_IsBallMode() != 0U) &&
        (g_map_state == MAP_RUN_STATE_RUNNING) &&
        (g_ball_lap_final_stop_active == 0U) &&
        ((tick_ms - g_run_start_ms) <
         (MAP_RUN_BALL_START_HOLD_MS +
          MAP_RUN_BALL_START_RAMP_MS))) {
        external_feedforward_limit_deg =
            MAP_RUN_BALL_START_EXTERNAL_FF_MAX_DEG;
    }

    if (external_feedforward_deg > external_feedforward_limit_deg) {
        external_feedforward_deg = external_feedforward_limit_deg;
    } else if (external_feedforward_deg <
               -external_feedforward_limit_deg) {
        external_feedforward_deg = -external_feedforward_limit_deg;
    }
    (void) BallBeamController_SetExternalFeedforwardDeg(
        &g_ball_beam_controller,
        external_feedforward_deg);
}

static const char *MapRun_GetQ4SpeedPhaseText(void)
{
    if (g_q4_final_stop_active != 0U) {
        return "STOPPING";
    }
    if (g_map_state != MAP_RUN_STATE_RUNNING) {
        return "IDLE";
    }
    if ((tick_ms - g_run_start_ms) < MAP_RUN_Q4_START_HOLD_MS) {
        return "HOLD";
    }
    if ((tick_ms - g_run_start_ms) <
        (MAP_RUN_Q4_START_HOLD_MS + MAP_RUN_Q4_START_RAMP_MS)) {
        return "START";
    }
    if (g_run_distance_counts < MAP_RUN_Q4_BRAKE_START_COUNTS) {
        return "CRUISE";
    }
    return "BRAKE";
}

static float MapRun_GetCenterRecoveryRpmPerStep(void)
{
    if (MapRun_IsBallMode() != 0U) {
        return MAP_RUN_BALL_CENTER_RECOVERY_RPM_PER_STEP;
    }

    return MAP_RUN_CENTER_RECOVERY_RPM_PER_STEP;
}

static float MapRun_GetQuestionBaseSpeedRpm(void)
{
    switch (g_question_mode) {
        case MAP_QUESTION_MODE_1_Q2:
            return MAP_RUN_Q2_BASE_SPEED_RPM;

        case MAP_QUESTION_MODE_2_Q3:
            return 0.0f;

        case MAP_QUESTION_MODE_3_Q4:
            return MapRun_GetQ4BaseSpeedRpm();

        case MAP_QUESTION_MODE_4_Q5:
        case MAP_QUESTION_MODE_5_Q6:
            return MapRun_GetBallBaseSpeedRpm();

        default:
            return MAP_RUN_Q2_BASE_SPEED_RPM;
    }
}

static void MapRun_ResetYawCascade(void)
{
    MapYawRateController_Reset(&g_yaw_rate_controller);
    MapCurveHold_Reset(&g_curve_hold);
    g_center_speed_rpm = MapRun_GetQuestionBaseSpeedRpm();
    g_base_speed_rpm = g_center_speed_rpm;
    g_target_yaw_rate_deg_s = 0.0f;
    g_measured_yaw_rate_deg_s = 0.0f;
    g_yaw_turn_rpm = 0.0f;
    g_yaw_cascade_active = 0U;
    g_finish_heading_error_deg = 0.0f;
    g_finish_heading_rate_offset_deg_s = 0.0f;
    g_finish_heading_active = 0U;
}

/*
 * 地图应用内置精简蓝牙测速与速度环测试命令，不接入旧状态机。
 * VOFA FireWater 通道顺序：目标左、目标右、实测左、实测右。
 */
static uint8_t MapRun_SendTelemetryByte(uint8_t data)
{
    uint32_t wait_count = 0UL;

    while (DL_UART_Main_isTXFIFOFull(UART_0_INST)) {
        wait_count++;
        if (wait_count >= MAP_RUN_TELEMETRY_TX_WAIT_LIMIT) {
            return 0U;
        }
    }

    DL_UART_Main_transmitData(UART_0_INST, data);
    return 1U;
}

static void MapRun_SendBluetoothText(const char *text)
{
    if (text == NULL) {
        return;
    }

    while (*text != '\0') {
        if (MapRun_SendTelemetryByte((uint8_t) *text) == 0U) {
            return;
        }
        text++;
    }
}

static uint8_t MapRun_GetQuestionNumber(void)
{
    return (uint8_t) g_question_mode + 1U;
}

static uint8_t MapRun_IsQuestionModeReady(void)
{
    return ((g_question_mode == MAP_QUESTION_MODE_1_Q2) ||
            (g_question_mode == MAP_QUESTION_MODE_2_Q3) ||
            (g_question_mode == MAP_QUESTION_MODE_3_Q4) ||
            (g_question_mode == MAP_QUESTION_MODE_4_Q5) ||
            (g_question_mode == MAP_QUESTION_MODE_5_Q6)) ? 1U : 0U;
}

static void MapRun_SendQuestionModeStatus(void)
{
    char response[64];

    (void) snprintf(
        response,
        sizeof(response),
        "[MODE] M%u Q%u %s\r\n",
        (unsigned int) g_question_mode,
        (unsigned int) MapRun_GetQuestionNumber(),
        (MapRun_IsQuestionModeReady() != 0U) ? "READY" : "NOT READY");
    MapRun_SendBluetoothText(response);

    if (g_question_mode == MAP_QUESTION_MODE_5_Q6) {
        MapRun_SendBluetoothText(
            "[MODE] Q6: B21 captures current X and starts\r\n");
    }
}

static void MapRun_ChangeQuestionMode(int8_t direction)
{
    uint8_t next_mode = (uint8_t) g_question_mode;

    /*
     * 第三问完成后会保持终点自适应停球姿态。离开该模式时统一关闭
     * 滚球控制和位置跟踪，避免切换题目后步进机构仍在后台动作。
     */
    MapRun_DisableBallBeam();

    if (direction < 0) {
        next_mode = (next_mode <= (uint8_t) MAP_QUESTION_MODE_1_Q2) ?
            (uint8_t) MAP_QUESTION_MODE_5_Q6 : (next_mode - 1U);
    } else {
        next_mode = (next_mode >= (uint8_t) MAP_QUESTION_MODE_5_Q6) ?
            (uint8_t) MAP_QUESTION_MODE_1_Q2 : (next_mode + 1U);
    }

    g_question_mode = (MapQuestionMode) next_mode;
    g_control_mode = MAP_CONTROL_LINE_FOLLOW;
    g_map_state = MAP_RUN_STATE_READY;
    g_finish_reason = MAP_FINISH_NONE;
    g_run_elapsed_ms = 0UL;
    g_run_distance_counts = 0U;
    g_q4_right_second_seen = 0U;
    g_q4_ball_limit_exceeded = 0U;
    g_q4_max_ball_error_mm = 0.0f;
    g_q4_acceleration_feedforward_deg = 0.0f;
    g_q4_position_guard_deg = 0.0f;
    g_q4_velocity_damping_deg = 0.0f;
    MapRun_ResetQ4VelocityObserver();
    g_q4_feedforward_update_ms = tick_ms;
    g_q4_stop_feedforward_start_ms = tick_ms;
    g_q4_stop_feedforward_active = 0U;
    g_q4_final_stop_start_ms = tick_ms;
    g_q4_final_stop_active = 0U;
    g_q4_park_hold_active = 0U;
    g_q4_final_stop_start_rpm = 0.0f;
    g_q4_final_stop_left_duty_percent = 0.0f;
    g_q4_final_stop_right_duty_percent = 0.0f;
    g_ball_lap_final_stop_start_ms = tick_ms;
    g_ball_lap_final_stop_active = 0U;
    g_ball_lap_final_stop_start_rpm = 0.0f;
    g_ball_lap_final_stop_left_duty_percent = 0.0f;
    g_ball_lap_final_stop_right_duty_percent = 0.0f;
    g_q4_camera_fallback_active = 0U;
    g_ball_lap_camera_fallback_active = 0U;
    g_ball_lap_limit_exceeded = 0U;
    g_ball_lap_completed_within_time = 0U;
    g_ball_lap_active_target_mm =
        (g_question_mode == MAP_QUESTION_MODE_5_Q6) ?
            g_q6_target_position_mm : 0.0f;
    g_ball_lap_max_error_mm = 0.0f;
    g_q3_state = MAP_Q3_STATE_IDLE;
    g_q3_completed_within_time = 0U;
    g_q3_time_warning_sent = 0U;
    g_q3_hold_entry_seed_pending = 0U;
    MapRun_ResetQ3StictionAssist();
    g_q3_phase_start_ms = (uint32_t) tick_ms;
    g_finish_heading_reference_valid = 0U;
    MapRun_ResetBallLapTurnTracking(0U);
    MapRun_ResetYawCascade();
    g_last_display_ms = tick_ms - MAP_RUN_DISPLAY_PERIOD_MS;
    MapRun_SendQuestionModeStatus();
}

static void MapRun_SendSpeedTelemetry(void)
{
    char frame[64];
    int frame_length;
    int index;

    frame_length = snprintf(
        frame,
        sizeof(frame),
        "speed:%.1f,%.1f,%.1f,%.1f\n",
        MotorSpeedLoop_GetLeftWheelTargetRPM(),
        MotorSpeedLoop_GetRightWheelTargetRPM(),
        MotorSpeed_GetLeftWheelRPM(),
        MotorSpeed_GetRightWheelRPM());

    if (frame_length <= 0) {
        return;
    }

    if (frame_length >= (int) sizeof(frame)) {
        frame_length = (int) sizeof(frame) - 1;
    }

    for (index = 0; index < frame_length; index++) {
        if (MapRun_SendTelemetryByte((uint8_t) frame[index]) == 0U) {
            return;
        }
    }
}

/*
 * UART 中断只接收字节并写入环形缓冲，命令解析留在主循环，
 * 避免在中断里执行浮点解析、格式化或电机控制。
 */
void UART_0_INST_IRQHandler(void)
{
    while (DL_UART_isRXFIFOEmpty(UART_0_INST) == false) {
        uint8_t data = DL_UART_receiveData(UART_0_INST);
        uint16_t next_index =
            (uint16_t) ((g_uart_rx_write_index + 1U) %
                        MAP_RUN_UART_RX_BUFFER_SIZE);

        if (next_index == g_uart_rx_read_index) {
            g_uart_rx_overflow = 1U;
        } else {
            g_uart_rx_buffer[g_uart_rx_write_index] = data;
            g_uart_rx_write_index = next_index;
        }
    }
}

static float MapRun_AbsFloat(float value)
{
    return (value < 0.0f) ? (-value) : value;
}

static void MapRun_ResetQ3MotionWindow(void)
{
    g_q3_window_start_ms = (uint32_t) tick_ms;
    g_q3_window_start_x_mm =
        g_ball_beam_controller.filtered_x_mm;
    g_q3_window_min_x_mm = g_q3_window_start_x_mm;
    g_q3_window_max_x_mm = g_q3_window_start_x_mm;
}

static uint8_t MapRun_IsQ3MotionWindowStable(
    uint32_t required_ms,
    float maximum_delta_mm)
{
    float position_span_mm;

    if (g_ball_beam_controller.filtered_x_mm <
        g_q3_window_min_x_mm) {
        g_q3_window_min_x_mm =
            g_ball_beam_controller.filtered_x_mm;
    }
    if (g_ball_beam_controller.filtered_x_mm >
        g_q3_window_max_x_mm) {
        g_q3_window_max_x_mm =
            g_ball_beam_controller.filtered_x_mm;
    }

    /* 使用窗口内最大摆幅，避免小球往返后恰好回到起点而被误判停稳。 */
    position_span_mm =
        g_q3_window_max_x_mm - g_q3_window_min_x_mm;

    if (position_span_mm > maximum_delta_mm) {
        MapRun_ResetQ3MotionWindow();
        return 0U;
    }

    return (((uint32_t) tick_ms - g_q3_window_start_ms) >=
            required_ms) ? 1U : 0U;
}

static void MapRun_RestoreQ3PIDGains(void)
{
    if (g_q3_saved_pid_valid == 0U) {
        return;
    }

    (void) BallBeamController_SetPIDGains(
        &g_ball_beam_controller,
        g_q3_saved_kp,
        g_q3_saved_ki,
        g_q3_saved_kd);
}

static float MapRun_ClampFloat(float value,
                               float minimum,
                               float maximum)
{
    if (value < minimum) {
        return minimum;
    }
    if (value > maximum) {
        return maximum;
    }
    return value;
}

static float MapRun_NormalizeAngleDelta(float delta_deg)
{
    while (delta_deg > 180.0f) {
        delta_deg -= 360.0f;
    }
    while (delta_deg < -180.0f) {
        delta_deg += 360.0f;
    }
    return delta_deg;
}

static void MapRun_ResetBallLapTurnTracking(uint8_t seed_current_yaw)
{
    g_ball_lap_right_turn_deg = 0.0f;
    g_ball_lap_previous_yaw_deg = yaw;
    g_ball_lap_yaw_valid = seed_current_yaw;
}

static void MapRun_AddBallLapYawSample(float current_yaw_deg)
{
    float yaw_delta_deg;

    if ((MapRun_IsBallMode() == 0U) ||
        (g_map_state != MAP_RUN_STATE_RUNNING)) {
        return;
    }

    if (g_ball_lap_yaw_valid == 0U) {
        g_ball_lap_previous_yaw_deg = current_yaw_deg;
        g_ball_lap_yaw_valid = 1U;
        return;
    }

    yaw_delta_deg = MapRun_NormalizeAngleDelta(
        current_yaw_deg - g_ball_lap_previous_yaw_deg);
    g_ball_lap_previous_yaw_deg = current_yaw_deg;

    /* BNO085 复位或异常跳变不能被误算成整圈转角。 */
    if (MapRun_AbsFloat(yaw_delta_deg) >
        MAP_RUN_BALL_YAW_MAX_SAMPLE_DELTA_DEG) {
        return;
    }

    /*
     * 停车只需要确认车身确实完成过一圈转向，不依赖 BNO085 的安装
     * 方向。累计相邻样本的绝对转角可避免顺时针符号相反时一直为 0。
     */
    g_ball_lap_right_turn_deg += MapRun_AbsFloat(yaw_delta_deg);
    g_ball_lap_right_turn_deg = MapRun_ClampFloat(
        g_ball_lap_right_turn_deg,
        0.0f,
        720.0f);
}

static void MapRun_UpdateFinishHeadingAssist(uint8_t yaw_rate_fresh)
{
    g_finish_heading_active = 0U;
    g_finish_heading_error_deg = 0.0f;
    g_finish_heading_rate_offset_deg_s = 0.0f;

    if ((g_question_mode != MAP_QUESTION_MODE_1_Q2) ||
        (g_map_state != MAP_RUN_STATE_RUNNING) ||
        (g_start_line_left == 0U) ||
        (g_run_distance_counts < MAP_RUN_FINISH_HEADING_ARM_COUNTS) ||
        (g_finish_heading_reference_valid == 0U) ||
        (yaw_rate_fresh == 0U)) {
        return;
    }

    /* 左转为正：目标航向减当前航向为正时，应给正的目标角速度。 */
    g_finish_heading_error_deg =
        MapRun_NormalizeAngleDelta(
            g_finish_heading_reference_yaw_deg - yaw);
    g_finish_heading_rate_offset_deg_s =
        MapRun_ClampFloat(
            MAP_RUN_FINISH_HEADING_KP_RATE_PER_DEG *
                g_finish_heading_error_deg,
            -MAP_RUN_FINISH_HEADING_RATE_LIMIT_DEG_S,
            MAP_RUN_FINISH_HEADING_RATE_LIMIT_DEG_S);
    g_finish_heading_active = 1U;
}

static float MapRun_CalculateQ3CatchAngleDeg(float speed_mm_s)
{
    float deceleration_m_s2;
    float damping_angle_deg;
    float catch_angle_deg;

    speed_mm_s = MapRun_ClampFloat(
        speed_mm_s,
        -MAP_RUN_Q3_CATCH_MAX_SPEED_MM_S,
        MAP_RUN_Q3_CATCH_MAX_SPEED_MM_S);

    /*
     * 使用固定 70 mm 制动距离计算速度能量，而不是用“距离 -5 cm
     * 还有多远”作分母。这样接近目标或穿过管道坡度奇异点时，角度不会
     * 因分母趋近于零而突变。+1.8 度是负端局部坡度的初始平衡估计，
     * 速度向左时减小角度反刹，速度反向后增大角度吸收回弹能量。
     */
    deceleration_m_s2 =
        (MapRun_AbsFloat(speed_mm_s) *
         MapRun_AbsFloat(speed_mm_s)) /
        (2.0f * MAP_RUN_Q3_BRAKE_DISTANCE_MM * 1000.0f);
    damping_angle_deg =
        deceleration_m_s2 /
        MAP_RUN_Q3_ROLL_ACCEL_M_S2_PER_RAD *
        MAP_RUN_Q3_RAD_TO_DEG *
        MAP_RUN_Q3_BRAKE_MODEL_GAIN;

    if (speed_mm_s < 0.0f) {
        catch_angle_deg =
            MAP_RUN_Q3_CATCH_BALANCE_BIAS_DEG -
            damping_angle_deg;
    } else if (speed_mm_s > 0.0f) {
        catch_angle_deg =
            MAP_RUN_Q3_CATCH_BALANCE_BIAS_DEG +
            damping_angle_deg;
    } else {
        catch_angle_deg =
            MAP_RUN_Q3_CATCH_BALANCE_BIAS_DEG;
    }

    return MapRun_ClampFloat(
        catch_angle_deg,
        -MAP_RUN_Q3_BRAKE_MAX_ANGLE_DEG,
        MAP_RUN_Q3_BRAKE_MAX_ANGLE_DEG);
}

static float MapRun_CalculateQ3BrakeMagnitudeDeg(float speed_mm_s)
{
    float deceleration_m_s2;
    float brake_angle_deg;

    /*
     * 恢复曾实测在 4.45 s 内完成的一组柔和制动模型。用当前左移速度
     * 加 40 mm/s 余量估计换坡期间继续积累的动量，再按 70 mm 距离
     * 计算制动角。角度只允许 1.5~3.0 度，避免提前制动时直接给满
     * -4.5 度，把球在到达 -5 cm 前推回去。
     */
    speed_mm_s = MapRun_ClampFloat(
        MapRun_AbsFloat(speed_mm_s) +
            MAP_RUN_Q3_BRAKE_SPEED_MARGIN_MM_S,
        0.0f,
        MAP_RUN_Q3_CATCH_MAX_SPEED_MM_S);
    deceleration_m_s2 =
        (speed_mm_s * speed_mm_s) /
        (2.0f * MAP_RUN_Q3_BRAKE_DISTANCE_MM * 1000.0f);
    brake_angle_deg =
        deceleration_m_s2 /
        MAP_RUN_Q3_ROLL_ACCEL_M_S2_PER_RAD *
        MAP_RUN_Q3_RAD_TO_DEG *
        MAP_RUN_Q3_BRAKE_MODEL_GAIN;

    return MapRun_ClampFloat(
        brake_angle_deg,
        MAP_RUN_Q3_BRAKE_MIN_ANGLE_DEG,
        MAP_RUN_Q3_BRAKE_MAX_ANGLE_DEG);
}

static float MapRun_UpdateQ3FreshSpeedMmS(void)
{
    uint32_t now_ms = (uint32_t) tick_ms;
    uint32_t frame_period_ms = now_ms - g_q3_motion_last_ms;
    float current_x_mm = g_ball_beam_controller.raw_x_mm;
    float frame_delta_mm = current_x_mm - g_q3_motion_last_x_mm;
    float speed_mm_s = g_ball_beam_controller.ball_speed_mm_s;

    /*
     * 通用球速跨多帧滤波，折返时方向变化会晚一拍。第三题额外按相邻
     * 有效帧计算即时速度，并与通用球速融合；坐标量化未变化时按 0 速
     * 处理，避免旧的高速值让制动持续过久。
     */
    if ((frame_period_ms > 0UL) &&
        (frame_period_ms <= MAP_RUN_Q3_STALE_TIMEOUT_MS)) {
        float frame_speed_mm_s = 0.0f;

        if (MapRun_AbsFloat(frame_delta_mm) >=
            MAP_RUN_Q3_CATCH_FRAME_DELTA_MIN_MM) {
            frame_speed_mm_s = MapRun_ClampFloat(
                frame_delta_mm * (1000.0f / (float) frame_period_ms),
                -MAP_RUN_Q3_CATCH_MAX_SPEED_MM_S,
                MAP_RUN_Q3_CATCH_MAX_SPEED_MM_S);
        }

        speed_mm_s =
            (1.0f - MAP_RUN_Q3_CATCH_FRAME_SPEED_BLEND) *
                speed_mm_s +
            MAP_RUN_Q3_CATCH_FRAME_SPEED_BLEND *
                frame_speed_mm_s;
    }

    g_q3_motion_last_ms = now_ms;
    g_q3_motion_last_x_mm = current_x_mm;
    return MapRun_ClampFloat(
        speed_mm_s,
        -MAP_RUN_Q3_CATCH_MAX_SPEED_MM_S,
        MAP_RUN_Q3_CATCH_MAX_SPEED_MM_S);
}

static void MapRun_SetQ3ManualBeamAngle(float beam_angle_deg)
{
    g_q3_manual_beam_active = 1U;
    g_q3_manual_beam_angle_deg = beam_angle_deg;
    BallBeamController_SetEnabled(&g_ball_beam_controller, 0U);

    if ((g_ball_stepper_zeroed != 0U) &&
        (StepperMotor_IsPositionTrackingEnabled() != 0U)) {
        (void) StepperMotor_SetTargetPositionPulses(
            BallBeamController_ConvertBeamAngleToPulses(
                &g_ball_beam_controller,
                beam_angle_deg));
    }
}

static float MapRun_GetQ3HoldProfileTargetSpeedMmS(
    float position_error_mm)
{
    float target_speed_abs_mm_s =
        MAP_RUN_Q3_HOLD_PROFILE_POSITION_RATE_PER_S *
        MapRun_AbsFloat(position_error_mm);

    if (target_speed_abs_mm_s >
        MAP_RUN_Q3_HOLD_PROFILE_MAX_SPEED_MM_S) {
        target_speed_abs_mm_s =
            MAP_RUN_Q3_HOLD_PROFILE_MAX_SPEED_MM_S;
    }

    /* 目标速度始终指向 -50 mm，接近终点时按距离自动降到 0。 */
    if (position_error_mm > 0.0f) {
        return -target_speed_abs_mm_s;
    }
    if (position_error_mm < 0.0f) {
        return target_speed_abs_mm_s;
    }
    return 0.0f;
}

static float MapRun_GetQ3CaptureTargetSpeedMmS(float current_x_mm)
{
    float position_error_mm =
        current_x_mm - MAP_RUN_Q3_NEGATIVE_HOLD_MM;

    /* 位置 P 只负责规划速度，接近 -50 mm 时预期速度自然降到 0。 */
    return MapRun_ClampFloat(
        -MAP_RUN_Q3_CAPTURE_POSITION_RATE_PER_S * position_error_mm,
        -MAP_RUN_Q3_CAPTURE_MAX_EXPECTED_SPEED_MM_S,
        MAP_RUN_Q3_CAPTURE_MAX_EXPECTED_SPEED_MM_S);
}

static float MapRun_CalculateQ3CapturePDAngleDeg(void)
{
    float target_speed_mm_s =
        MapRun_GetQ3CaptureTargetSpeedMmS(
            g_ball_beam_controller.raw_x_mm);
    float speed_error_mm_s =
        g_q3_fresh_speed_mm_s - target_speed_mm_s;
    float speed_correction_deg = MapRun_ClampFloat(
        MAP_RUN_Q3_CAPTURE_SPEED_KD_DEG_PER_MM_S *
            speed_error_mm_s,
        -MAP_RUN_Q3_CAPTURE_MAX_CORRECTION_DEG,
        MAP_RUN_Q3_CAPTURE_MAX_CORRECTION_DEG);

    /*
     * 正角驱动小球向负方向。实际速度比预期更负时减小角度进行反刹；
     * 实际速度不足时增大角度继续送球。捕获段不使用积分，避免积累后
     * 在 -50 mm 附近再次把球推出去。
     */
    g_q3_hold_profile_target_speed_mm_s = target_speed_mm_s;
    g_q3_hold_feedback_speed_mm_s = g_q3_fresh_speed_mm_s;
    g_q3_hold_profile_blend = 1.0f;
    return MapRun_ClampFloat(
        MAP_RUN_Q3_CATCH_BALANCE_BIAS_DEG + speed_correction_deg,
        MAP_RUN_Q3_CATCH_BALANCE_BIAS_DEG -
            MAP_RUN_Q3_CAPTURE_MAX_CORRECTION_DEG,
        MAP_RUN_Q3_CATCH_BALANCE_BIAS_DEG +
            MAP_RUN_Q3_CAPTURE_MAX_CORRECTION_DEG);
}

static float MapRun_GetQ3PositivePeakEstimateMm(void)
{
    float positive_speed_mm_s = MapRun_ClampFloat(
        g_ball_beam_controller.ball_speed_mm_s,
        0.0f,
        MAP_RUN_Q3_POSITIVE_PREDICTION_MAX_SPEED_MM_S);

    /*
     * 固定位置切换无法兼容每次不同的起滚速度。用平滑球速向前预测
     * 0.85 秒：覆盖摄像头帧间隔和步进换向滞后，低速时允许继续加速，
     * 高速时提前换坡，目标是让真实峰值
     * 落入 +40~+60 mm，而不是再次冲到 +100 mm 之外。
     */
    return g_ball_beam_controller.raw_x_mm +
           MAP_RUN_Q3_POSITIVE_PREDICTION_S * positive_speed_mm_s;
}

static float MapRun_GetQ3HoldProfileBlend(float position_error_mm)
{
    return MapRun_ClampFloat(
        (MapRun_AbsFloat(position_error_mm) -
         MAP_RUN_Q3_HOLD_PROFILE_BLEND_START_MM) /
            (MAP_RUN_Q3_HOLD_PROFILE_BLEND_FULL_MM -
             MAP_RUN_Q3_HOLD_PROFILE_BLEND_START_MM),
        0.0f,
        1.0f);
}

static void MapRun_ResetQ3StictionAssist(void)
{
    g_q3_hold_stiction_candidate_active = 0U;
    g_q3_hold_stiction_kick_active = 0U;
    g_q3_hold_stiction_candidate_start_ms = (uint32_t) tick_ms;
    g_q3_hold_stiction_kick_start_ms = (uint32_t) tick_ms;
    g_q3_hold_stiction_rearm_start_ms =
        (uint32_t) tick_ms - MAP_RUN_Q3_HOLD_STICTION_REARM_MS;
    g_q3_hold_stiction_candidate_x_mm =
        g_ball_beam_controller.filtered_x_mm;
    g_q3_hold_stiction_kick_deg = 0.0f;
    g_q3_hold_stiction_position_deg = 0.0f;
}

static void MapRun_UpdateQ3StictionAssist(
    float position_error_mm,
    float speed_feedback_mm_s)
{
    uint32_t now_ms = (uint32_t) tick_ms;
    uint8_t stiction_candidate;

    g_q3_hold_stiction_position_deg = 0.0f;

    /*
     * 4.5 度只用于确认后的短促破静摩擦。旧逻辑仅凭单帧没有位移就
     * 立即触发，摄像头 1 mm 量化会把仍在缓慢移动的小球误判为卡住，
     * 反复强推后形成大幅往返。动作出现位移、速度恢复或达到 100 ms
     * 都立即退出，并留出重触发冷却时间。
     */
    if (g_q3_hold_stiction_kick_active != 0U) {
        if ((MapRun_AbsFloat(g_q3_hold_frame_delta_mm) >
             MAP_RUN_Q3_HOLD_STICTION_FRAME_DELTA_MAX_MM) ||
            (MapRun_AbsFloat(speed_feedback_mm_s) >=
             MAP_RUN_Q3_HOLD_STICTION_RELEASE_SPEED_MM_S) ||
            ((now_ms - g_q3_hold_stiction_kick_start_ms) >=
             MAP_RUN_Q3_HOLD_STICTION_KICK_MS)) {
            g_q3_hold_stiction_kick_active = 0U;
            g_q3_hold_stiction_rearm_start_ms = now_ms;
            g_q3_hold_stiction_kick_deg = 0.0f;
        } else {
            g_q3_hold_stiction_position_deg =
                g_q3_hold_stiction_kick_deg;
            return;
        }
    }

    if ((now_ms - g_q3_hold_stiction_rearm_start_ms) <
        MAP_RUN_Q3_HOLD_STICTION_REARM_MS) {
        g_q3_hold_stiction_candidate_active = 0U;
        return;
    }

    stiction_candidate =
        ((MapRun_AbsFloat(position_error_mm) >=
          MAP_RUN_Q3_HOLD_STICTION_ERROR_MIN_MM) &&
         (MapRun_AbsFloat(speed_feedback_mm_s) <=
          MAP_RUN_Q3_HOLD_STICTION_SPEED_MAX_MM_S) &&
         (MapRun_AbsFloat(g_q3_hold_frame_delta_mm) <=
          MAP_RUN_Q3_HOLD_STICTION_FRAME_DELTA_MAX_MM)) ? 1U : 0U;

    if (stiction_candidate == 0U) {
        g_q3_hold_stiction_candidate_active = 0U;
        return;
    }

    if (g_q3_hold_stiction_candidate_active == 0U) {
        g_q3_hold_stiction_candidate_active = 1U;
        g_q3_hold_stiction_candidate_start_ms = now_ms;
        g_q3_hold_stiction_candidate_x_mm =
            g_ball_beam_controller.filtered_x_mm;
        return;
    }

    if (MapRun_AbsFloat(
            g_ball_beam_controller.filtered_x_mm -
            g_q3_hold_stiction_candidate_x_mm) >
        MAP_RUN_Q3_HOLD_STICTION_CONFIRM_TRAVEL_MM) {
        g_q3_hold_stiction_candidate_active = 0U;
        return;
    }

    if ((now_ms - g_q3_hold_stiction_candidate_start_ms) >=
        MAP_RUN_Q3_HOLD_STICTION_CONFIRM_MS) {
        g_q3_hold_stiction_candidate_active = 0U;
        g_q3_hold_stiction_kick_active = 1U;
        g_q3_hold_stiction_kick_start_ms = now_ms;
        g_q3_hold_stiction_kick_deg =
            (position_error_mm > 0.0f) ?
                MAP_RUN_Q3_HOLD_STICTION_BREAKAWAY_ANGLE_DEG :
                -MAP_RUN_Q3_HOLD_STICTION_BREAKAWAY_ANGLE_DEG;
        g_q3_hold_stiction_position_deg =
            g_q3_hold_stiction_kick_deg;
    }
}

static void MapRun_UpdateQ3AdaptiveHold(void)
{
    uint32_t frame_id;
    uint32_t frame_period_ms;
    float position_error_mm;
    float speed_mm_s;
    float position_feedback_mm;
    float speed_feedback_mm_s;
    float frame_speed_mm_s;
    float candidate_bias_deg;
    float normal_hold_angle_deg;
    float profile_hold_angle_deg;
    float hold_angle_limit_deg;
    float hold_angle_deg;
    float filtered_hold_angle_deg;
    float angle_step_deg;
    uint8_t fresh_motion_direction_valid;
    uint8_t fast_approach_brake_active;
    uint8_t fast_escape_brake_active;

    if (((g_q3_state != MAP_Q3_STATE_LEVEL_SETTLE) &&
         (g_q3_state != MAP_Q3_STATE_HOLD_NEGATIVE)) ||
        (BallBeamController_IsControlReady(
             &g_ball_beam_controller) == 0U)) {
        return;
    }

    frame_id = g_ball_beam_controller.camera_frame_id;
    if (frame_id == g_q3_hold_last_camera_frame_id) {
        return;
    }
    g_q3_hold_last_camera_frame_id = frame_id;
    g_q3_hold_frame_delta_mm =
        g_ball_beam_controller.filtered_x_mm -
        g_q3_hold_last_filtered_x_mm;
    g_q3_hold_last_filtered_x_mm =
        g_ball_beam_controller.filtered_x_mm;

    /*
     * 一旦低速进入合格区，验稳期间只保持已经学到的局部平衡角。
     * 不再叠加带相位滞后的 P/D，避免把本来已经停住的球再次推出去。
     */
    if (g_q3_settle_lock_active != 0U) {
        /*
         * 完成后保持已经实测有效的局部平衡角。摄像头速度和单帧位移
         * 会受量化影响，不能仅因速度尖峰就重新启动闭环；只有位置真正
         * 离开 -60~-40 mm 合格区时，才恢复自适应拉回。
         */
        if ((g_q3_state == MAP_Q3_STATE_HOLD_NEGATIVE) &&
            ((g_ball_beam_controller.filtered_x_mm <
              MAP_RUN_Q3_SETTLE_MIN_POSITION_MM) ||
             (g_ball_beam_controller.filtered_x_mm >
              MAP_RUN_Q3_SETTLE_MAX_POSITION_MM))) {
            g_q3_settle_lock_active = 0U;
            g_q3_settle_capture_active = 0U;
            MapRun_ResetQ3MotionWindow();
            MapRun_SendBluetoothText(
                "[Q3 HOLD] Left valid zone; adaptive hold restored\r\n");
        } else {
            g_q3_hold_feedback_speed_mm_s = 0.0f;
            g_q3_hold_profile_target_speed_mm_s = 0.0f;
            g_q3_hold_profile_blend = 0.0f;
            g_q3_hold_stiction_position_deg = 0.0f;
            g_q3_manual_beam_angle_deg = g_q3_settle_lock_angle_deg;
            g_q3_manual_beam_active = 1U;
            BallBeamController_SetEnabled(&g_ball_beam_controller, 0U);
            return;
        }
    }

    frame_period_ms =
        (uint32_t) tick_ms - g_q3_hold_last_update_ms;
    g_q3_hold_last_update_ms = (uint32_t) tick_ms;
    if (frame_period_ms > MAP_RUN_Q3_HOLD_MAX_FRAME_MS) {
        frame_period_ms = MAP_RUN_Q3_HOLD_MAX_FRAME_MS;
    }

    position_error_mm =
        g_ball_beam_controller.filtered_x_mm -
        MAP_RUN_Q3_NEGATIVE_HOLD_MM;
    speed_mm_s = g_ball_beam_controller.ball_speed_mm_s;

    /*
     * I 项只在目标附近且低速时学习当前位置的等效坡度。这样同一根管道
     * 不同位置的弯度、摩擦变化会形成不同保持偏置，又不会在高速制动时
     * 积分饱和。P、D 始终负责位置拉回和速度反刹。
     */
    if ((MapRun_AbsFloat(position_error_mm) <=
         MAP_RUN_Q3_HOLD_I_MAX_ERROR_MM) &&
        (MapRun_AbsFloat(speed_mm_s) <=
         MAP_RUN_Q3_HOLD_I_MAX_SPEED_MM_S)) {
        candidate_bias_deg =
            g_q3_hold_bias_deg +
            MAP_RUN_Q3_HOLD_KI_DEG_PER_MM_S *
                position_error_mm *
                ((float) frame_period_ms / 1000.0f);
        g_q3_hold_bias_deg = MapRun_ClampFloat(
            candidate_bias_deg,
            -MAP_RUN_Q3_HOLD_MAX_BIAS_DEG,
            MAP_RUN_Q3_HOLD_MAX_BIAS_DEG);
    }

    position_feedback_mm =
        (MapRun_AbsFloat(position_error_mm) <=
         MAP_RUN_Q3_HOLD_POSITION_DEADBAND_MM) ?
            0.0f : position_error_mm;
    speed_feedback_mm_s = speed_mm_s;

    /*
     * 聚合球速约三帧才更新，在折返点会明显滞后。球每帧移动达到
     * 0.5 mm 时，按摄像头 40 FPS 估算即时速度并提高其权重，让 D 项
     * 在本次运动方向上提前制动；低速时仍使用聚合速度，避免 1 mm
     * 坐标量化造成摆杆抖动。
     */
    if (MapRun_AbsFloat(g_q3_hold_frame_delta_mm) >=
        MAP_RUN_Q3_HOLD_FRAME_SPEED_DELTA_MM) {
        frame_speed_mm_s = MapRun_ClampFloat(
            g_q3_hold_frame_delta_mm *
                (1000.0f / MAP_RUN_Q3_HOLD_FRAME_PERIOD_MS),
            -MAP_RUN_Q3_HOLD_MAX_FRAME_SPEED_MM_S,
            MAP_RUN_Q3_HOLD_MAX_FRAME_SPEED_MM_S);
        speed_feedback_mm_s =
            (1.0f - MAP_RUN_Q3_HOLD_FRAME_SPEED_BLEND) *
                speed_feedback_mm_s +
            MAP_RUN_Q3_HOLD_FRAME_SPEED_BLEND *
                frame_speed_mm_s;
    } else if (((g_q3_hold_frame_delta_mm >
                 MAP_RUN_Q3_HOLD_DIRECTION_DELTA_MM) &&
                (speed_feedback_mm_s < 0.0f)) ||
               ((g_q3_hold_frame_delta_mm <
                 -MAP_RUN_Q3_HOLD_DIRECTION_DELTA_MM) &&
                (speed_feedback_mm_s > 0.0f))) {
        speed_feedback_mm_s = 0.0f;
    }

    if (MapRun_AbsFloat(speed_feedback_mm_s) <=
        MAP_RUN_Q3_HOLD_SPEED_DEADBAND_MM_S) {
        speed_feedback_mm_s = 0.0f;
    }
    g_q3_hold_feedback_speed_mm_s = speed_feedback_mm_s;

    g_q3_hold_profile_target_speed_mm_s =
        MapRun_GetQ3HoldProfileTargetSpeedMmS(
            position_error_mm);
    g_q3_hold_profile_blend =
        MapRun_GetQ3HoldProfileBlend(position_error_mm);

    MapRun_UpdateQ3StictionAssist(
        position_error_mm,
        speed_feedback_mm_s);

    normal_hold_angle_deg =
        g_q3_hold_bias_deg +
        MAP_RUN_Q3_HOLD_KP_DEG_PER_MM *
            position_feedback_mm +
        MAP_RUN_Q3_HOLD_KD_DEG_PER_MM_S *
            speed_feedback_mm_s;
    profile_hold_angle_deg =
        MAP_RUN_Q3_HOLD_KD_DEG_PER_MM_S *
            (speed_feedback_mm_s -
             g_q3_hold_profile_target_speed_mm_s) +
        g_q3_hold_stiction_position_deg;

    /*
     * 普通收敛仍限制为 3.5 度。误差超过 8 mm、低速且连续帧几乎
     * 不动时，q3push 才会按目标方向请求完整 4.5 度破静摩擦；高速
     * 远离目标时也允许相同上限用于反刹，正常滑行仍保持普通上限。
     */
    hold_angle_limit_deg =
        (g_q3_hold_stiction_position_deg != 0.0f) ?
            MAP_RUN_Q3_HOLD_STICTION_MAX_ANGLE_DEG :
            MAP_RUN_Q3_HOLD_MAX_ANGLE_DEG;

    /*
     * 小球高速远离 -50 mm 时，角度本质上是在反刹而不是继续驱动。
     * 允许短暂使用 4.5 度，避免普通 3.5 度上限让小球穿过合格区后
     * 再做一次大摆；一旦重新朝向目标，立即恢复普通上限。
     */
    fresh_motion_direction_valid =
        (((g_q3_hold_frame_delta_mm * speed_feedback_mm_s) > 0.0f) &&
         (MapRun_AbsFloat(g_q3_hold_frame_delta_mm) >=
          MAP_RUN_Q3_HOLD_FRAME_SPEED_DELTA_MM)) ? 1U : 0U;
    fast_approach_brake_active =
        ((fresh_motion_direction_valid != 0U) &&
         ((position_error_mm * speed_feedback_mm_s) < 0.0f) &&
         (MapRun_AbsFloat(position_error_mm) <=
          MAP_RUN_Q3_HOLD_ENTRY_BRAKE_DISTANCE_MM) &&
         (MapRun_AbsFloat(speed_feedback_mm_s) >=
          MAP_RUN_Q3_HOLD_ENTRY_APPROACH_SPEED_MM_S)) ? 1U : 0U;
    fast_escape_brake_active =
        ((fresh_motion_direction_valid != 0U) &&
         ((position_error_mm * speed_feedback_mm_s) > 0.0f) &&
         (MapRun_AbsFloat(speed_feedback_mm_s) >=
          MAP_RUN_Q3_HOLD_ENTRY_ESCAPE_SPEED_MM_S)) ? 1U : 0U;
    if (fast_escape_brake_active != 0U) {
        hold_angle_limit_deg =
            MAP_RUN_Q3_HOLD_STICTION_MAX_ANGLE_DEG;
    }

    /*
     * 远离终点时跟随速度包络，让小球先加速再随距离主动减速。局部
     * 平衡偏置只在接近 -50 mm 时随混合系数逐步介入，避免远端坡度
     * 尚未确定时偏置压过速度方向；进入 6 mm 内仍完全使用原位置反馈。
     */
    hold_angle_deg = MapRun_ClampFloat(
        normal_hold_angle_deg *
            (1.0f - g_q3_hold_profile_blend) +
        profile_hold_angle_deg *
            g_q3_hold_profile_blend,
        -hold_angle_limit_deg,
        hold_angle_limit_deg);

    /*
     * 摄像头速度在折返点附近会因量化而换向。先对目标角做一阶低通，
     * 再限制单帧角度变化，避免步进电机在相邻帧之间大幅反复换向。
     */
    if ((g_q3_hold_entry_seed_pending != 0U) &&
        ((fast_approach_brake_active != 0U) ||
         (fast_escape_brake_active != 0U))) {
        /*
         * 距目标 25 mm 内仍高速接近，或已经越过目标继续远离时，
         * 0.45 度/帧斜率来不及制动。只有单帧位移与融合速度方向
         * 一致才绕过一次斜率限制，避免滞后速度在折返点误触发。
         */
        g_q3_manual_beam_angle_deg =
            (speed_feedback_mm_s > 0.0f) ?
                MAP_RUN_Q3_HOLD_ENTRY_BRAKE_ANGLE_DEG :
                -MAP_RUN_Q3_HOLD_ENTRY_BRAKE_ANGLE_DEG;
        g_q3_hold_entry_seed_pending = 0U;
        MapRun_SendBluetoothText(
            (fast_approach_brake_active != 0U) ?
                "[Q3] Terminal approach brake seeded\r\n" :
                "[Q3] Terminal escape brake seeded\r\n");
    } else if (g_q3_hold_stiction_position_deg != 0.0f) {
        /*
         * 破静摩擦时不再叠加软件角度斜率。步进脉冲频率本身已经限制
         * 机械运动速度，直接给目标角可省去约 0.5 s 的逐帧爬坡；检测
         * 到球重新移动后，本分支自动退出并恢复滤波和斜率限制。
         */
        g_q3_manual_beam_angle_deg = hold_angle_deg;
    } else {
        filtered_hold_angle_deg =
            g_q3_manual_beam_angle_deg +
            MAP_RUN_Q3_HOLD_ANGLE_FILTER_ALPHA *
                (hold_angle_deg - g_q3_manual_beam_angle_deg);
        angle_step_deg = MapRun_ClampFloat(
            filtered_hold_angle_deg - g_q3_manual_beam_angle_deg,
            -MAP_RUN_Q3_HOLD_MAX_ANGLE_STEP_DEG,
            MAP_RUN_Q3_HOLD_MAX_ANGLE_STEP_DEG);
        g_q3_manual_beam_angle_deg = MapRun_ClampFloat(
            g_q3_manual_beam_angle_deg + angle_step_deg,
            -hold_angle_limit_deg,
            hold_angle_limit_deg);

        if ((g_q3_hold_entry_seed_pending != 0U) &&
            (((uint32_t) tick_ms - g_q3_phase_start_ms) >=
             MAP_RUN_Q3_HOLD_ENTRY_BRAKE_WINDOW_MS)) {
            g_q3_hold_entry_seed_pending = 0U;
        }
    }
    g_q3_manual_beam_active = 1U;
    BallBeamController_SetEnabled(&g_ball_beam_controller, 0U);
}

static int64_t MapRun_AbsInt64(int64_t value)
{
    return (value < 0) ? (-value) : value;
}

static uint32_t MapRun_GetDistanceCounts(void)
{
    int64_t left_delta =
        (int64_t) MotorSpeed_GetLeftEncoderForwardCount() -
        (int64_t) g_left_start_count;
    int64_t right_delta =
        (int64_t) MotorSpeed_GetRightEncoderForwardCount() -
        (int64_t) g_right_start_count;
    uint64_t average_delta =
        (uint64_t) (MapRun_AbsInt64(left_delta) +
                    MapRun_AbsInt64(right_delta)) / 2ULL;

    if (average_delta > UINT32_MAX) {
        return UINT32_MAX;
    }

    return (uint32_t) average_delta;
}

static void MapRun_DisableBallBeam(void)
{
    MapRun_RestoreQ3PIDGains();
    g_q3_saved_pid_valid = 0U;
    g_q3_manual_beam_active = 0U;
    g_q3_hold_entry_seed_pending = 0U;
    MapRun_ResetQ3StictionAssist();
    g_q3_settle_lock_active = 0U;
    g_q3_settle_capture_active = 0U;
    g_q3_capture_pd_active = 0U;
    g_q3_manual_beam_angle_deg = 0.0f;
    g_q3_settle_lock_angle_deg = 0.0f;
    g_q3_hold_bias_deg = 0.0f;
    g_q3_hold_last_update_ms = (uint32_t) tick_ms;
    g_q3_hold_last_camera_frame_id =
        g_ball_beam_controller.camera_frame_id;
    g_q3_hold_last_filtered_x_mm =
        g_ball_beam_controller.filtered_x_mm;
    g_q3_hold_frame_delta_mm = 0.0f;
    g_q3_hold_feedback_speed_mm_s = 0.0f;
    g_q3_hold_profile_target_speed_mm_s = 0.0f;
    g_q3_hold_profile_blend = 0.0f;
    g_q3_hold_stiction_position_deg = 0.0f;
    MapRun_ResetQ4VelocityObserver();
    (void) BallBeamController_SetStaleTimeoutMs(
        &g_ball_beam_controller,
        BALL_BEAM_DEFAULT_STALE_TIMEOUT_MS);
    BallBeamController_SetEnabled(&g_ball_beam_controller, 0U);
    (void) BallBeamController_SetMotionProfile(
        &g_ball_beam_controller,
        MAP_RUN_BALL_SAFE_MAX_SPEED_MM_S,
        MAP_RUN_BALL_SAFE_POSITION_RATE_PER_S);
    (void) StepperMotor_EnablePositionTracking(0U);
}

static void MapRun_StopMotors(MapFinishReason reason)
{
    char response[144];
    uint8_t q4_finish_hold =
        ((reason == MAP_FINISH_Q4_B_PASSED) &&
         (MapRun_IsQ4Mode() != 0U)) ? 1U : 0U;
    uint8_t ball_lap_finish_hold =
        ((reason == MAP_FINISH_ONE_LAP) &&
         (MapRun_IsBallMode() != 0U) &&
         (BallBeamController_IsEnabled(
              &g_ball_beam_controller) != 0U)) ? 1U : 0U;
    uint8_t moving_ball_finish_hold =
        ((q4_finish_hold != 0U) ||
         (ball_lap_finish_hold != 0U)) ? 1U : 0U;

    g_q4_final_stop_active = 0U;
    g_q4_park_hold_active = 0U;
    g_q4_final_stop_start_rpm = 0.0f;
    g_q4_final_stop_left_duty_percent = 0.0f;
    g_q4_final_stop_right_duty_percent = 0.0f;
    g_ball_lap_final_stop_active = 0U;
    g_ball_lap_final_stop_start_rpm = 0.0f;
    g_ball_lap_final_stop_left_duty_percent = 0.0f;
    g_ball_lap_final_stop_right_duty_percent = 0.0f;

    if (q4_finish_hold != 0U) {
        /*
         * 停车后换成更慢的回中包络，并将位置保护限制为仅在超出
         * +/-10 mm 且近似静止时介入，减少低摩擦情况下反复穿过中心。
         */
        g_q4_park_hold_active = 1U;
        (void) BallBeamController_SetMotionProfile(
            &g_ball_beam_controller,
            MAP_RUN_Q4_PARK_MAX_SPEED_MM_S,
            MAP_RUN_Q4_PARK_POSITION_RATE_PER_S);
        g_q4_stop_feedforward_start_ms = tick_ms;
        /*
         * 只有球仍位于正侧并继续向正侧滚动时才保留停车接球角。
         * 若球已经越过中心或已经反向，重新施加 +0.8 度会制造第二次
         * 负向过冲，应立即交给速度阻尼和停车位置保护。
         */
        g_q4_stop_feedforward_active =
            ((BallBeamController_IsControlReady(
                  &g_ball_beam_controller) != 0U) &&
             (g_ball_beam_controller.filtered_x_mm > 0.0f) &&
             (g_q4_velocity_feedback_mm_s > 0.0f)) ? 1U : 0U;
        g_q4_feedforward_update_ms =
            tick_ms - MAP_RUN_CONTROL_PERIOD_MS;
        MapRun_UpdateMovingBallFeedforward();
        BallBeamController_Update(
            &g_ball_beam_controller, (uint32_t) tick_ms);
        if (StepperMotor_IsPositionTrackingEnabled() != 0U) {
            (void) StepperMotor_SetTargetPositionPulses(
                BallBeamController_GetTargetStepperPulses(
                    &g_ball_beam_controller));
        }
    } else if (ball_lap_finish_hold != 0U) {
        /*
         * 第五、六问只要求通过 A 点。底盘停下后继续以温和包络保持
         * 本轮锁定目标，并复用停车位置保护；若钢球之后慢慢漂出
         * +/-10 mm，保护会给出温和回拉角，而不是在完成报文后失控。
         */
        g_q4_park_hold_active = 1U;
        (void) BallBeamController_SetMotionProfile(
            &g_ball_beam_controller,
            MAP_RUN_BALL_PARK_MAX_SPEED_MM_S,
            MAP_RUN_BALL_PARK_POSITION_RATE_PER_S);
        g_q4_acceleration_feedforward_deg = 0.0f;
        g_q4_position_guard_deg = 0.0f;
        g_q4_velocity_damping_deg = 0.0f;
        g_q4_feedforward_update_ms =
            tick_ms - MAP_RUN_CONTROL_PERIOD_MS;
        MapRun_UpdateMovingBallFeedforward();
        BallBeamController_Update(
            &g_ball_beam_controller, (uint32_t) tick_ms);
        if (StepperMotor_IsPositionTrackingEnabled() != 0U) {
            (void) StepperMotor_SetTargetPositionPulses(
                BallBeamController_GetTargetStepperPulses(
                    &g_ball_beam_controller));
        }
    }

    MotorSpeedLoop_SetLeftWheelTargetRPM(0.0f);
    MotorSpeedLoop_SetRightWheelTargetRPM(0.0f);
    MotorSpeedLoop_EnableLeftWheel(0U);
    MotorSpeedLoop_EnableRightWheel(0U);

    /*
     * 第 2 问没有小球，终点允许使用 AT8236 主动刹车缩短滑行。
     * 其他模式以及人工/安全停机保持全低关断，避免改变其机械响应。
     */
    if ((reason == MAP_FINISH_ONE_LAP) &&
        (g_question_mode == MAP_QUESTION_MODE_1_Q2)) {
        MotorPWM_BrakeAllChannels();
        g_motor_brake_start_ms = tick_ms;
        g_motor_brake_active = 1U;
    } else {
        MotorPWM_StopAllChannels();
        g_motor_brake_active = 0U;
    }
    g_yaw_cascade_active = 0U;
    g_finish_heading_active = 0U;

    if (q4_finish_hold == 0U) {
        g_q4_stop_feedforward_active = 0U;
    }

    /*
     * 第四问通过 B 后只停止底盘，滚球闭环继续保持中心位置，避免车身
     * 制动造成的小球扰动无人修正。人工停机和所有故障仍关闭步进输出。
     */
    if (!((moving_ball_finish_hold != 0U) &&
          (BallBeamController_IsEnabled(
               &g_ball_beam_controller) != 0U))) {
        MapRun_DisableBallBeam();
    }
    g_q3_state = MAP_Q3_STATE_IDLE;
    g_q3_phase_start_ms = (uint32_t) tick_ms;

    if (g_map_state == MAP_RUN_STATE_RUNNING) {
        g_run_elapsed_ms = tick_ms - g_run_start_ms;
    }

    if (ball_lap_finish_hold != 0U) {
        g_ball_lap_completed_within_time =
            (g_run_elapsed_ms <= MAP_RUN_BALL_TIME_LIMIT_MS) ? 1U : 0U;
        (void) snprintf(
            response,
            sizeof(response),
            "[Q%u %s] Lap=%.2fs Target=%+.1f X=%+.1f MaxErr=%.1f mm\r\n",
            (unsigned int) MapRun_GetQuestionNumber(),
            (g_ball_lap_completed_within_time == 0U) ? "LATE" :
            ((g_ball_lap_limit_exceeded != 0U) ? "OVER" : "PASS"),
            (float) g_run_elapsed_ms / 1000.0f,
            g_ball_lap_active_target_mm,
            g_ball_beam_controller.filtered_x_mm,
            g_ball_lap_max_error_mm);
        MapRun_SendBluetoothText(response);
    }

    g_map_state = MAP_RUN_STATE_FINISHED;
    g_finish_reason = reason;
}

static void MapRun_UpdateMotorBrake(void)
{
    if ((g_motor_brake_active != 0U) &&
        ((tick_ms - g_motor_brake_start_ms) >=
         MAP_RUN_Q2_BRAKE_HOLD_MS)) {
        MotorPWM_StopAllChannels();
        g_motor_brake_active = 0U;
    }
}

static void MapRun_ResetEncoderFeedbackWatchdog(void)
{
    g_watchdog_left_encoder_count =
        MotorSpeed_GetLeftEncoderForwardCount();
    g_watchdog_right_encoder_count =
        MotorSpeed_GetRightEncoderForwardCount();
    g_watchdog_left_feedback_ms = tick_ms;
    g_watchdog_right_feedback_ms = tick_ms;
}

static void MapRun_UpdateEncoderFeedbackWatchdog(void)
{
    int32_t left_count =
        MotorSpeed_GetLeftEncoderForwardCount();
    int32_t right_count =
        MotorSpeed_GetRightEncoderForwardCount();
    float left_target =
        MotorSpeedLoop_GetLeftWheelTargetRPM();
    float right_target =
        MotorSpeedLoop_GetRightWheelTargetRPM();
    uint8_t left_fault = 0U;
    uint8_t right_fault = 0U;

    if (left_count != g_watchdog_left_encoder_count) {
        g_watchdog_left_encoder_count = left_count;
        g_watchdog_left_feedback_ms = tick_ms;
    }

    if (right_count != g_watchdog_right_encoder_count) {
        g_watchdog_right_encoder_count = right_count;
        g_watchdog_right_feedback_ms = tick_ms;
    }

    /* 有意降低 PWM 的停车阶段不使用“目标非零但无计数”故障判定。 */
    if ((g_q4_final_stop_active != 0U) ||
        (g_ball_lap_final_stop_active != 0U)) {
        g_watchdog_left_feedback_ms = tick_ms;
        g_watchdog_right_feedback_ms = tick_ms;
        return;
    }

    if (MapRun_AbsFloat(left_target) < 0.01f) {
        g_watchdog_left_feedback_ms = tick_ms;
    } else if ((tick_ms - g_watchdog_left_feedback_ms) >=
               MAP_RUN_ENCODER_FEEDBACK_TIMEOUT_MS) {
        left_fault = 1U;
    }

    if (MapRun_AbsFloat(right_target) < 0.01f) {
        g_watchdog_right_feedback_ms = tick_ms;
    } else if ((tick_ms - g_watchdog_right_feedback_ms) >=
               MAP_RUN_ENCODER_FEEDBACK_TIMEOUT_MS) {
        right_fault = 1U;
    }

    if ((left_fault != 0U) || (right_fault != 0U)) {
        MapRun_StopMotors(MAP_FINISH_ENCODER_FAULT);

        if ((left_fault != 0U) && (right_fault != 0U)) {
            MapRun_SendBluetoothText(
                "[SAFETY STOP] No encoder feedback: LEFT,RIGHT\r\n");
        } else if (left_fault != 0U) {
            MapRun_SendBluetoothText(
                "[SAFETY STOP] No encoder feedback: LEFT\r\n");
        } else {
            MapRun_SendBluetoothText(
                "[SAFETY STOP] No encoder feedback: RIGHT\r\n");
        }
    }
}

static void MapRun_PrepareMotorStart(void)
{
    Sensor_SetCalibrationKeyPressed(0U);
    if (BallBeamController_IsEnabled(
            &g_ball_beam_controller) == 0U) {
        StepperMotor_RequestStop();
    }
    g_motor_brake_active = 0U;
    g_q4_final_stop_active = 0U;
    g_q4_park_hold_active = 0U;
    g_q4_final_stop_start_rpm = 0.0f;
    g_q4_final_stop_left_duty_percent = 0.0f;
    g_q4_final_stop_right_duty_percent = 0.0f;
    g_ball_lap_final_stop_start_ms = tick_ms;
    g_ball_lap_final_stop_active = 0U;
    g_ball_lap_final_stop_start_rpm = 0.0f;
    g_ball_lap_final_stop_left_duty_percent = 0.0f;
    g_ball_lap_final_stop_right_duty_percent = 0.0f;
    MotorSpeedLoop_SetLeftWheelTargetRPM(0.0f);
    MotorSpeedLoop_SetRightWheelTargetRPM(0.0f);
    MotorSpeedLoop_EnableLeftWheel(0U);
    MotorSpeedLoop_EnableRightWheel(0U);
    MotorPWM_StopAllChannels();
    MotorSpeed_Reset();
    MotorSpeedLoop_ResetLeftWheelController();
    MotorSpeedLoop_ResetRightWheelController();
}

static uint8_t MapRun_PrepareQ4BallControl(void)
{
    char response[96];
    float start_error_mm;

    if (g_ball_stepper_zeroed == 0U) {
        MapRun_SendBluetoothText(
            "[Q4 BLOCKED] Re-zero level beam with BALL,ZERO\r\n");
        return 0U;
    }
    if (BallBeamController_IsControlReady(
            &g_ball_beam_controller) == 0U) {
        MapRun_SendBluetoothText(
            "[Q4 BLOCKED] No fresh valid camera frame\r\n");
        return 0U;
    }

    start_error_mm = MapRun_AbsFloat(
        g_ball_beam_controller.filtered_x_mm -
        MAP_RUN_Q4_TARGET_POSITION_MM);
    if (start_error_mm > MAP_RUN_Q4_START_CENTER_LIMIT_MM) {
        (void) snprintf(
            response,
            sizeof(response),
            "[Q4 BLOCKED] Place ball at O; current X=%.1f mm\r\n",
            g_ball_beam_controller.filtered_x_mm);
        MapRun_SendBluetoothText(response);
        return 0U;
    }

    if ((StepperMotor_IsPositionTrackingEnabled() == 0U) &&
        (StepperMotor_EnablePositionTracking(1U) == 0U)) {
        MapRun_SendBluetoothText(
            "[Q4 BLOCKED] Stepper is busy\r\n");
        return 0U;
    }

    /*
     * 先关闭一次控制器以清空旧积分和静摩擦补偿，再用当前已调 PID
     * 持续跟踪中心 0 mm；不覆盖 BALL,PID 和 BALL,TRIM 的赛前标定值。
     * 第四问使用独立的位置-速度包络：距离远时先加速回拉，接近中心
     * 时目标速度按剩余距离降低，实际回拉过快则 D 项自动反向制动。
     */
    g_q3_manual_beam_active = 0U;
    BallBeamController_SetEnabled(&g_ball_beam_controller, 0U);
    g_q4_acceleration_feedforward_deg = 0.0f;
    g_q4_position_guard_deg = 0.0f;
    g_q4_velocity_damping_deg = 0.0f;
    MapRun_ResetQ4VelocityObserver();
    g_q4_feedforward_update_ms =
        tick_ms - MAP_RUN_CONTROL_PERIOD_MS;
    g_q4_stop_feedforward_start_ms = tick_ms;
    g_q4_stop_feedforward_active = 0U;
    g_q4_final_stop_start_ms = tick_ms;
    g_q4_final_stop_active = 0U;
    g_q4_park_hold_active = 0U;
    g_q4_final_stop_start_rpm = 0.0f;
    g_q4_final_stop_left_duty_percent = 0.0f;
    g_q4_final_stop_right_duty_percent = 0.0f;
    g_ball_lap_final_stop_start_ms = tick_ms;
    g_ball_lap_final_stop_active = 0U;
    g_ball_lap_final_stop_start_rpm = 0.0f;
    g_ball_lap_final_stop_left_duty_percent = 0.0f;
    g_ball_lap_final_stop_right_duty_percent = 0.0f;
    g_q4_camera_fallback_active = 0U;
    (void) BallBeamController_SetExternalFeedforwardDeg(
        &g_ball_beam_controller, 0.0f);
    (void) BallBeamController_SetStaleTimeoutMs(
        &g_ball_beam_controller,
        MAP_RUN_Q4_STALE_TIMEOUT_MS);
    (void) BallBeamController_SetTargetPositionMm(
        &g_ball_beam_controller,
        MAP_RUN_Q4_TARGET_POSITION_MM);
    (void) BallBeamController_SetMotionProfile(
        &g_ball_beam_controller,
        MAP_RUN_Q4_RECOVERY_MAX_SPEED_MM_S,
        MAP_RUN_Q4_RECOVERY_POSITION_RATE_PER_S);
    BallBeamController_SetEnabled(&g_ball_beam_controller, 1U);
    (void) StepperMotor_SetTargetPositionPulses(
        BallBeamController_GetTargetStepperPulses(
            &g_ball_beam_controller));

    g_q4_max_ball_error_mm = start_error_mm;
    g_q4_ball_limit_exceeded =
        (start_error_mm > MAP_RUN_Q4_ALLOWED_ERROR_MM) ? 1U : 0U;
    MapRun_SendBluetoothText(
        "[Q4 BALL] Target=0 mm; return envelope=15 mm/s, 0.50/s\r\n");
    return 1U;
}

static uint8_t MapRun_PrepareBallLapControl(void)
{
    char response[128];
    float target_position_mm;
    float start_error_mm;

    if (MapRun_IsBallMode() == 0U) {
        return 1U;
    }
    if (g_ball_stepper_zeroed == 0U) {
        MapRun_SendBluetoothText(
            "[BALL LAP BLOCKED] Re-zero level beam with BALL,ZERO\r\n");
        return 0U;
    }
    if (BallBeamController_IsControlReady(
            &g_ball_beam_controller) == 0U) {
        MapRun_SendBluetoothText(
            "[BALL LAP BLOCKED] No fresh valid camera frame\r\n");
        return 0U;
    }

    target_position_mm =
        (g_question_mode == MAP_QUESTION_MODE_4_Q5) ?
            MAP_RUN_BALL_TARGET_POSITION_MM_Q5 :
            g_q6_target_position_mm;
    start_error_mm = MapRun_AbsFloat(
        g_ball_beam_controller.filtered_x_mm - target_position_mm);
    if (start_error_mm > MAP_RUN_BALL_START_TARGET_LIMIT_MM) {
        (void) snprintf(
            response,
            sizeof(response),
            "[BALL LAP BLOCKED] Place ball at %+.1f mm; X=%+.1f mm\r\n",
            target_position_mm,
            g_ball_beam_controller.filtered_x_mm);
        MapRun_SendBluetoothText(response);
        return 0U;
    }

    if ((StepperMotor_IsPositionTrackingEnabled() == 0U) &&
        (StepperMotor_EnablePositionTracking(1U) == 0U)) {
        MapRun_SendBluetoothText(
            "[BALL LAP BLOCKED] Stepper is busy\r\n");
        return 0U;
    }

    /*
     * 每圈开始时清空上一轮积分和静摩擦状态，但保留赛前通过 BALL,PID
     * 与 BALL,TRIM 标定的参数。Q5 强制锁定 0 mm，Q6 使用独立保存值。
     */
    g_q3_manual_beam_active = 0U;
    BallBeamController_SetEnabled(&g_ball_beam_controller, 0U);
    (void) BallBeamController_SetExternalFeedforwardDeg(
        &g_ball_beam_controller, 0.0f);
    (void) BallBeamController_SetStaleTimeoutMs(
        &g_ball_beam_controller,
        MAP_RUN_BALL_STALE_TIMEOUT_MS);
    (void) BallBeamController_SetTargetPositionMm(
        &g_ball_beam_controller,
        target_position_mm);
    (void) BallBeamController_SetMotionProfile(
        &g_ball_beam_controller,
        MAP_RUN_BALL_RECOVERY_MAX_SPEED_MM_S,
        MAP_RUN_BALL_RECOVERY_POSITION_RATE_PER_S);
    BallBeamController_SetEnabled(&g_ball_beam_controller, 1U);
    (void) StepperMotor_SetTargetPositionPulses(
        BallBeamController_GetTargetStepperPulses(
            &g_ball_beam_controller));

    g_ball_lap_active_target_mm = target_position_mm;
    g_ball_lap_max_error_mm = start_error_mm;
    g_ball_lap_limit_exceeded =
        (start_error_mm > MAP_RUN_BALL_ALLOWED_ERROR_MM) ? 1U : 0U;
    g_ball_lap_completed_within_time = 0U;
    g_ball_lap_camera_fallback_active = 0U;
    g_q4_acceleration_feedforward_deg = 0.0f;
    g_q4_position_guard_deg = 0.0f;
    g_q4_velocity_damping_deg = 0.0f;
    g_ball_lap_final_stop_start_ms = tick_ms;
    g_ball_lap_final_stop_active = 0U;
    g_ball_lap_final_stop_start_rpm = 0.0f;
    g_ball_lap_final_stop_left_duty_percent = 0.0f;
    g_ball_lap_final_stop_right_duty_percent = 0.0f;
    g_q4_feedforward_update_ms =
        tick_ms - MAP_RUN_CONTROL_PERIOD_MS;

    (void) snprintf(
        response,
        sizeof(response),
        "[Q%u BALL] Target=%+.1f mm; envelope=20 mm/s, 0.75/s\r\n",
        (unsigned int) MapRun_GetQuestionNumber(),
        target_position_mm);
    MapRun_SendBluetoothText(response);
    return 1U;
}

/*
 * 第六问赛场不依赖蓝牙设定目标。短按 B21 起跑前先读取最新摄像头
 * 位置，并把该位置同时保存为本轮目标；随后仍由正常起跑检查统一确认。
 */
static uint8_t MapRun_CaptureQ6TargetFromCamera(void)
{
    char response[96];
    float target_position_mm;

    if (g_question_mode != MAP_QUESTION_MODE_5_Q6) {
        return 1U;
    }
    if (BallBeamController_IsControlReady(
            &g_ball_beam_controller) == 0U) {
        MapRun_SendBluetoothText(
            "[Q6 BLOCKED] No fresh valid camera frame\r\n");
        return 0U;
    }

    target_position_mm = g_ball_beam_controller.filtered_x_mm;
    if (BallBeamController_SetTargetPositionMm(
            &g_ball_beam_controller,
            target_position_mm) == 0U) {
        MapRun_SendBluetoothText(
            "[Q6 BLOCKED] Current X is outside -120..120 mm\r\n");
        return 0U;
    }

    g_q6_target_position_mm = target_position_mm;
    g_ball_lap_active_target_mm = target_position_mm;
    (void) snprintf(
        response,
        sizeof(response),
        "[Q6 TARGET] B21 captured X=%+.1f mm; starting\r\n",
        target_position_mm);
    MapRun_SendBluetoothText(response);
    return 1U;
}

static void MapRun_EnterQ3NegativeDrive(void)
{
    char response[128];

    /* 预测峰值进入合格区后返程，适应每轮起滚速度差异。 */
    g_q3_brake_planned_speed_mm_s = 0.0f;
    g_q3_brake_angle_deg = 0.0f;
    g_q3_settle_capture_active = 0U;
    g_q3_capture_pd_active = 0U;
    g_q3_brake_low_speed_active = 0U;
    g_q3_motion_last_ms = (uint32_t) tick_ms;
    g_q3_motion_last_x_mm =
        g_ball_beam_controller.raw_x_mm;
    g_q3_fresh_speed_mm_s = 0.0f;
    MapRun_SetQ3ManualBeamAngle(
        MAP_RUN_Q3_LEFT_DRIVE_ANGLE_DEG);

    g_q3_state = MAP_Q3_STATE_DRIVE_NEGATIVE;
    g_q3_phase_start_ms = (uint32_t) tick_ms;
    (void) snprintf(
        response,
        sizeof(response),
        "[Q3] Positive predict X=%.1f V=%.1f Peak=%.1f -> +3.0 deg\r\n",
        g_ball_beam_controller.raw_x_mm,
        g_ball_beam_controller.ball_speed_mm_s,
        MapRun_GetQ3PositivePeakEstimateMm());
    MapRun_SendBluetoothText(response);
}

static void MapRun_EnterQ3NegativeBrake(void)
{
    char response[128];

    g_q3_brake_planned_speed_mm_s =
        MapRun_AbsFloat(g_q3_fresh_speed_mm_s) +
        MAP_RUN_Q3_BRAKE_SPEED_MARGIN_MM_S;
    g_q3_brake_angle_deg =
        -MapRun_CalculateQ3BrakeMagnitudeDeg(
            g_q3_fresh_speed_mm_s);
    MapRun_SetQ3ManualBeamAngle(g_q3_brake_angle_deg);

    g_q3_state = MAP_Q3_STATE_BRAKE_NEGATIVE;
    g_q3_phase_start_ms = (uint32_t) tick_ms;
    g_q3_settle_capture_active = 0U;
    g_q3_capture_pd_active = 0U;
    g_q3_brake_low_speed_active = 0U;
    g_q3_brake_low_speed_start_ms = (uint32_t) tick_ms;

    (void) snprintf(
        response,
        sizeof(response),
        "[Q3] Early soft brake X=%.1f V=%+.1f Vplan=%.1f A=%+.2f\r\n",
        g_ball_beam_controller.raw_x_mm,
        g_q3_fresh_speed_mm_s,
        g_q3_brake_planned_speed_mm_s,
        g_q3_brake_angle_deg);
    MapRun_SendBluetoothText(response);
}

static void MapRun_ResumeQ3NegativeDrive(void)
{
    /*
     * 能量制动若因局部坡度或静摩擦在 -40 mm 之前停住，不能提前交给
     * 终点闭环。重新给固定 +3 度向负端送球，达到明确左向速度后再由
     * 原有能量制动捕获，避免远离目标时运行慢速位置包络。
     */
    g_q3_brake_planned_speed_mm_s = 0.0f;
    g_q3_brake_angle_deg = 0.0f;
    g_q3_settle_capture_active = 0U;
    g_q3_capture_pd_active = 0U;
    g_q3_brake_low_speed_active = 0U;
    g_q3_motion_last_ms = (uint32_t) tick_ms;
    g_q3_motion_last_x_mm =
        g_ball_beam_controller.raw_x_mm;
    g_q3_fresh_speed_mm_s = 0.0f;
    MapRun_SetQ3ManualBeamAngle(
        MAP_RUN_Q3_LEFT_DRIVE_ANGLE_DEG);
    g_q3_state = MAP_Q3_STATE_DRIVE_NEGATIVE;
    g_q3_phase_start_ms = (uint32_t) tick_ms;
    MapRun_SendBluetoothText(
        "[Q3] Catch short of -40; resume fixed +3.0 deg\r\n");
}

static void MapRun_UpdateQ3NegativeBrakeAngle(void)
{
    float candidate_angle_deg;
    uint8_t rebound_confirmed;

    rebound_confirmed =
        ((g_q3_fresh_speed_mm_s >=
          MAP_RUN_Q3_CATCH_REBOUND_CONFIRM_MM_S) &&
         (g_ball_beam_controller.ball_speed_mm_s >=
          MAP_RUN_Q3_CATCH_REBOUND_CONFIRM_MM_S)) ? 1U : 0U;

    if (g_q3_settle_capture_active != 0U) {
        /*
         * 先给 100 ms 短上抬波克服换向和机构间隙，随后切入位置-速度
         * 串级 PD。位置误差生成预期速度，速度偏差实时调整角度，因此
         * 不再用固定 +1.8 度放任小球大幅自由往返。
         */
        if (g_q3_capture_pd_active != 0U) {
            g_q3_brake_angle_deg =
                MapRun_CalculateQ3CapturePDAngleDeg();
        } else if (((uint32_t) tick_ms -
                    g_q3_catch_pulse_start_ms) >=
                   MAP_RUN_Q3_CATCH_PULSE_MIN_MS) {
            char response[144];

            g_q3_capture_pd_active = 1U;
            g_q3_brake_angle_deg =
                MapRun_CalculateQ3CapturePDAngleDeg();
            (void) snprintf(
                response,
                sizeof(response),
                "[Q3] Capture PD X=%.1f V=%+.1f Vref=%+.1f A=%+.2f\r\n",
                g_ball_beam_controller.raw_x_mm,
                g_q3_fresh_speed_mm_s,
                g_q3_hold_profile_target_speed_mm_s,
                g_q3_brake_angle_deg);
            MapRun_SendBluetoothText(response);
        }
    } else if (rebound_confirmed != 0U) {
        /* 未触发预捕获的异常路径仍可在真实回弹后切正角。 */
        g_q3_brake_planned_speed_mm_s =
            g_q3_fresh_speed_mm_s;
        g_q3_brake_angle_deg =
            MapRun_CalculateQ3CatchAngleDeg(
                g_q3_fresh_speed_mm_s);
    } else if (g_q3_fresh_speed_mm_s < 0.0f) {
        /*
         * 左移期间按最新速度重算，但只允许负制动角继续增强，不因
         * 单帧零速或假反向提前撤坡。
         */
        g_q3_brake_planned_speed_mm_s =
            MapRun_AbsFloat(g_q3_fresh_speed_mm_s) +
            MAP_RUN_Q3_BRAKE_SPEED_MARGIN_MM_S;
        candidate_angle_deg =
            -MapRun_CalculateQ3BrakeMagnitudeDeg(
                g_q3_fresh_speed_mm_s);
        if ((g_q3_brake_angle_deg >= 0.0f) ||
            (candidate_angle_deg < g_q3_brake_angle_deg)) {
            g_q3_brake_angle_deg = candidate_angle_deg;
        }
    }
    MapRun_SetQ3ManualBeamAngle(g_q3_brake_angle_deg);
}

static void MapRun_EnterQ3LevelSettle(void)
{
    char response[96];
    float initial_bias_deg = MAP_RUN_Q3_HOLD_INITIAL_BIAS_DEG;
    uint8_t captured_in_valid_zone = 0U;

    /*
     * 制动低速后从当前能量吸收角平滑交给终点控制。只把初值限制在
     * +/-2 度，随后由积分学习 -5 cm 附近真实坡度；不同管段不水平、
     * 弯度和静摩擦变化都由这个局部偏置吸收，而不是假设全管水平。
     */
    if (g_q3_state == MAP_Q3_STATE_BRAKE_NEGATIVE) {
        initial_bias_deg = MapRun_ClampFloat(
            g_q3_brake_angle_deg,
            -2.0f,
            2.0f);
    }
    g_q3_manual_beam_angle_deg = initial_bias_deg;
    g_q3_hold_bias_deg = initial_bias_deg;
    g_q3_hold_last_update_ms = (uint32_t) tick_ms;
    g_q3_hold_last_camera_frame_id =
        g_ball_beam_controller.camera_frame_id;
    g_q3_hold_last_filtered_x_mm =
        g_ball_beam_controller.filtered_x_mm;
    g_q3_hold_frame_delta_mm = 0.0f;
    g_q3_hold_feedback_speed_mm_s = 0.0f;
    g_q3_hold_profile_target_speed_mm_s = 0.0f;
    g_q3_hold_profile_blend = 0.0f;
    MapRun_ResetQ3StictionAssist();
    g_q3_hold_entry_seed_pending = 0U;
    g_q3_settle_lock_active = 0U;
    g_q3_settle_capture_active = 0U;
    g_q3_capture_pd_active = 0U;
    g_q3_settle_lock_angle_deg = g_q3_hold_bias_deg;
    (void) BallBeamController_SetTargetPositionMm(
        &g_ball_beam_controller,
        MAP_RUN_Q3_NEGATIVE_HOLD_MM);
    g_q3_manual_beam_active = 1U;
    BallBeamController_SetEnabled(&g_ball_beam_controller, 0U);
    g_q3_state = MAP_Q3_STATE_LEVEL_SETTLE;
    g_q3_phase_start_ms = (uint32_t) tick_ms;
    MapRun_ResetQ3MotionWindow();

    /*
     * 若能量制动已经把球低速送入 -60~-40 mm，直接冻结刚刚验证有效的
     * 制动角并开始验稳。此时再启动位置包络或静摩擦 Kick 只会把已经
     * 接近静止的球重新推出合格区。
     */
    if ((g_ball_beam_controller.filtered_x_mm >=
         MAP_RUN_Q3_SETTLE_MIN_POSITION_MM) &&
        (g_ball_beam_controller.filtered_x_mm <=
         MAP_RUN_Q3_SETTLE_MAX_POSITION_MM) &&
        (MapRun_AbsFloat(g_q3_fresh_speed_mm_s) <=
         MAP_RUN_Q3_CATCH_LOW_SPEED_MM_S) &&
        (MapRun_AbsFloat(
             g_ball_beam_controller.ball_speed_mm_s) <=
         MAP_RUN_Q3_CATCH_LOW_SPEED_MM_S)) {
        g_q3_settle_lock_angle_deg = initial_bias_deg;
        g_q3_settle_lock_active = 1U;
        MapRun_SetQ3ManualBeamAngle(initial_bias_deg);
        captured_in_valid_zone = 1U;
    }

    if (captured_in_valid_zone != 0U) {
        (void) snprintf(
            response,
            sizeof(response),
            "[Q3] Direct catch; angle frozen at %+.2f deg\r\n",
            initial_bias_deg);
    } else {
        (void) snprintf(
            response,
            sizeof(response),
            "[Q3] Low-speed local hold; bias=%+.2f deg\r\n",
            initial_bias_deg);
    }
    MapRun_SendBluetoothText(response);
}

static void MapRun_FinishQ3(void)
{
    char response[128];
    float finish_x_mm = g_ball_beam_controller.filtered_x_mm;
    float finish_speed_mm_s = g_ball_beam_controller.ball_speed_mm_s;

    /*
     * 小球进入 -4~-6 cm 并连续低动后，冻结当时的有效角度完成验稳。
     * 完成后不再运行会继续注入能量的 P/D，也不恢复通用控制器。
     */
    MapRun_RestoreQ3PIDGains();
    g_q3_saved_pid_valid = 0U;
    MotorSpeedLoop_SetLeftWheelTargetRPM(0.0f);
    MotorSpeedLoop_SetRightWheelTargetRPM(0.0f);
    MotorSpeedLoop_EnableLeftWheel(0U);
    MotorSpeedLoop_EnableRightWheel(0U);
    MotorPWM_StopAllChannels();

    g_run_elapsed_ms = tick_ms - g_run_start_ms;
    g_q3_completed_within_time =
        (g_run_elapsed_ms <= MAP_RUN_Q3_TIME_LIMIT_MS) ? 1U : 0U;
    g_q3_state = MAP_Q3_STATE_HOLD_NEGATIVE;
    g_map_state = MAP_RUN_STATE_FINISHED;
    g_finish_reason = MAP_FINISH_Q3_COMPLETE;

    (void) snprintf(
        response,
        sizeof(response),
        "[Q3 %s] Settled -50 mm, time=%.2f s, X=%.1f V=%.1f Hold=%+.2f Bias=%+.2f\r\n",
        (g_q3_completed_within_time != 0U) ? "PASS" : "LATE",
        (float) g_run_elapsed_ms / 1000.0f,
        finish_x_mm,
        finish_speed_mm_s,
        g_q3_settle_lock_angle_deg,
        g_q3_hold_bias_deg);
    MapRun_SendBluetoothText(response);
}

static void MapRun_UpdateQ3Sequence(void)
{
    if ((MapRun_IsQ3Mode() == 0U) ||
        (g_map_state != MAP_RUN_STATE_RUNNING)) {
        return;
    }

    if ((g_run_elapsed_ms > MAP_RUN_Q3_TIME_LIMIT_MS) &&
        (g_q3_time_warning_sent == 0U)) {
        g_q3_time_warning_sent = 1U;
        MapRun_SendBluetoothText(
            "[Q3 WARN] 5 s exceeded; control continues for diagnosis\r\n");
    }

    /* 主循环远快于摄像头，阶段切换只允许每个有效新帧判断一次。 */
    if ((BallBeamController_IsControlReady(
             &g_ball_beam_controller) == 0U) ||
        (g_ball_beam_controller.camera_frame_id ==
         g_q3_last_camera_frame_id)) {
        return;
    }
    g_q3_last_camera_frame_id =
        g_ball_beam_controller.camera_frame_id;
    g_q3_fresh_speed_mm_s = MapRun_UpdateQ3FreshSpeedMmS();

    if (g_q3_state == MAP_Q3_STATE_TO_POSITIVE) {
        /*
         * 固定 +5 mm 切换时峰值只有 +22 mm，固定 +20 mm 在高起滚速度
         * 时又冲到 +111 mm。改用平滑球速预测峰值，并给摄像头 1 mm
         * 量化误差留出切换裕量，让高速度轮次更早换坡、低速度轮次
         * 更晚换坡。
         */
        if (((MapRun_GetQ3PositivePeakEstimateMm() +
              MAP_RUN_Q3_POSITIVE_SWITCH_MARGIN_MM) >=
             MAP_RUN_Q3_POSITIVE_TARGET_MIN_MM) &&
            (g_ball_beam_controller.ball_speed_mm_s >=
             MAP_RUN_Q3_POSITIVE_RETURN_MIN_SPEED_MM_S)) {
            MapRun_EnterQ3NegativeDrive();
        }
        return;
    }

    if (g_q3_state == MAP_Q3_STATE_DRIVE_NEGATIVE) {
        /*
         * 历史实测中，高速左移后使用柔和制动曾在 4.45 s 内停到
         * -51.9 mm。仅确认速度为负还不够：约 -20~-70 mm/s 时提前
         * 制动会让球停在正区并反复补送，因此先建立至少 100 mm/s 的
         * 左移动量，再由 70 mm 模型和负端预捕获共同停车。
         */
        if ((g_ball_beam_controller.raw_x_mm <=
             MAP_RUN_Q3_NEGATIVE_BRAKE_TRIGGER_MM) &&
            (g_q3_fresh_speed_mm_s <=
             MAP_RUN_Q3_NEGATIVE_BRAKE_MIN_SPEED_MM_S)) {
            MapRun_EnterQ3NegativeBrake();
        }
        return;
    }

    if (g_q3_state == MAP_Q3_STATE_BRAKE_NEGATIVE) {
        /*
         * 先用负角吸收左移动能，再提前切到正向局部平衡角覆盖步进换向
         * 延迟。首次回弹不代表已经停住，不能立即交给终点 PID；只有
         * 即时速度和聚合速度同时连续低速 75 ms，才允许状态交接。
         */
        /*
         * 步进电机从 -3 度换到正角约需 100 ms。若等球真正回弹才换向，
         * 日志表明小球会从 -44 mm 重新滚回接近 0 mm。小球进入合格区
         * 前约 5 mm 且融合速度已经下降时提前预置局部平衡角，让机械
         * 换向时间与剩余左移动量重叠。单帧速度存在跳变和滞后，因此
         * 这里使用融合速度判断动量，避免高速时过早撤掉 -3 度反刹。
         */
        if ((g_q3_settle_capture_active == 0U) &&
            (g_ball_beam_controller.raw_x_mm <=
             MAP_RUN_Q3_PRE_CATCH_TRIGGER_MM) &&
            (MapRun_AbsFloat(
                 g_ball_beam_controller.ball_speed_mm_s) <=
             MAP_RUN_Q3_PRE_CATCH_MAX_SPEED_MM_S)) {
            char response[112];

            g_q3_settle_capture_active = 1U;
            g_q3_capture_pd_active = 0U;
            g_q3_catch_pulse_start_ms = (uint32_t) tick_ms;
            g_q3_brake_angle_deg =
                MAP_RUN_Q3_PRE_CATCH_ANGLE_DEG;
            g_q3_brake_low_speed_active = 0U;
            MapRun_SetQ3ManualBeamAngle(
                g_q3_brake_angle_deg);
            (void) snprintf(
                response,
                sizeof(response),
                "[Q3] Pre-catch X=%.1f Vf=%+.1f V=%+.1f A=%+.2f\r\n",
                g_ball_beam_controller.raw_x_mm,
                g_q3_fresh_speed_mm_s,
                g_ball_beam_controller.ball_speed_mm_s,
                g_q3_brake_angle_deg);
            MapRun_SendBluetoothText(response);
        }

        MapRun_UpdateQ3NegativeBrakeAngle();

        if (((g_q3_settle_capture_active == 0U) ||
             (g_q3_capture_pd_active != 0U)) &&
            (MapRun_AbsFloat(g_q3_fresh_speed_mm_s) <=
             MAP_RUN_Q3_CATCH_LOW_SPEED_MM_S) &&
            (MapRun_AbsFloat(
                 g_ball_beam_controller.ball_speed_mm_s) <=
             MAP_RUN_Q3_CATCH_LOW_SPEED_MM_S)) {
            if (g_q3_brake_low_speed_active == 0U) {
                g_q3_brake_low_speed_active = 1U;
                g_q3_brake_low_speed_start_ms =
                    (uint32_t) tick_ms;
            } else if (((uint32_t) tick_ms -
                        g_q3_brake_low_speed_start_ms) >=
                       MAP_RUN_Q3_CATCH_LOW_SPEED_CONFIRM_MS) {
                if (g_ball_beam_controller.raw_x_mm <
                    MAP_RUN_Q3_TERMINAL_HANDOFF_MIN_MM) {
                    MapRun_EnterQ3LevelSettle();
                } else {
                    MapRun_ResumeQ3NegativeDrive();
                }
            }
        } else {
            g_q3_brake_low_speed_active = 0U;
        }
        return;
    }

    if (g_q3_state == MAP_Q3_STATE_LEVEL_SETTLE) {
        if ((g_ball_beam_controller.filtered_x_mm <
             MAP_RUN_Q3_SETTLE_MIN_POSITION_MM) ||
            (g_ball_beam_controller.filtered_x_mm >
             MAP_RUN_Q3_SETTLE_MAX_POSITION_MM)) {
            g_q3_settle_capture_active = 0U;
            g_q3_settle_lock_active = 0U;
            MapRun_ResetQ3MotionWindow();
            return;
        }

        /*
         * 低动确认后冻结当时已经让小球接近静止的实际角度，不再额外
         * 改成“偏置 +/- 固定推力”。冻结期间若仍移动超过门槛，立即
         * 解锁并恢复自适应；否则连续验稳 250 ms 后完成。
         */
        if (g_q3_settle_lock_active != 0U) {
            if ((MapRun_AbsFloat(g_q3_hold_frame_delta_mm) >
                 MAP_RUN_Q3_SETTLE_MAX_FRAME_DELTA_MM) ||
                (MapRun_AbsFloat(
                     g_ball_beam_controller.ball_speed_mm_s) >
                 MAP_RUN_Q3_SETTLE_MAX_SPEED_MM_S) ||
                (MapRun_AbsFloat(
                     g_ball_beam_controller.filtered_x_mm -
                     g_q3_window_start_x_mm) >
                 MAP_RUN_Q3_SETTLE_VERIFY_MAX_DELTA_MM)) {
                g_q3_settle_capture_active = 0U;
                g_q3_settle_lock_active = 0U;
                MapRun_ResetQ3MotionWindow();
                MapRun_SendBluetoothText(
                    "[Q3] Frozen hold released; motion resumed\r\n");
                return;
            }

            if ((MapRun_AbsFloat(g_q3_hold_frame_delta_mm) <=
                  MAP_RUN_Q3_SETTLE_CONFIRM_MAX_DELTA_MM) &&
                (MapRun_AbsFloat(
                     g_ball_beam_controller.ball_speed_mm_s) <=
                 MAP_RUN_Q3_SETTLE_FINISH_MAX_SPEED_MM_S) &&
                (MapRun_IsQ3MotionWindowStable(
                     MAP_RUN_Q3_SETTLE_VERIFY_MS,
                     MAP_RUN_Q3_SETTLE_VERIFY_MAX_DELTA_MM) != 0U)) {
                MapRun_FinishQ3();
            }
            return;
        }

        if ((MapRun_AbsFloat(
                 g_q3_hold_feedback_speed_mm_s) <=
             MAP_RUN_Q3_SETTLE_MAX_SPEED_MM_S) &&
            (MapRun_AbsFloat(
                 g_ball_beam_controller.ball_speed_mm_s) <=
             MAP_RUN_Q3_SETTLE_MAX_SPEED_MM_S) &&
            (MapRun_AbsFloat(g_q3_hold_frame_delta_mm) <=
             MAP_RUN_Q3_SETTLE_MAX_FRAME_DELTA_MM)) {
            if (MapRun_IsQ3MotionWindowStable(
                    MAP_RUN_Q3_SETTLE_CONFIRM_MS,
                    MAP_RUN_Q3_SETTLE_CONFIRM_MAX_DELTA_MM) != 0U) {
                g_q3_settle_lock_angle_deg =
                    g_q3_manual_beam_angle_deg;
                g_q3_settle_capture_active = 0U;
                g_q3_settle_lock_active = 1U;
                g_q3_hold_entry_seed_pending = 0U;
                MapRun_ResetQ3StictionAssist();
                MapRun_ResetQ3MotionWindow();
                MapRun_SendBluetoothText(
                    "[Q3] Low motion confirmed; angle frozen, verifying 250 ms\r\n");
            }
            return;
        }

        g_q3_settle_capture_active = 0U;
        MapRun_ResetQ3MotionWindow();
        return;
    }
}

static uint8_t MapRun_StartQ3(void)
{
    char response[96];

    if (g_ball_stepper_zeroed == 0U) {
        MapRun_SendBluetoothText(
            "[Q3 BLOCKED] Re-zero level beam with BALL,ZERO\r\n");
        return 0U;
    }
    if (BallBeamController_IsControlReady(
            &g_ball_beam_controller) == 0U) {
        MapRun_SendBluetoothText(
            "[Q3 BLOCKED] No fresh valid camera frame\r\n");
        return 0U;
    }
    if (MapRun_AbsFloat(
            g_ball_beam_controller.filtered_x_mm) >
        MAP_RUN_Q3_START_CENTER_LIMIT_MM) {
        (void) snprintf(
            response,
            sizeof(response),
            "[Q3 BLOCKED] Place ball at O; current X=%.1f mm\r\n",
            g_ball_beam_controller.filtered_x_mm);
        MapRun_SendBluetoothText(response);
        return 0U;
    }
    if ((StepperMotor_IsPositionTrackingEnabled() == 0U) &&
        (StepperMotor_EnablePositionTracking(1U) == 0U)) {
        MapRun_SendBluetoothText(
            "[Q3 BLOCKED] Stepper is busy\r\n");
        return 0U;
    }

    /* 第三问允许一次摄像头短帧间隙，不因 183 ms 抖动重置末端速度。 */
    (void) BallBeamController_SetStaleTimeoutMs(
        &g_ball_beam_controller,
        MAP_RUN_Q3_STALE_TIMEOUT_MS);

    /* 保存用户当前 PID，第三问捕获完成或退出时必须原样恢复。 */
    g_q3_saved_kp = g_ball_beam_controller.kp_deg_per_mm;
    g_q3_saved_ki = g_ball_beam_controller.ki_deg_per_mm_s;
    g_q3_saved_kd = g_ball_beam_controller.kd_deg_per_mm_s;
    g_q3_saved_pid_valid = 1U;
    g_q3_manual_beam_active = 0U;
    g_q3_hold_entry_seed_pending = 0U;
    g_q3_settle_lock_active = 0U;
    g_q3_settle_capture_active = 0U;
    g_q3_capture_pd_active = 0U;
    g_q3_manual_beam_angle_deg = 0.0f;
    g_q3_settle_lock_angle_deg = 0.0f;
    g_q3_brake_planned_speed_mm_s = 0.0f;
    g_q3_brake_angle_deg = 0.0f;
    g_q3_brake_low_speed_active = 0U;
    g_q3_brake_low_speed_start_ms = (uint32_t) tick_ms;
    g_q3_motion_last_ms = (uint32_t) tick_ms;
    g_q3_motion_last_x_mm =
        g_ball_beam_controller.raw_x_mm;
    g_q3_fresh_speed_mm_s = 0.0f;
    g_q3_hold_profile_target_speed_mm_s = 0.0f;
    g_q3_hold_profile_blend = 0.0f;
    MapRun_ResetQ3StictionAssist();

    MapRun_SetQ3ManualBeamAngle(
        MAP_RUN_Q3_POSITIVE_DRIVE_ANGLE_DEG);

    g_run_start_ms = tick_ms;
    g_run_elapsed_ms = 0UL;
    g_last_control_ms = tick_ms;
    g_last_speed_ms = tick_ms;
    g_last_telemetry_ms = tick_ms;
    g_run_distance_counts = 0U;
    g_q3_state = MAP_Q3_STATE_TO_POSITIVE;
    g_q3_completed_within_time = 0U;
    g_q3_time_warning_sent = 0U;
    g_q3_phase_start_ms = (uint32_t) tick_ms;
    MapRun_ResetQ3MotionWindow();
    g_q3_last_camera_frame_id =
        g_ball_beam_controller.camera_frame_id;
    g_control_mode = MAP_CONTROL_LINE_FOLLOW;
    g_finish_reason = MAP_FINISH_NONE;
    g_map_state = MAP_RUN_STATE_RUNNING;

    /* M2/Q3 自动开启 100 ms 诊断，便于赛前直接复盘整段动作。 */
    MapRun_EnableAutomaticBallLog("Q3");

    MapRun_SendBluetoothText(
        "[Q3 START] predicted +40 peak; brake at +20; capture PD\r\n");
    return 1U;
}

static void MapRun_Start(void)
{
    uint8_t initial_sensor;
    uint8_t heading_reference_fresh;

    MapRun_PrepareMotorStart();

    /*
     * M1~M5 分别对应第 2~6 问。M2 是静止滚球时序，不启动底盘，
     * 也不要求灰度探头位于黑线上。
     */
    if (MapRun_IsQuestionModeReady() == 0U) {
        g_map_state = MAP_RUN_STATE_READY;
        g_finish_reason = MAP_FINISH_NONE;
        MapRun_SendBluetoothText(
            "[START BLOCKED] Selected mode is not implemented\r\n");
        MapRun_SendQuestionModeStatus();
        return;
    }

    if (MapRun_IsQ3Mode() != 0U) {
        if (MapRun_StartQ3() == 0U) {
            MapRun_DisableBallBeam();
            g_map_state = MAP_RUN_STATE_READY;
            g_finish_reason = MAP_FINISH_NONE;
        }
        return;
    }

    if ((MapRun_IsQ4Mode() != 0U) &&
        (MapRun_PrepareQ4BallControl() == 0U)) {
        MapRun_DisableBallBeam();
        g_map_state = MAP_RUN_STATE_READY;
        g_finish_reason = MAP_FINISH_NONE;
        return;
    }

    if ((MapRun_IsBallMode() != 0U) &&
        (MapRun_PrepareBallLapControl() == 0U)) {
        MapRun_DisableBallBeam();
        g_map_state = MAP_RUN_STATE_READY;
        g_finish_reason = MAP_FINISH_NONE;
        return;
    }

    initial_sensor = Sensor_Read_Grayscale();

    /*
     * 没有检测到黑线时禁止起跑，避免传感器未对准或断线时直接直行。
     * A 点横线允许多路同时为黑，因此这里只拦截全白结果。
     */
    if (MapLineController_CountActive(initial_sensor) == 0U) {
        MapRun_StopMotors(MAP_FINISH_NO_START_LINE);
        MapRun_SendBluetoothText(
            "[MAP BLOCKED] No black line under sensor\r\n");
        return;
    }

    g_left_start_count = MotorSpeed_GetLeftEncoderForwardCount();
    g_right_start_count = MotorSpeed_GetRightEncoderForwardCount();
    g_run_distance_counts = 0U;
    g_run_start_ms = tick_ms;
    g_run_elapsed_ms = 0UL;
    g_last_control_ms = tick_ms;
    g_last_speed_ms = tick_ms;
    g_last_telemetry_ms = tick_ms;
    MapRun_ResetEncoderFeedbackWatchdog();

    g_sensor_value = initial_sensor;
    MapLineController_Reset(&g_line_controller);
    MapLineController_Update(&g_line_controller,
                             initial_sensor,
                             &g_line_result);
    g_sensor_active_count = g_line_result.active_count;
    g_start_line_left = 0U;
    g_lap_finish_armed = 0U;
    g_start_line_leave_count = 0U;
    g_finish_line_count = 0U;
    g_q4_right_second_seen = 0U;
    g_line_error = g_line_result.error;
    g_correction_rpm = g_line_result.correction_rpm;

    /* 一圈结束时应回到起跑航向；只接受起跑前仍新鲜的 BNO085 样本。 */
    heading_reference_fresh =
        MapYawRateController_IsFresh(&g_yaw_rate_controller,
                                     (uint32_t) tick_ms);
    g_finish_heading_reference_yaw_deg = yaw;
    g_finish_heading_reference_valid =
        ((BNO085_IsReady() != 0U) &&
         (heading_reference_fresh != 0U)) ? 1U : 0U;
    MapRun_ResetBallLapTurnTracking(
        (MapRun_IsBallMode() != 0U) ?
            g_finish_heading_reference_valid : 0U);
    MapRun_ResetYawCascade();
    if (MapRun_IsQ4Mode() != 0U) {
        g_center_speed_rpm = 0.0f;
        g_base_speed_rpm = g_center_speed_rpm;
    } else if (MapRun_IsBallMode() != 0U) {
        g_center_speed_rpm = 0.0f;
        g_base_speed_rpm = g_center_speed_rpm;
    }
    g_control_mode = MAP_CONTROL_LINE_FOLLOW;
    g_finish_reason = MAP_FINISH_NONE;
    g_map_state = MAP_RUN_STATE_RUNNING;

    MotorSpeedLoop_EnableLeftWheel(1U);
    MotorSpeedLoop_EnableRightWheel(1U);
    MotorSpeedLoop_SetLeftWheelTargetRPM(g_base_speed_rpm);
    MotorSpeedLoop_SetRightWheelTargetRPM(g_base_speed_rpm);

    /* 第四问每次起跑都重新打印表头，便于完整截取本轮数据。 */
    if (MapRun_IsQ4Mode() != 0U) {
        MapRun_EnableAutomaticBallLog("Q4");
    } else if (MapRun_IsBallMode() != 0U) {
        /*
         * 长 BALLLOG 在 115200 波特率下会明显阻塞 10 ms 巡线任务。
         * 整圈模式改发精简状态；需要完整诊断时可手动 BALL,LOG,ON。
         */
        g_ball_log_enabled = 0U;
        g_last_ball_lap_telemetry_ms =
            tick_ms - MAP_RUN_BALL_LAP_TELEMETRY_PERIOD_MS;
        MapRun_SendBluetoothText(
            "[BALL TELEMETRY] Q5/Q6 compact CSV enabled at 250 ms\r\n");
        MapRun_SendBluetoothText(
            "# QxBALL=time_s,x_mm,set_mm,error_mm,v_mm_s,angle_deg,"
            "max_error_mm,cam,age_ms,d_count,turn_deg\r\n");
    }
}

static void MapRun_StartSpeedTest(void)
{
    MapRun_PrepareMotorStart();
    MapRun_ResetYawCascade();

    g_left_start_count = MotorSpeed_GetLeftEncoderForwardCount();
    g_right_start_count = MotorSpeed_GetRightEncoderForwardCount();
    g_run_distance_counts = 0U;
    g_run_start_ms = tick_ms;
    g_run_elapsed_ms = 0UL;
    g_last_control_ms = tick_ms;
    g_last_speed_ms = tick_ms;
    g_last_telemetry_ms = tick_ms;
    MapRun_ResetEncoderFeedbackWatchdog();
    g_control_mode = MAP_CONTROL_SPEED_TEST;
    g_finish_reason = MAP_FINISH_NONE;
    g_map_state = MAP_RUN_STATE_RUNNING;

    MotorSpeedLoop_EnableLeftWheel(1U);
    MotorSpeedLoop_EnableRightWheel(1U);
    MotorSpeedLoop_SetLeftWheelTargetRPM(
        g_speed_test_left_target_rpm);
    MotorSpeedLoop_SetRightWheelTargetRPM(
        g_speed_test_right_target_rpm);
}

static uint8_t MapRun_ReadBluetoothByte(uint8_t *data)
{
    if ((data == NULL) ||
        (g_uart_rx_read_index == g_uart_rx_write_index)) {
        return 0U;
    }

    *data = g_uart_rx_buffer[g_uart_rx_read_index];
    g_uart_rx_read_index =
        (uint16_t) ((g_uart_rx_read_index + 1U) %
                    MAP_RUN_UART_RX_BUFFER_SIZE);
    return 1U;
}

static const char *MapRun_SkipSpaces(const char *text)
{
    while ((text != NULL) &&
           ((*text == ' ') || (*text == '\t'))) {
        text++;
    }

    return text;
}

static uint8_t MapRun_ParseFloat(const char **cursor, float *value)
{
    const char *start;
    char *end;
    float parsed_value;

    if ((cursor == NULL) || (*cursor == NULL) || (value == NULL)) {
        return 0U;
    }

    start = MapRun_SkipSpaces(*cursor);
    parsed_value = strtof(start, &end);
    if ((end == start) || (parsed_value != parsed_value)) {
        return 0U;
    }

    *value = parsed_value;
    *cursor = MapRun_SkipSpaces(end);
    return 1U;
}
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
