pkppkqsmall/MSPM0G3507-NUEDC-H-Ball-Car/Firmware/Drivers/MPU6050/mpu6050.c

#include "ti_msp_dl_config.h"

#include "inv_mpu.h"
#include "inv_mpu_dmp_motion_driver.h"

#include <stdio.h>
#include <stdint.h>
#include <stdlib.h>
#include <string.h>
#include <math.h>

#include "mpu6050.h"
#include "mspm0_i2c.h"

/* Data requested by client. */
#define PRINT_ACCEL     (0x01)
#define PRINT_GYRO      (0x02)
#define PRINT_QUAT      (0x04)

#define ACCEL_ON        (0x01)
#define GYRO_ON         (0x02)

#define MOTION          (0)
#define NO_MOTION       (1)

/* Starting sampling rate. */
#define DEFAULT_MPU_HZ  (50)
#define MPU6050_FIFO_DRAIN_LIMIT  (8U)

#define FLASH_SIZE      (512)
#define FLASH_MEM_START ((void*)0x1800)

struct rx_s {
    unsigned char header[3];
    unsigned char cmd;
};
struct hal_s {
    unsigned char sensors;
    unsigned char dmp_on;
    unsigned char wait_for_tap;
    volatile unsigned char new_gyro;
    unsigned short report;
    unsigned short dmp_features;
    unsigned char motion_int_mode;
    struct rx_s rx;
};
static struct hal_s hal = {0};

unsigned long sensor_timestamp;
short gyro[3], accel[3], sensors;
unsigned char more;
long quat[4];

#define q30  (1073741824.0f) /* 2^30 = 1073741824 */
volatile float pitch, roll, yaw;

/* The sensors can be mounted onto the board in any orientation. The mounting
 * matrix seen below tells the MPL how to rotate the raw data from thei
 * driver(s).
 * TODO: The following matrices refer to the configuration on an internal test
 * board at Invensense. If needed, please modify the matrices to match the
 * chip-to-body matrix for your particular set up.
 */
static signed char gyro_orientation[9] = {-1, 0, 0,
                                           0,-1, 0,
                                           0, 0, 1};

static void tap_cb(unsigned char direction, unsigned char count)
{

}

static void android_orient_cb(unsigned char orientation)
{

}

/* These next two functions converts the orientation matrix (see
 * gyro_orientation) to a scalar representation for use by the DMP.
 * NOTE: These functions are borrowed from Invensense's MPL.
 */
static inline unsigned short inv_row_2_scale(const signed char *row)
{
    unsigned short b;

    if (row[0] > 0)
        b = 0;
    else if (row[0] < 0)
        b = 4;
    else if (row[1] > 0)
        b = 1;
    else if (row[1] < 0)
        b = 5;
    else if (row[2] > 0)
        b = 2;
    else if (row[2] < 0)
        b = 6;
    else
        b = 7;      // error
    return b;
}

static inline unsigned short inv_orientation_matrix_to_scalar(
    const signed char *mtx)
{
    unsigned short scalar;

    /*
       XYZ  010_001_000 Identity Matrix
       XZY  001_010_000
       YXZ  010_000_001
       YZX  000_010_001
       ZXY  001_000_010
       ZYX  000_001_010
     */

    scalar = inv_row_2_scale(mtx);
    scalar |= inv_row_2_scale(mtx + 3) << 3;
    scalar |= inv_row_2_scale(mtx + 6) << 6;


    return scalar;
}

uint8_t MPU6050_Init(void)
{
    int result;
    unsigned char accel_fsr;
    unsigned short gyro_rate, gyro_fsr;

    if(DL_I2C_getSDAStatus(I2C_MPU6050_INST) == DL_I2C_CONTROLLER_SDA_LOW)
        mpu6050_i2c_sda_unlock();

    result = mpu_init();
    if (result)
        return 0U;

    result = 0;
    /* Get/set hardware configuration. Start gyro. */
    /* Wake up all sensors. */
    result += mpu_set_sensors(INV_XYZ_GYRO | INV_XYZ_ACCEL);
    /* Push both gyro and accel data into the FIFO. */
    result += mpu_configure_fifo(INV_XYZ_GYRO | INV_XYZ_ACCEL);
    result += mpu_set_sample_rate(DEFAULT_MPU_HZ);
    /* Read back configuration in case it was set improperly. */
    result += mpu_get_sample_rate(&gyro_rate);
    result += mpu_get_gyro_fsr(&gyro_fsr);
    result += mpu_get_accel_fsr(&accel_fsr);

    /* Initialize HAL state variables. */
    memset(&hal, 0, sizeof(hal));
    hal.sensors = ACCEL_ON | GYRO_ON;
    hal.report = PRINT_QUAT;

    /* To initialize the DMP:
     * 1. Call dmp_load_motion_driver_firmware(). This pushes the DMP image in
     *    inv_mpu_dmp_motion_driver.h into the MPU memory.
     * 2. Push the gyro and accel orientation matrix to the DMP.
     * 3. Register gesture callbacks. Don't worry, these callbacks won't be
     *    executed unless the corresponding feature is enabled.
     * 4. Call dmp_enable_feature(mask) to enable different features.
     * 5. Call dmp_set_fifo_rate(freq) to select a DMP output rate.
     * 6. Call any feature-specific control functions.
     *
     * To enable the DMP, just call mpu_set_dmp_state(1). This function can
     * be called repeatedly to enable and disable the DMP at runtime.
     *
     * The following is a short summary of the features supported in the DMP
     * image provided in inv_mpu_dmp_motion_driver.c:
     * DMP_FEATURE_LP_QUAT: Generate a gyro-only quaternion on the DMP at
     * 200Hz. Integrating the gyro data at higher rates reduces numerical
     * errors (compared to integration on the MCU at a lower sampling rate).
     * DMP_FEATURE_6X_LP_QUAT: Generate a gyro/accel quaternion on the DMP at
     * 200Hz. Cannot be used in combination with DMP_FEATURE_LP_QUAT.
     * DMP_FEATURE_TAP: Detect taps along the X, Y, and Z axes.
     * DMP_FEATURE_ANDROID_ORIENT: Google's screen rotation algorithm. Triggers
     * an event at the four orientations where the screen should rotate.
     * DMP_FEATURE_GYRO_CAL: Calibrates the gyro data after eight seconds of
     * no motion.
     * DMP_FEATURE_SEND_RAW_ACCEL: Add raw accelerometer data to the FIFO.
     * DMP_FEATURE_SEND_RAW_GYRO: Add raw gyro data to the FIFO.
     * DMP_FEATURE_SEND_CAL_GYRO: Add calibrated gyro data to the FIFO. Cannot
     * be used in combination with DMP_FEATURE_SEND_RAW_GYRO.
     */
    result += dmp_load_motion_driver_firmware();
    result += dmp_set_orientation(
        inv_orientation_matrix_to_scalar(gyro_orientation));
    result += dmp_register_tap_cb(tap_cb);
    result += dmp_register_android_orient_cb(android_orient_cb);
    hal.dmp_features = DMP_FEATURE_6X_LP_QUAT | DMP_FEATURE_TAP |
        DMP_FEATURE_ANDROID_ORIENT | DMP_FEATURE_SEND_RAW_ACCEL | DMP_FEATURE_SEND_CAL_GYRO |
        DMP_FEATURE_GYRO_CAL;
    result += dmp_enable_feature(hal.dmp_features);
    result += dmp_set_fifo_rate(DEFAULT_MPU_HZ);
    result += mpu_set_dmp_state(1);

    if (result)
        return 0U;

    hal.dmp_on = 1;
    return 1U;
}

void MPU6050_NotifyDataReadyFromIsr(void)
{
    /*
     * GPIO 中断只记录“DMP 有新数据”。
     * 真正的 I2C/DMP FIFO 读取放在主循环里做，避免中断里长时间阻塞编码器计数。
     */
    hal.new_gyro = 1U;
}

uint8_t MPU6050_UpdateIfDataReady(void)
{
    if ((hal.dmp_on == 0U) || (hal.new_gyro == 0U)) {
        return 0U;
    }

    hal.new_gyro = 0U;
    return (Read_Quad() == 0) ? 1U : 0U;
}

int Read_Quad(void)
{
    /* This function gets new data from the FIFO when the DMP is in
    * use. The FIFO can contain any combination of gyro, accel,
    * quaternion, and gesture data. The sensors parameter tells the
    * caller which data fields were actually populated with new data.
    * For example, if sensors == (INV_XYZ_GYRO | INV_WXYZ_QUAT), then
    * the FIFO isn't being filled with accel data.
    * The driver parses the gesture data to determine if a gesture
    * event has occurred; on an event, the application will be notified
    * via a callback (assuming that a callback function was properly
    * registered). The more parameter is non-zero if there are
    * leftover packets in the FIFO.
    */

    int result;
    uint8_t fifo_drain_count = 0U;

    do
    {
        result = dmp_read_fifo(gyro, accel, quat, &sensor_timestamp, &sensors, &more);
        fifo_drain_count++;

        if (fifo_drain_count >= MPU6050_FIFO_DRAIN_LIMIT) {
            break;
        }
    }while(more);

    if(result)
        return -1;

    float q0 = quat[0] / q30;
    float q1 = quat[1] / q30;
    float q2 = quat[2] / q30;
    float q3 = quat[3] / q30;

    pitch  = asinf(-2.0f * q1 * q3 + 2.0f * q0 * q2) * 57.29578f;
    roll   = atan2f(2.0f * q2 * q3 + 2.0f * q0 * q1,
                    -2.0f * q1 * q1 - 2.0f * q2 * q2 + 1.0f) * 57.29578f;
    yaw    = atan2f(2.0f * (q1 * q2 + q0 * q3),
                    q0 * q0 + q1 * q1 - q2 * q2 - q3 * q3) * 57.29578f;

    return 0;
}
