pkppkqsmall/MSPM0G3507-NUEDC-H-Ball-Car/Firmware/Drivers/MPU6050/mspm0_i2c.c

#include "ti_msp_dl_config.h"
#include "clock.h"
#include "mspm0_i2c.h"

#define I2C_TIMEOUT_MS  (10)

static int mspm0_i2c_has_timed_out(unsigned long start)
{
    unsigned long now;

    mspm0_get_clock_ms(&now);
    return ((now - start) >= I2C_TIMEOUT_MS) ? 1 : 0;
}

static int mspm0_i2c_disable(void)
{
    DL_I2C_reset(I2C_MPU6050_INST);
    DL_GPIO_initDigitalOutput(GPIO_I2C_MPU6050_IOMUX_SCL);
    DL_GPIO_initDigitalInputFeatures(GPIO_I2C_MPU6050_IOMUX_SDA,
		 DL_GPIO_INVERSION_DISABLE, DL_GPIO_RESISTOR_NONE,
		 DL_GPIO_HYSTERESIS_DISABLE, DL_GPIO_WAKEUP_DISABLE);
    DL_GPIO_clearPins(GPIO_I2C_MPU6050_SCL_PORT, GPIO_I2C_MPU6050_SCL_PIN);
    DL_GPIO_enableOutput(GPIO_I2C_MPU6050_SCL_PORT, GPIO_I2C_MPU6050_SCL_PIN);
    return 0;
}

static int mspm0_i2c_enable(void)
{
    DL_I2C_reset(I2C_MPU6050_INST);
    DL_GPIO_initPeripheralInputFunctionFeatures(GPIO_I2C_MPU6050_IOMUX_SDA,
        GPIO_I2C_MPU6050_IOMUX_SDA_FUNC, DL_GPIO_INVERSION_DISABLE,
        DL_GPIO_RESISTOR_NONE, DL_GPIO_HYSTERESIS_DISABLE,
        DL_GPIO_WAKEUP_DISABLE);
    DL_GPIO_initPeripheralInputFunctionFeatures(GPIO_I2C_MPU6050_IOMUX_SCL,
        GPIO_I2C_MPU6050_IOMUX_SCL_FUNC, DL_GPIO_INVERSION_DISABLE,
        DL_GPIO_RESISTOR_NONE, DL_GPIO_HYSTERESIS_DISABLE,
        DL_GPIO_WAKEUP_DISABLE);
    DL_GPIO_enableHiZ(GPIO_I2C_MPU6050_IOMUX_SDA);
    DL_GPIO_enableHiZ(GPIO_I2C_MPU6050_IOMUX_SCL);
    DL_I2C_enablePower(I2C_MPU6050_INST);
    SYSCFG_DL_I2C_MPU6050_init();
    return 0;
}

static int mspm0_i2c_wait_controller_idle(void)
{
    unsigned long start;

    mspm0_get_clock_ms(&start);
    while (!(DL_I2C_getControllerStatus(I2C_MPU6050_INST) & DL_I2C_CONTROLLER_STATUS_IDLE)) {
        if (mspm0_i2c_has_timed_out(start) != 0) {
            mpu6050_i2c_sda_unlock();
            return -1;
        }
    }

    return 0;
}

void mpu6050_i2c_sda_unlock(void)
{
    uint8_t cycleCnt = 0;
    mspm0_i2c_disable();
    do
    {
        DL_GPIO_clearPins(GPIO_I2C_MPU6050_SCL_PORT, GPIO_I2C_MPU6050_SCL_PIN);
        mspm0_delay_ms(1);
        DL_GPIO_setPins(GPIO_I2C_MPU6050_SCL_PORT, GPIO_I2C_MPU6050_SCL_PIN);
        mspm0_delay_ms(1);

        if(DL_GPIO_readPins(GPIO_I2C_MPU6050_SDA_PORT, GPIO_I2C_MPU6050_SDA_PIN))
            break;
    }while(++cycleCnt < 100);
    mspm0_i2c_enable();
}

int mspm0_i2c_write(unsigned char slave_addr,
                     unsigned char reg_addr,
                     unsigned char length,
                     unsigned char const *data)
{
    unsigned int cnt = length;
    unsigned char const *ptr = data;
    unsigned long start;

    if (!length)
        return 0;

    if (data == 0)
        return -1;

    DL_I2C_transmitControllerData(I2C_MPU6050_INST, reg_addr);
    DL_I2C_clearInterruptStatus(I2C_MPU6050_INST, DL_I2C_INTERRUPT_CONTROLLER_TX_DONE);

    if (mspm0_i2c_wait_controller_idle() != 0)
        return -1;

    DL_I2C_startControllerTransfer(I2C_MPU6050_INST, slave_addr, DL_I2C_CONTROLLER_DIRECTION_TX, length+1);

    mspm0_get_clock_ms(&start);
    do {
        unsigned fillcnt;
        fillcnt = DL_I2C_fillControllerTXFIFO(I2C_MPU6050_INST, ptr, cnt);
        cnt -= fillcnt;
        ptr += fillcnt;

        if(mspm0_i2c_has_timed_out(start) != 0)
        {
            mpu6050_i2c_sda_unlock();
            return -1;
        }
    } while (!DL_I2C_getRawInterruptStatus(I2C_MPU6050_INST, DL_I2C_INTERRUPT_CONTROLLER_TX_DONE));

    return 0;
}

int mspm0_i2c_read(unsigned char slave_addr,
                    unsigned char reg_addr,
                    unsigned char length,
                    unsigned char *data)
{
    unsigned i = 0;
    unsigned long start;

    if (!length)
        return 0;

    if (data == 0)
        return -1;

    DL_I2C_transmitControllerData(I2C_MPU6050_INST, reg_addr);
    I2C_MPU6050_INST->MASTER.MCTR = I2C_MCTR_RD_ON_TXEMPTY_ENABLE;
    DL_I2C_clearInterruptStatus(I2C_MPU6050_INST, DL_I2C_INTERRUPT_CONTROLLER_RX_DONE);

    if (mspm0_i2c_wait_controller_idle() != 0) {
        I2C_MPU6050_INST->MASTER.MCTR = 0;
        return -1;
    }

    DL_I2C_startControllerTransfer(I2C_MPU6050_INST, slave_addr, DL_I2C_CONTROLLER_DIRECTION_RX, length);

    mspm0_get_clock_ms(&start);
    do {
        if (!DL_I2C_isControllerRXFIFOEmpty(I2C_MPU6050_INST))
        {
            uint8_t c;
            c = DL_I2C_receiveControllerData(I2C_MPU6050_INST);
            if (i < length)
            {
                data[i] = c;
                ++i;
            }
        }
        
        if(mspm0_i2c_has_timed_out(start) != 0)
        {
            I2C_MPU6050_INST->MASTER.MCTR = 0;
            mpu6050_i2c_sda_unlock();
            return -1;
        }
    } while(!DL_I2C_getRawInterruptStatus(I2C_MPU6050_INST, DL_I2C_INTERRUPT_CONTROLLER_RX_DONE));

    if (!DL_I2C_isControllerRXFIFOEmpty(I2C_MPU6050_INST))
    {
        uint8_t c;
        c = DL_I2C_receiveControllerData(I2C_MPU6050_INST);
        if (i < length)
        {
            data[i] = c;
            ++i;
        }
    }

    I2C_MPU6050_INST->MASTER.MCTR = 0;
    DL_I2C_flushControllerTXFIFO(I2C_MPU6050_INST);

    if(i == length)
        return 0;
    else
        return -1;
}
